jamestorrissonwong/NML-CAD/Fridge Lock and Mount/fridge render.png

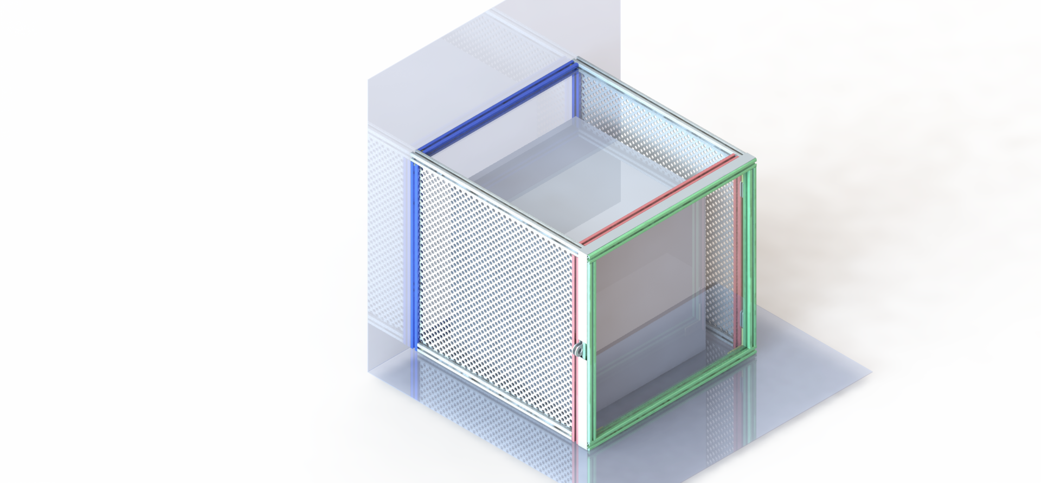
Fridge Lock and Mount/fridge render.png
