jamestorrissonwong/NML-CAD/EMGcuff.pptx

## EMG cuff Project

5/15/2021

Notes: wired connection between Myoware and arduino.
Include IMU

## Goal

- Design, build, and test a wearable sensor for measuring muscle activity in the forearm.

## Components

- Garment: Lightweight and comfortable cuff made of stretchable material that conforms to the forearm
- EMG Sensors: x4 Myoware (https://www.sparkfun.com/products/13723) (https://www.sparkfun.com/products/13723)sensors for measuring EMG; attached to lining of garment
- Microcontroller: Arduino or Raspberry Pi (Zero W), for collecting EMG signals from the EMG sensors
  - Controller Software
- Host: laptop or tablet
  - User Interface Software

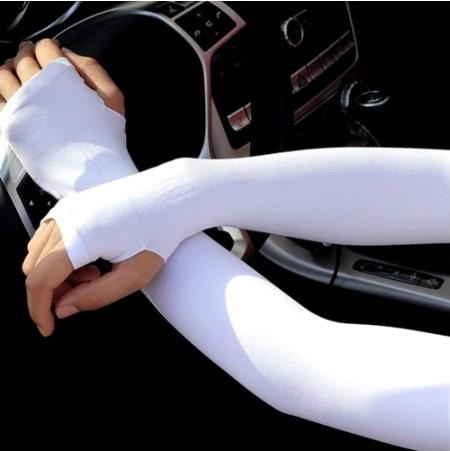
[picture p6: figure]
UV Protection Clothing Sun Sleeves
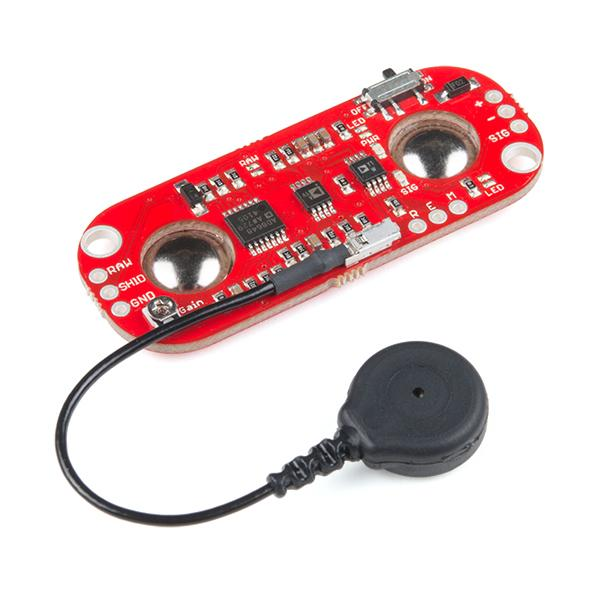
[picture p7: figure]
MyoWare Muscle Sensor
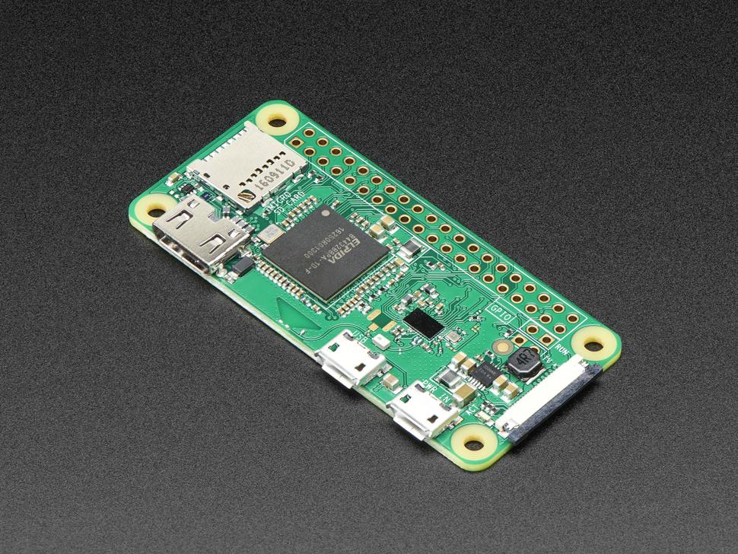
[picture p8: figure]
Angled shot of Raspberry Pi Zero W computer.
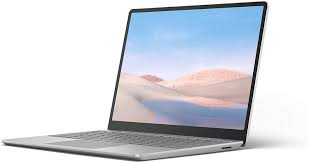
[picture p9: figure]
Amazon.com: Microsoft Surface Laptop Go - 12.4" Touchscreen - Intel Core i5 - 8GB Memory - 128GB SSD - Platinum: Computers & Accessories

## Recommended Software

- Autodesk tools
  - Electrical Design: TinkerCAD
  - Mechanical Design: Fusion360 OR Autodesk Inventor
- https://www.autodesk.com/education/edu-software/overview?sorting=featured&page=1

## Mechanical Goals

- Choose sleeve
- Determine how to attach electronics
- Can you ensure good contact between sensor & arm?
- Consider using CAD software to visual positioning of sensors, microcontroller, and wiring

## Electrical Goals

- Wiring between sensors and microcontroller
- Going from wired to wireless operations between microcontroller and host computer

## Programming Goals

- Collection of data from the EMG
- Classification of EMG data to different poses
