jamestorrissonwong/NML-CAD/Monkey Cage Training/ICTS Design.pdf

## Monkey ICTS

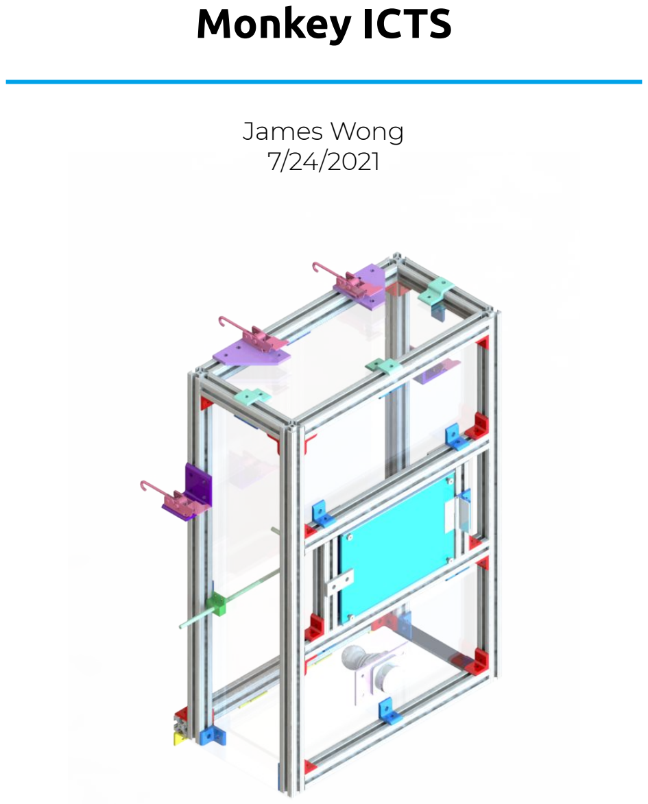
[picture p11: page 1]

James Wong
7/24/2021

### Overview

- Materials
- Attachment Method
- Reward System
- Screen Operation
- Optional Joystick

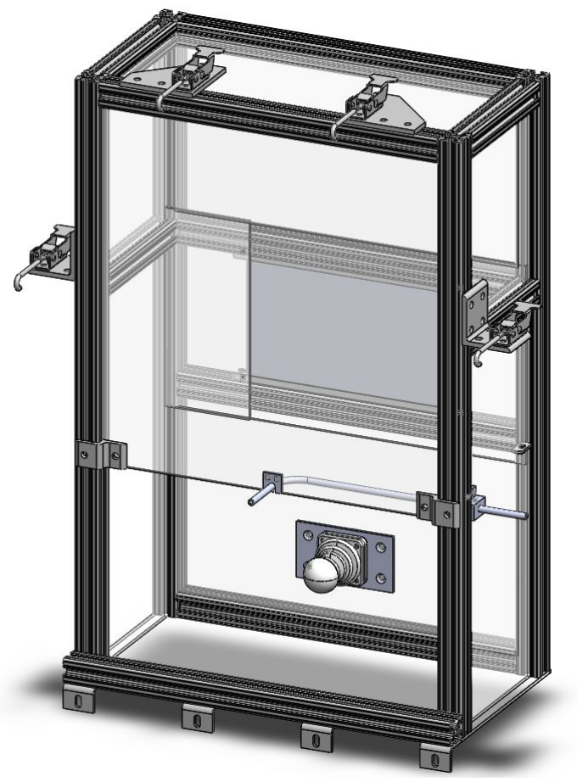
[picture p12: figure]

### Materials

- Framing made of 8020
- Enclosed on all sides by ⅛” polycarbonate (or acrylic)
- Some custom machined parts for reward system, tablet holder

BOM outlined below

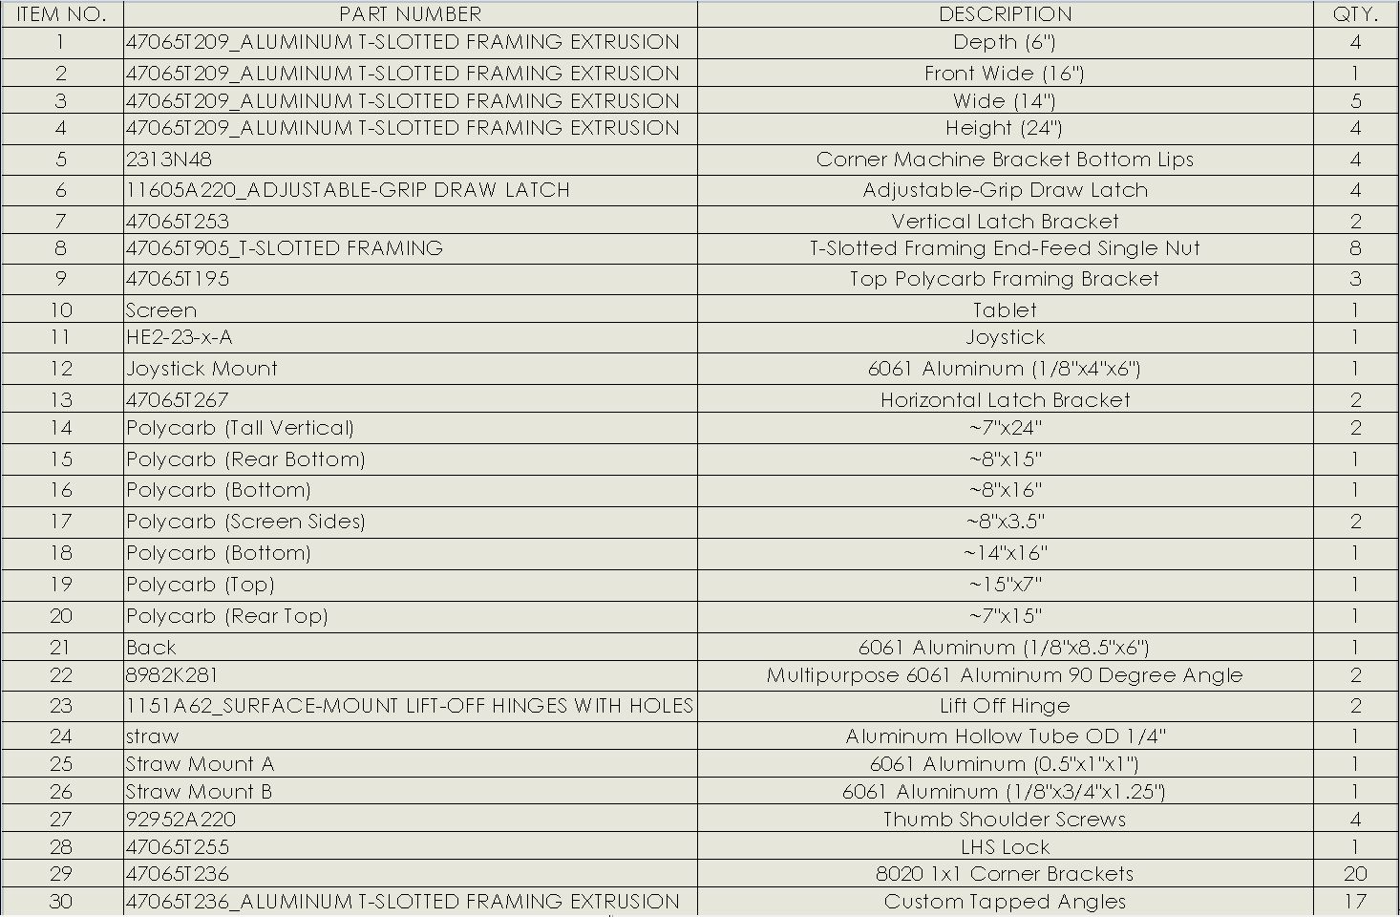
[picture p13: figure]

### Attachment Method

- Weight is carried primarily along bottom brackets (yellow)
- Latches (pink) provide additional support and contacts to the cage
- Adjustment to latches is available in vertical (dark purple) and horizontal (light purple) to accommodate different cage sizes

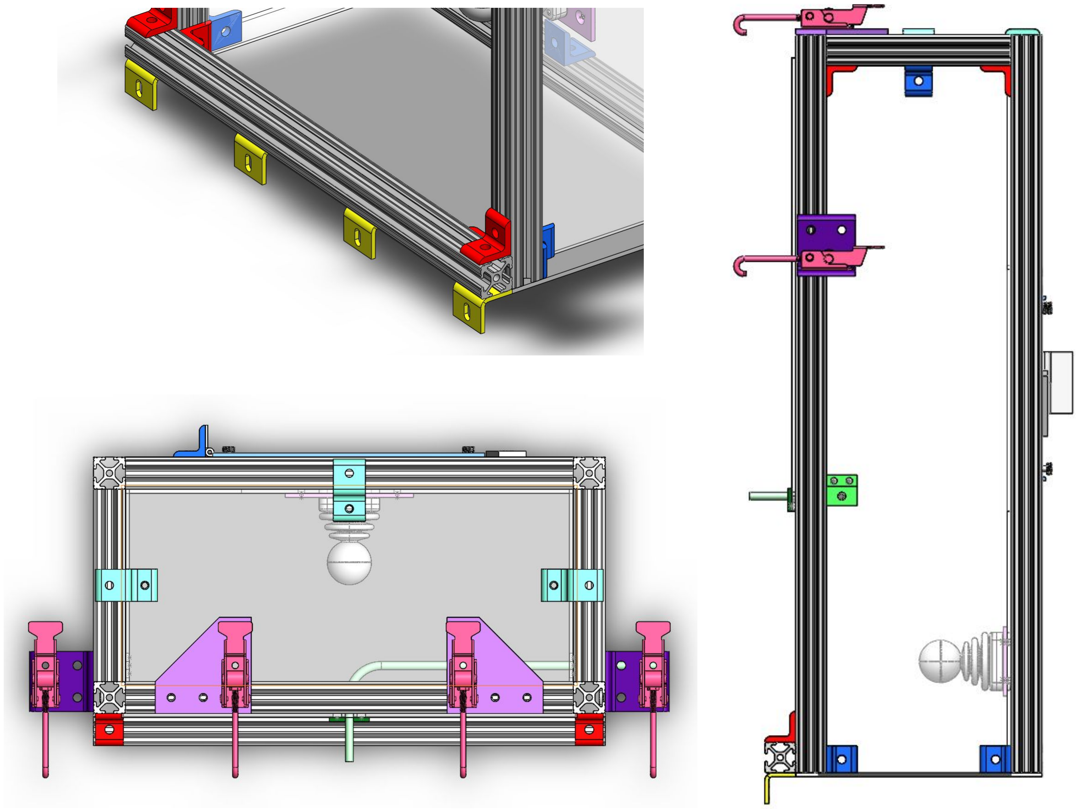
[picture p14: figure]
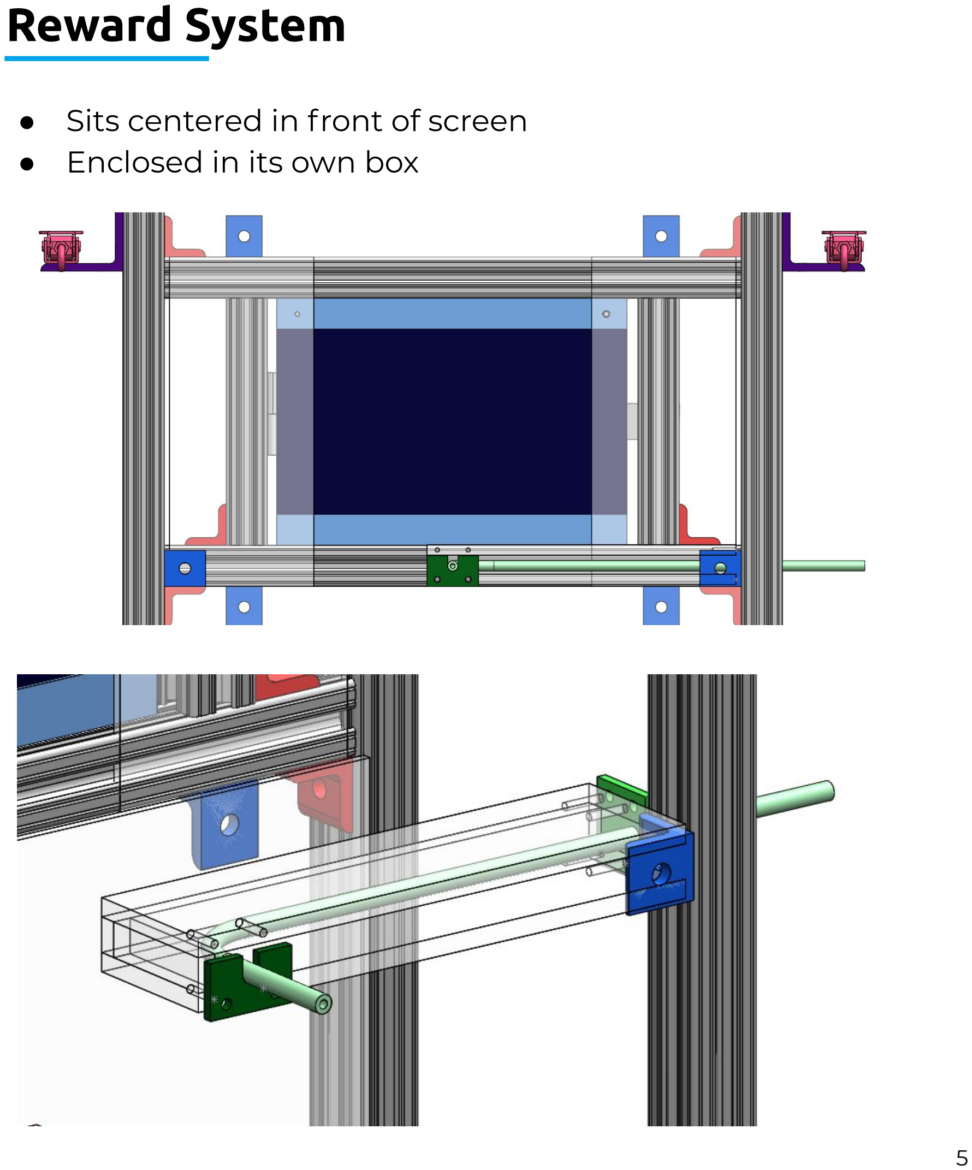
[picture p15: page 5]

### Reward System

- Sits centered in front of screen
- Enclosed in its own box

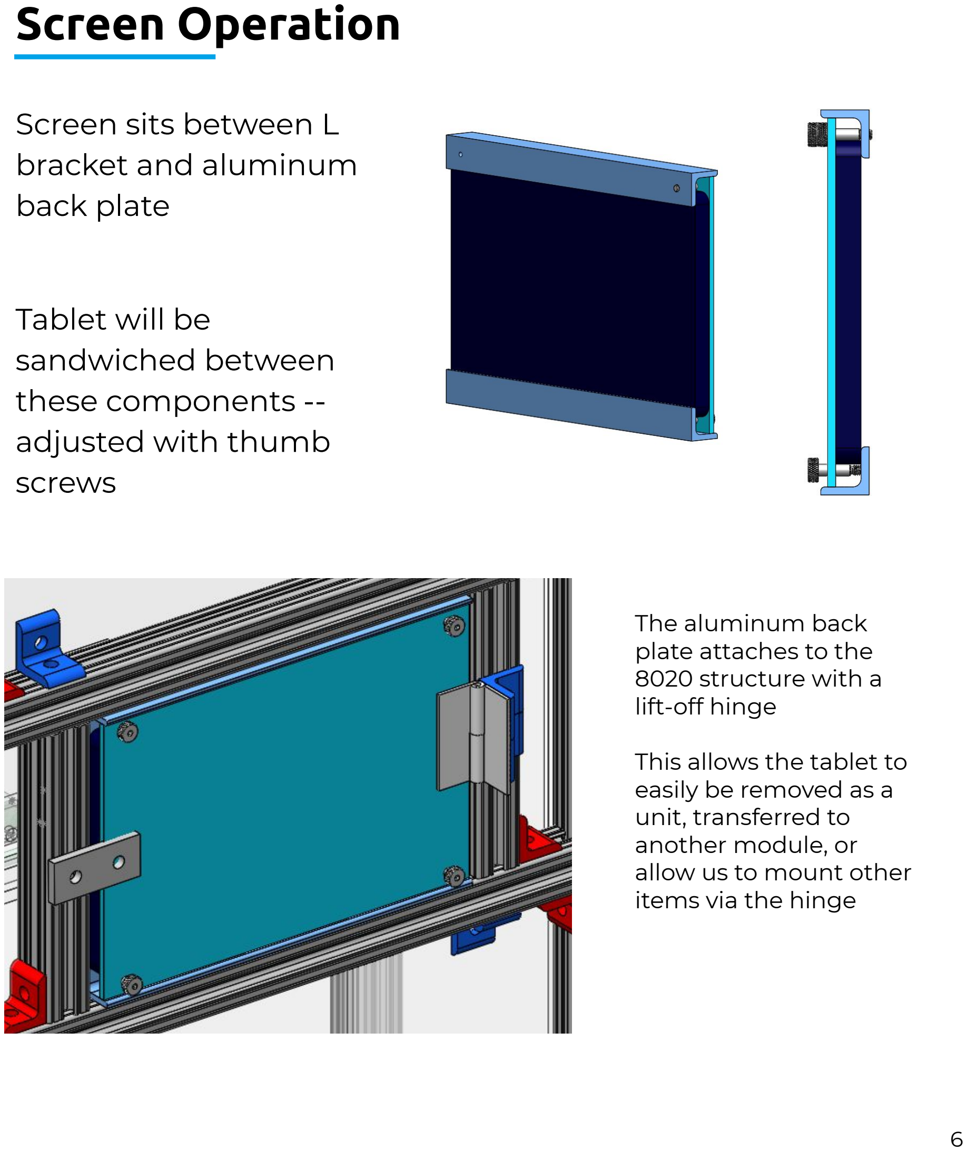
[picture p16: page 6]

### Screen Operation

Screen sits between L
bracket and aluminum
back plate

Tablet will be
sandwiched between
these components --
adjusted with thumb
screws

The aluminum back
plate attaches to the
8020 structure with a
lift-off hinge

This allows the tablet to
easily be removed as a
unit, transferred to
another module, or
allow us to mount other
items via the hinge

### Screen Operation

Click for animation

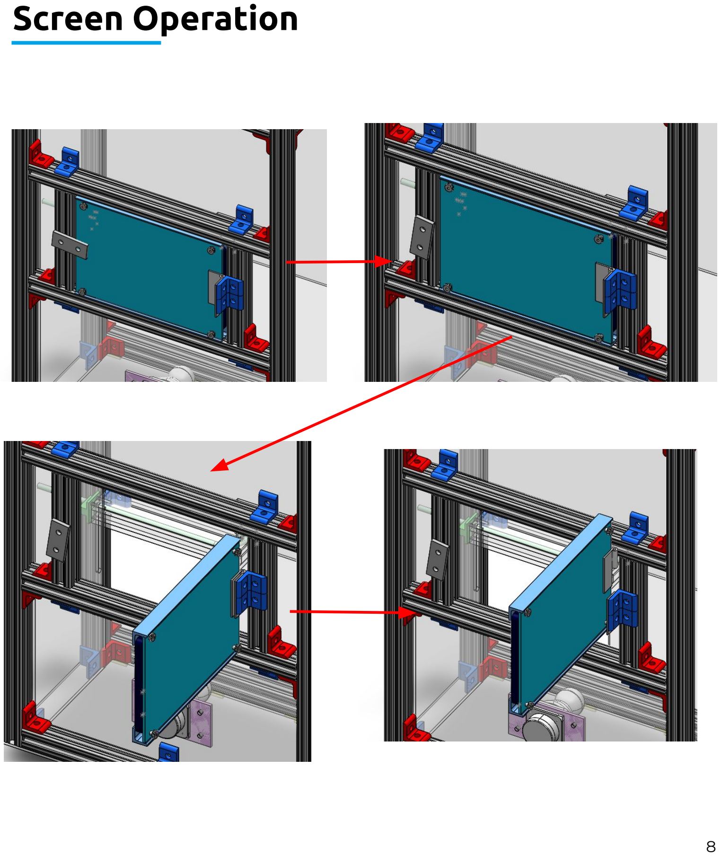
[picture p17: page 8]

### Screen Operation

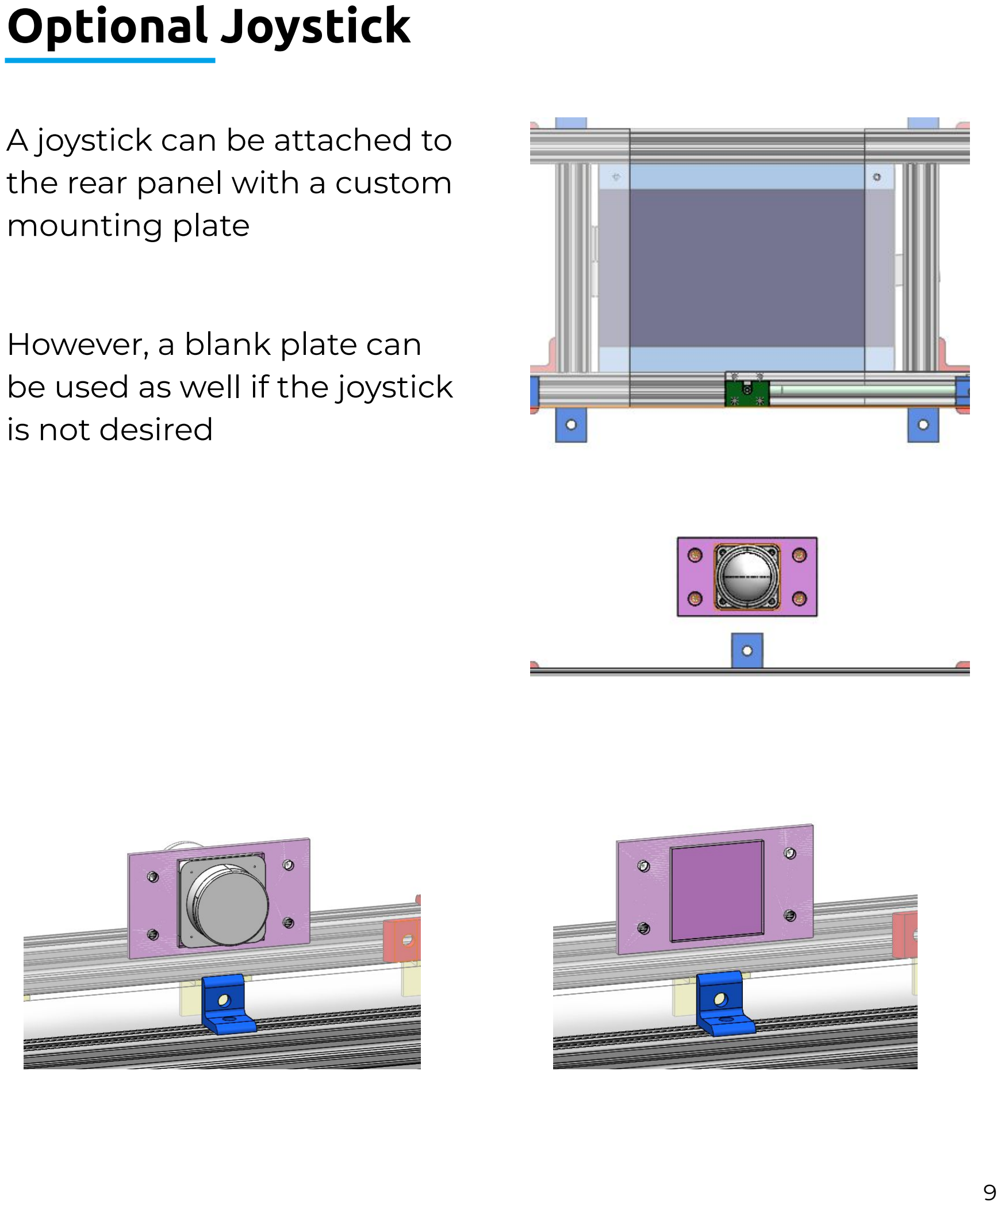
[picture p18: page 9]

### Optional Joystick

A joystick can be attached to the rear panel with a custom mounting plate

However, a blank plate can be used as well if the joystick is not desired
