jamestorrissonwong/NML-CAD/Monkey Cage Training/Cage opening dimensions.pdf

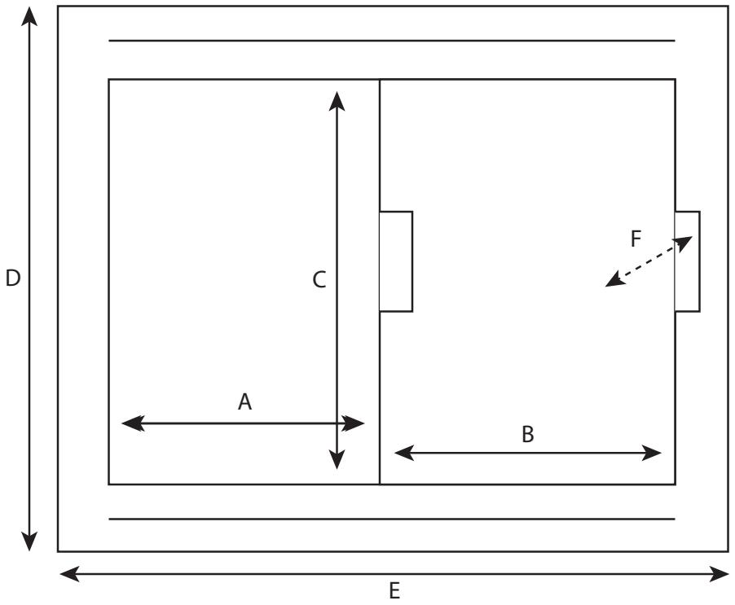
[picture p24: figure]

There are three dierent cage types in the vivarium. Thus, each letter has three dimensions. If we use springs with hooks to attach the device to the cage we should be able to accommodate the dierences for dimensions D & E. Below I am providing the smallest and largest dimension.

A = 10” - 12”
B = 10 4/16 - 14”
C = 17 14/16 - 18 12/16”
D = 20 2/16” - 20 8/16”
E = 22” - 22 4/16”
F = 3”
