jamestorrissonwong/NML-CAD/Proforma  Invoice - 20210621212100.pdf

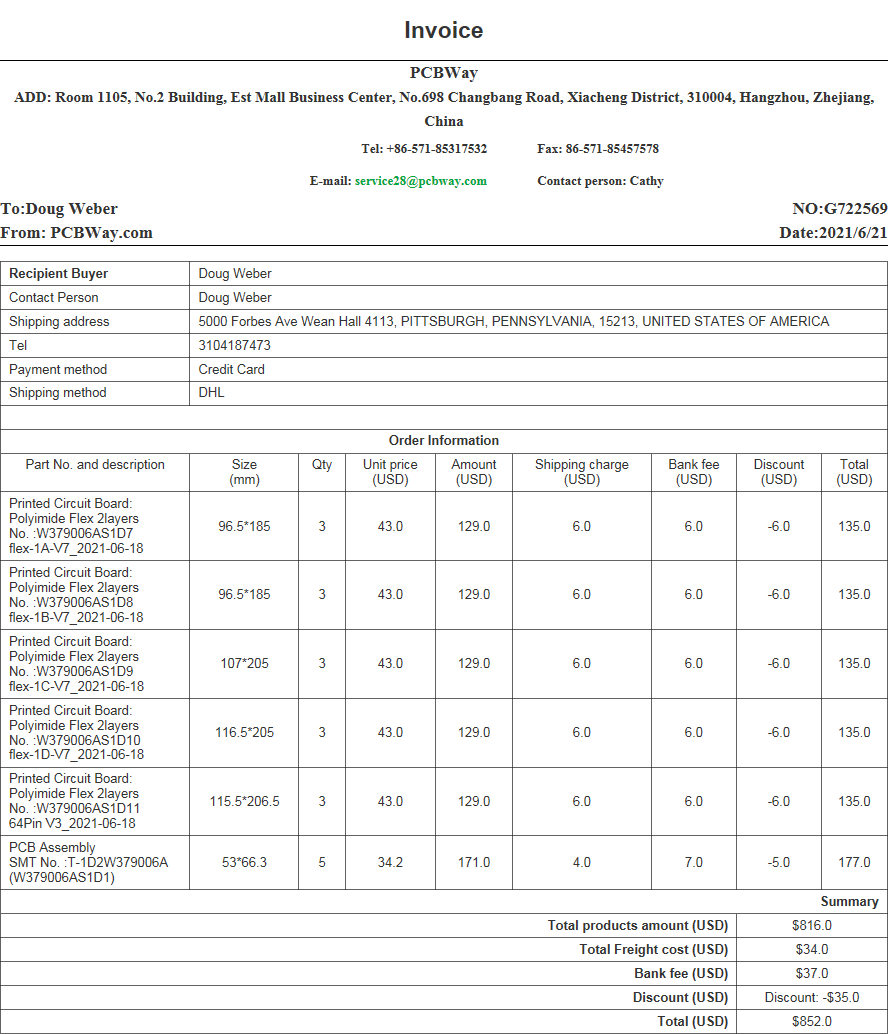
[picture p25: page 1]
