jamestorrissonwong/NML-CAD/Monkey Cage Training/ICTS dimensions.pdf

# InCage Training System

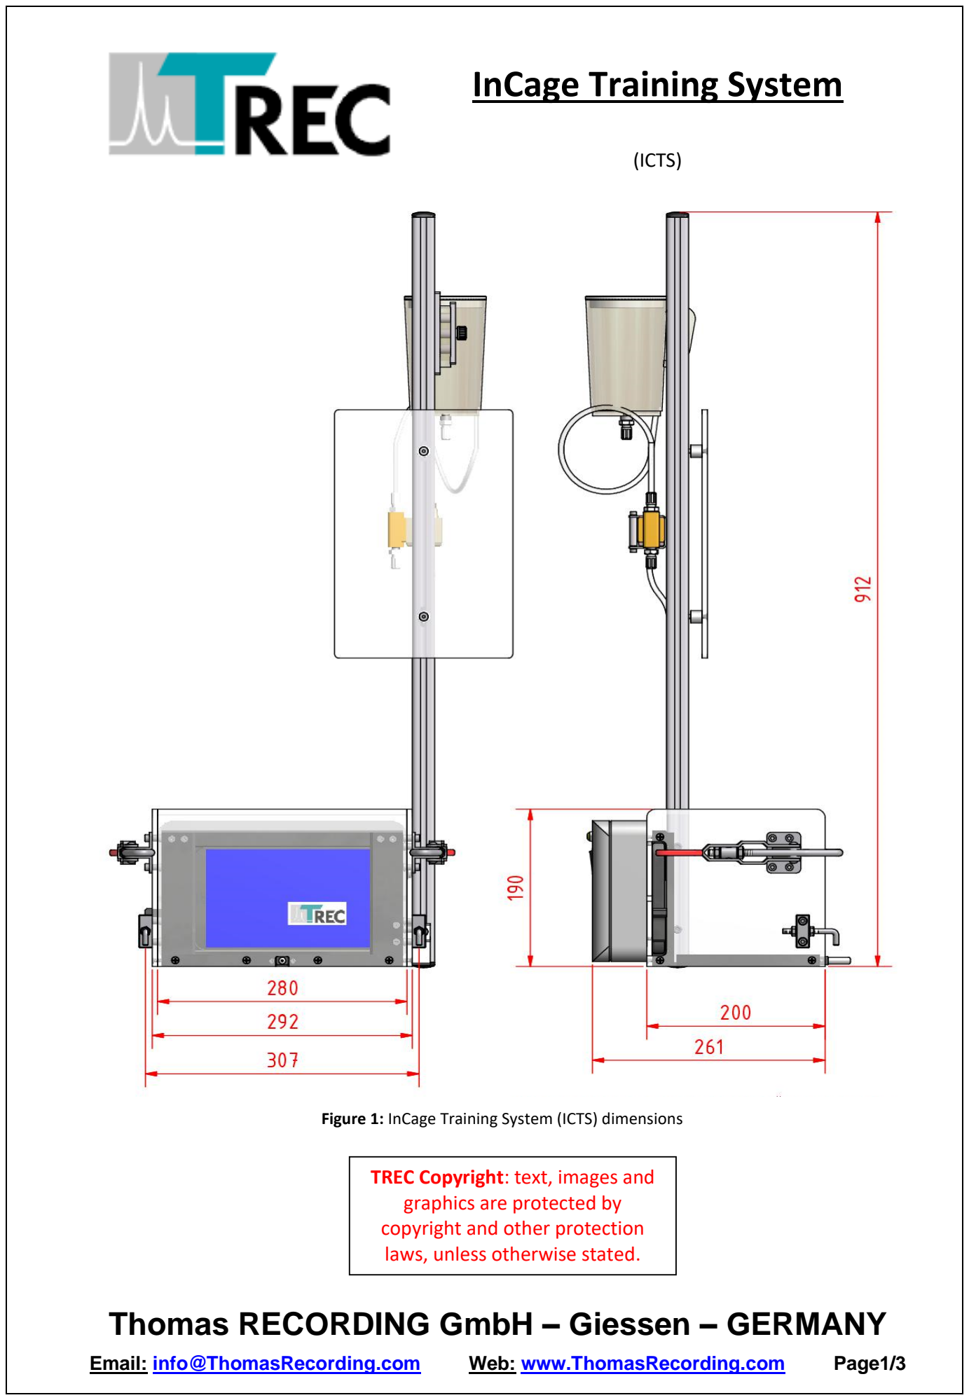
[picture p26: page 1]

## Thomas RECORDING GmbH – Giessen – GERMANY

Email: info@ThomasRecording.com | Web: www.ThomasRecording.com | Page1/3

(ICTS)

Figure 1: InCage Training System (ICTS) dimensions

TREC Copyright: text, images and graphics are protected by
copyright and other protection laws, unless otherwise stated.

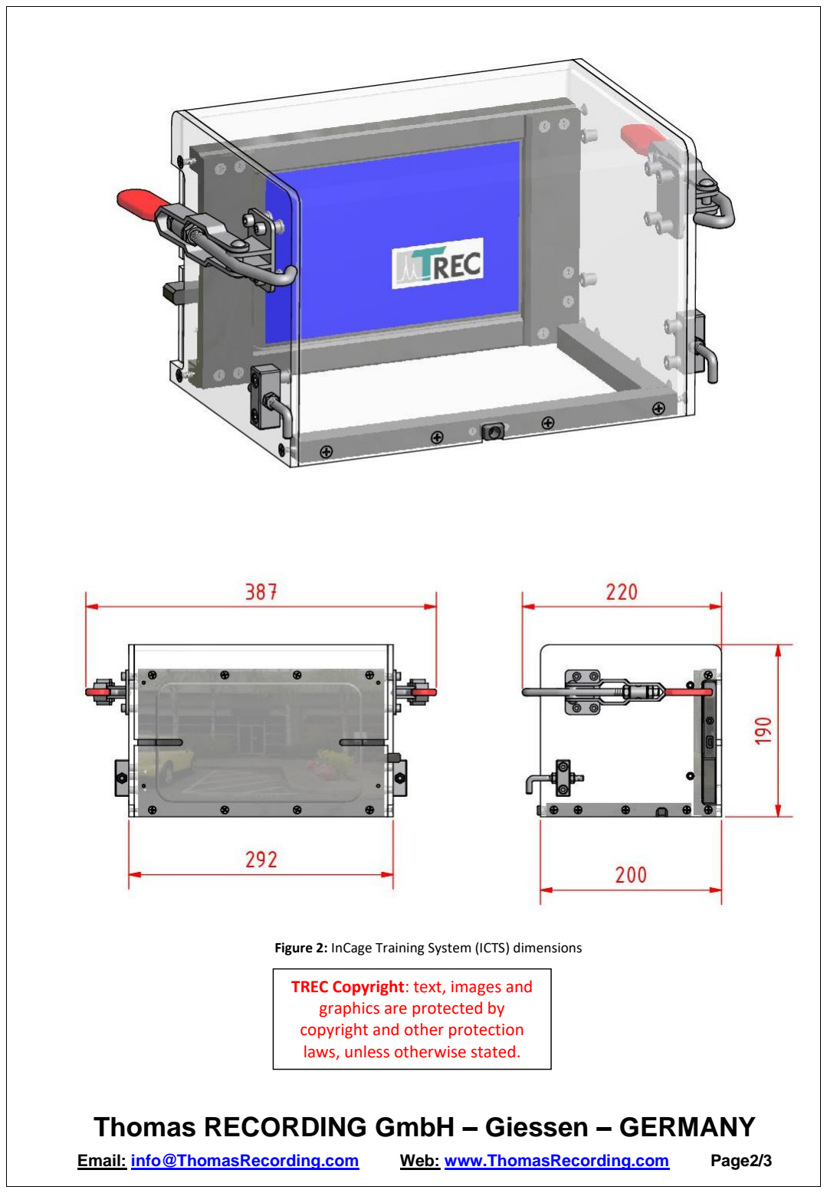
[picture p27: page 2]

Email: info@ThomasRecording.com | Web: www.ThomasRecording.com | Page2/3

Figure 2: InCage Training System (ICTS) dimensions

TREC Copyright: text, images and graphics are protected by
copyright and other protection
laws, unless otherwise stated.

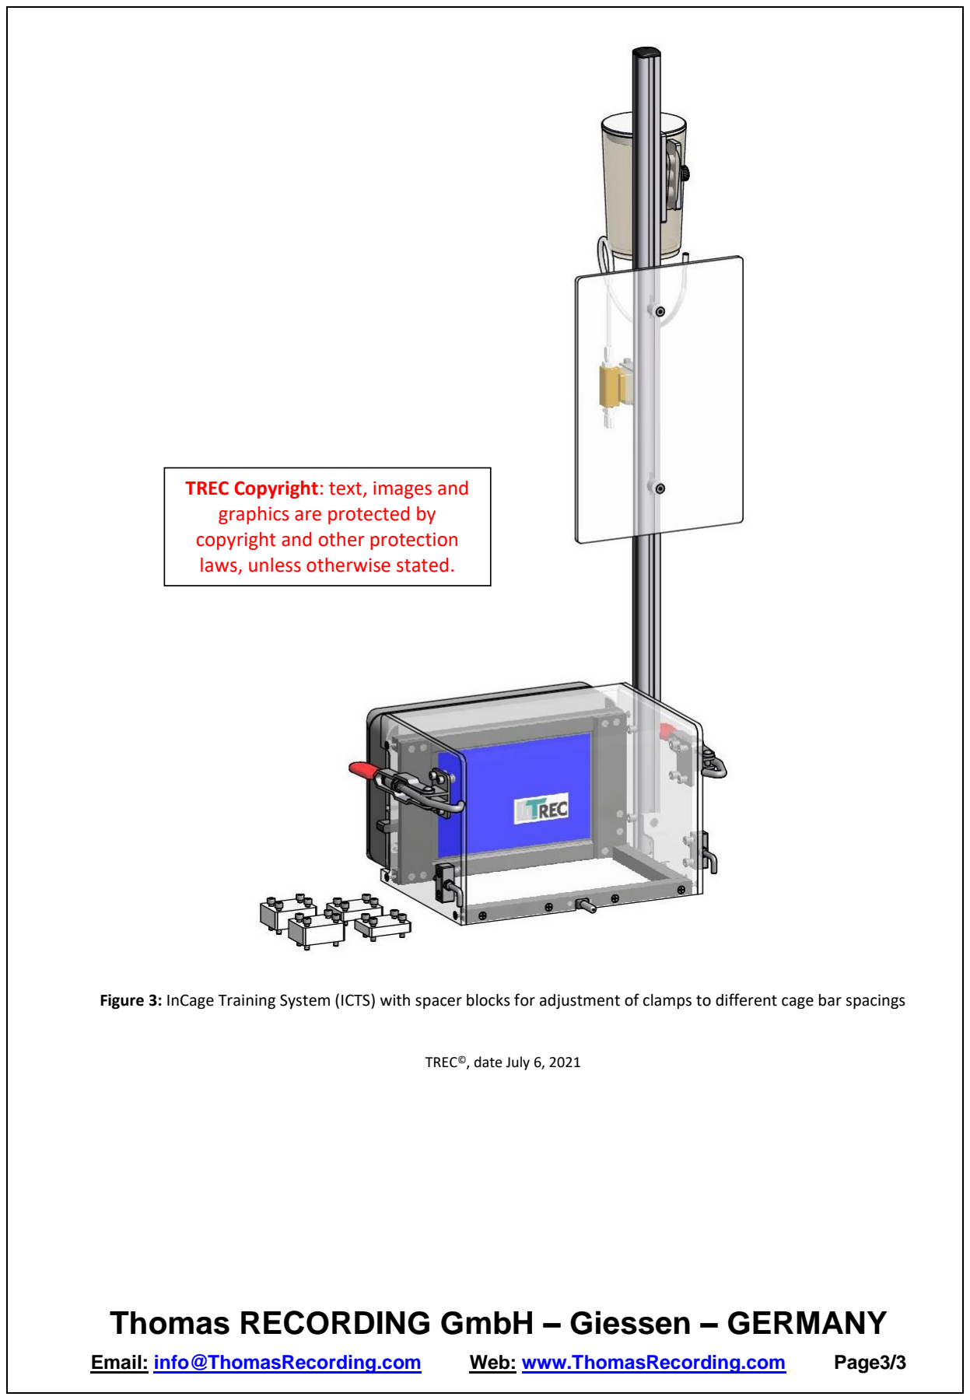
[picture p28: page 3]

Email: info@ThomasRecording.com | Web: www.ThomasRecording.com | Page3/3

Figure 3: InCage Training System (ICTS) with spacer blocks for adjustment of clamps to different cage bar spacings

TREC©, date July 6, 2021

TREC Copyright: text, images and graphics are protected by
copyright and other protection laws, unless otherwise stated.
