jamestorrissonwong/NML-CAD/Manips/Human Manip/Manip Render.png

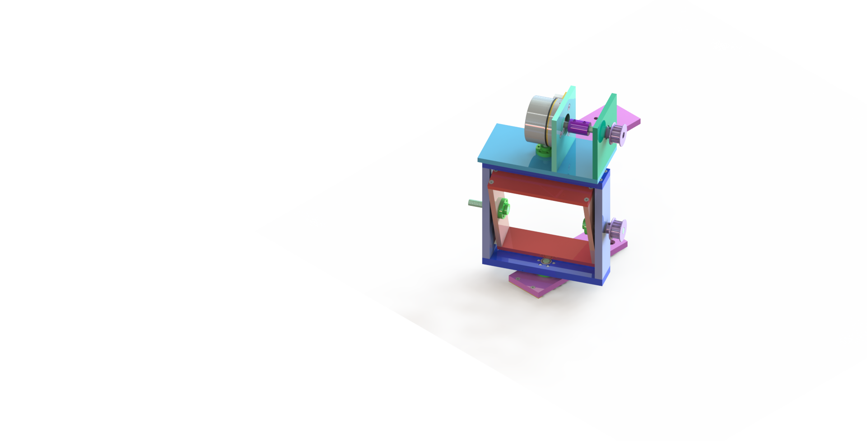
Manips/Human Manip/Manip Render.png
