jamestorrissonwong/NML-CAD/Monkey Cage Training/Monkey Cage Extension/ICTS Render.JPG

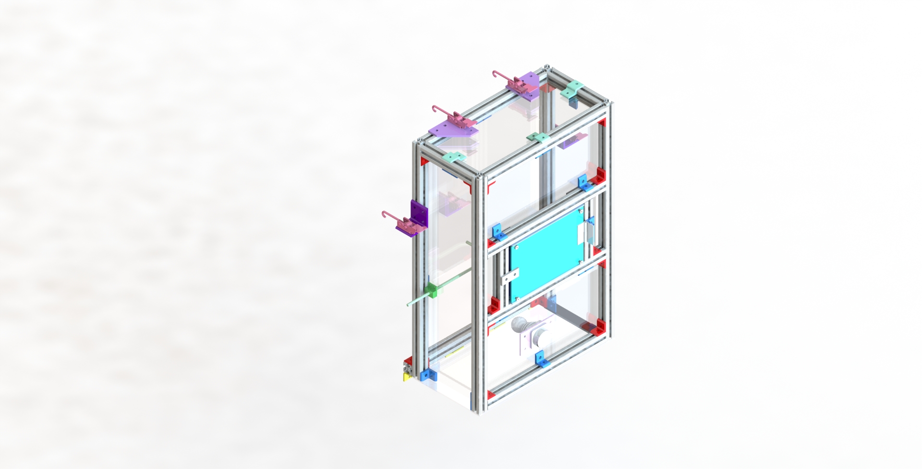
Monkey Cage Training/Monkey Cage Extension/ICTS Render.JPG
