jamestorrissonwong/NML-CAD/Monkey Cage Training/Monkey Cage Extension/ICTS Render.png

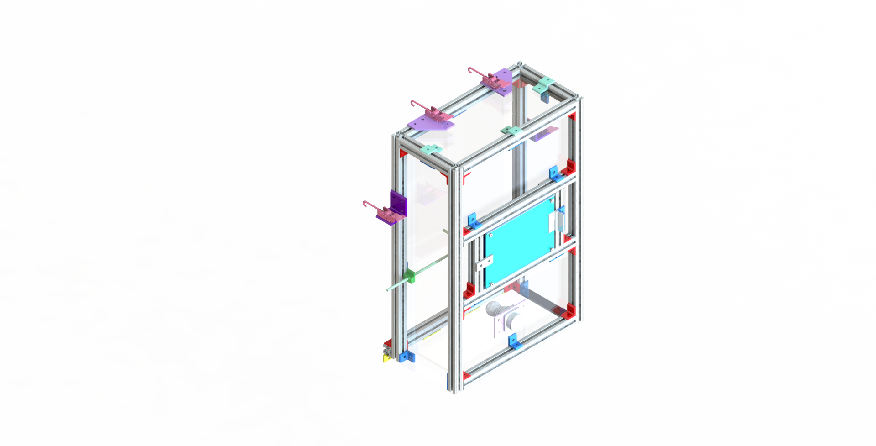
Monkey Cage Training/Monkey Cage Extension/ICTS Render.png
