jamestorrissonwong/NML-CAD/Purchase_RequestFORM -Fall 2021 Final.pdf

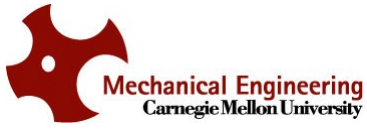
[picture p32: figure]

Requestor:
Date:
Email:
Phone Number:
Vendor:
Contact Name:
Email:
Address:
City, State, Zip:
Country:
Phone:
Website:

Sub-total:
Shipping:
Grand Total:

## Course Purchasing Request Form

5000 Forbes Avenue, Wean Hall Pittsburgh, PA 15213

Phone: 412-268-2500
Fax: 412-268-3348
www.cmu.edu/me
Professor:
Account:
Ship To:
Needed by:
Professor Approved?
Hazardous Material?
Purchase > $2500?
| | [ ] Yes | [ ] No
| | [ ] Yes | [ ] No
| | [ ] Yes | [ ] No
Quote Attached? | [ ] Yes | [ ] No
Part# | Description | Quantity Unit Price | Total

Justification for Purchase:

Notes: | SUBMIT ALL REQUESTS TO: MechE Purchasing me-purchasing@andrew.cmu.edu

updated 8/23/2021

also include a DIRECT link to the item on webpage.
