jamestorrissonwong/NML-CAD/Purchasing Request Form 2020 Manip 1.pdf

## Purchasing Request

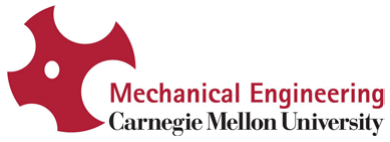
[picture p33: figure]
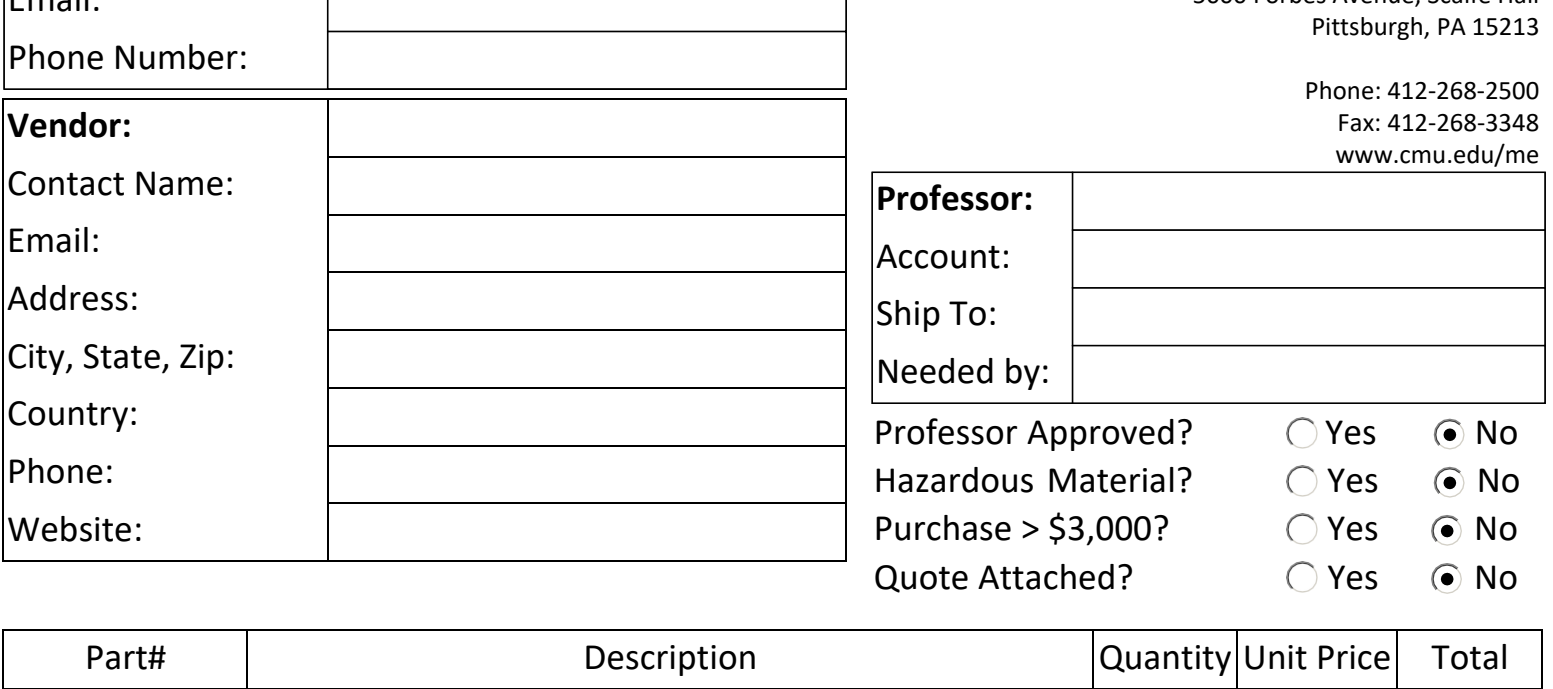
[picture p34: figure]
Pittsburgh, PA 15213; Phone: 412-268-2500 Fax: 412-268-3348 www.cmu.edu/me; Professor Approved? Hazardous Material? Purchase > $3,000?; Yes; Quote Attached?; Part#; Description; Quantity Unit Price; Total; Professor: Account: Ship To: Needed by:; Phone Number: Vendor: Contact Name: Email: Address: City, State, Zip: Country: Phone: Website:

5000 Forbes Avenue, Scaife Hall

Justification for Purchase:

Notes: Line Item 1 from: https://odriverobotics.com/shop/odrive-v36 Line Item 2 from: https://www.maxongroup.com/maxon/view/product/625854 Line Item 3 from: https://www.amazon.com/gp/product/B01IU8QBCO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 Line Item 4 from: https://www.pololu.com/product/2693 Remaining from McMaster

me-purchasing@andrew.cmu.edu

updated 08/01/2020

Requestor: James Wong
Date:
Email: 7/20/2021 JTW2@andrew.cmu.edu

Submit by Email

Sub-total:
Shipping:
Grand Total:
