jamestorrissonwong/NML-CAD/questions-T-1D2W379006A-W379006AS1D1-5sets-Intan Headstage BOM   2021-6-11.xlsx

 |  |  | COMPONENTS
5sets |  | Reply | Line | Name | Description | Designator | Quantity | Manufacturer | MPN | Type | Package/Footprint | Supplier | SPN
 | out of stock,is there any replacement? | We have some of these components, can do partial kitted assembly | 1 | Molex Slimstack | Male Connector | J1, J2 | 2 | Molex | 502430-6410 | SMD | SMD | Mouser | 538-50243-06412
$1.417 | 7-10work days |  | 2 | Molex ZIF Connector | 32 Pin ZIF Connector | P1, P2, P3, P4 | 4 | Molex | 505110-3291 | SMD | SMD | Mouser | 538-505110-3291
 | out of stock,is there any replacement? | We have some of these components, can do partial kitted assembly | 3 | Touchproof Connector | Grounding Connector | J3, J4 | 2 | P1 Tec | 36619 | PTH |  | P1 Tec | 36619
 |  |  | LAYER STACK
 |  |  |  | File Name | Description | Material | Thicnkess
 |  |  |  | silkscreen_top.gbr | Top Silkscreen
 |  |  |  | soldermask_top.gbr | Top Soldermask | Soldermask
 |  |  |  | copper_top.gbr | Top Copper, 1 | Copper | 1 oz
 |  |  |  |  | Core | Fr4 (TG130-140)
 |  |  |  | copper_bottom.gbr | Bottom Copper, 2 | Copper | 1 oz
 |  |  |  | soldermask_bottom.gbr | Bottom Soldermask | Soldermask
 |  |  |  | silkscreen_bottom.gbr | Bottom Silkscreen
 |  |  |  | drill_1_16.xln | Drills |  | Through
 |  |  |  | Additional Gerbers
 |  |  |  | profile.gbr | Board Outline
 |  |  |  | solderpaste_top.gbr | Top Paste
 |  |  |  | solderpaste_bottom.gbr | Bottom Paste
provide according to MPN
