jamestorrissonwong/NML-CAD/Fridge Lock and Mount/Fridge Cage.SLDASM

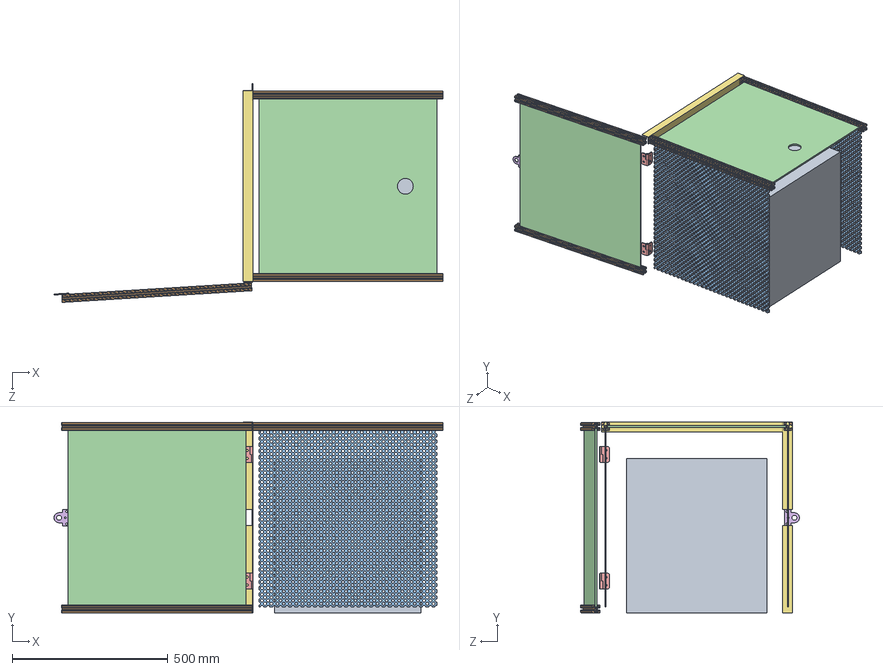
[picture p35: CAD file, 2021-12-15]
Fridge Lock and Mount/Fridge Cage.SLDASM
1247.3 x 611.2 x 701.9 mm
Fridge
47065T209_ALUMINUM T-SLOTTED FRAMING EXTRUSION x 4
47065T901_ALUMINUM T-SLOTTED FRAMING EXTRUSION x 2
47065T321_T-SLOTTED FRAMING x 2
47065T343_T-Slotted Framing x 4
1183A110_PADLOCKABLE EYE x 2
8982K602_Multipurpose 6061 Aluminum 90 Degree Angle
