jamestorrissonwong/NML-CAD/Manips/Monkey Manip/Angle A/45 Stop vA.SLDASM

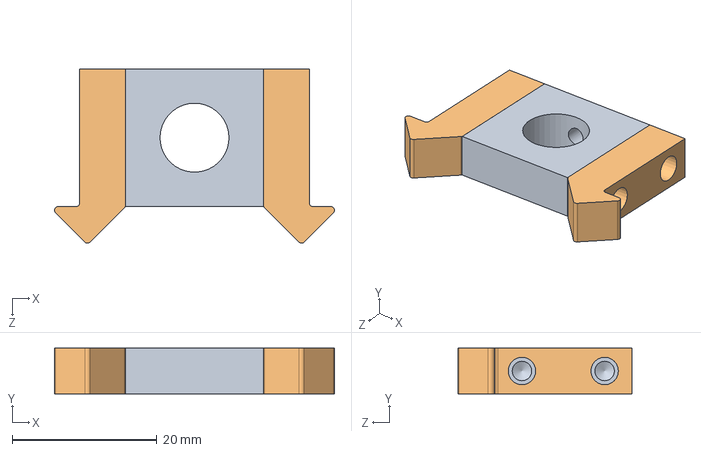
[picture p36: CAD file, 2021-07-24]
Manips/Monkey Manip/Angle A/45 Stop vA.SLDASM
38.7 x 6.35 x 24.1 mm
45 Stop Mid
45 Stop Arm x 2
