jamestorrissonwong/NML-CAD/Manips/Monkey Manip/Angle C/45 Stop vC.SLDASM

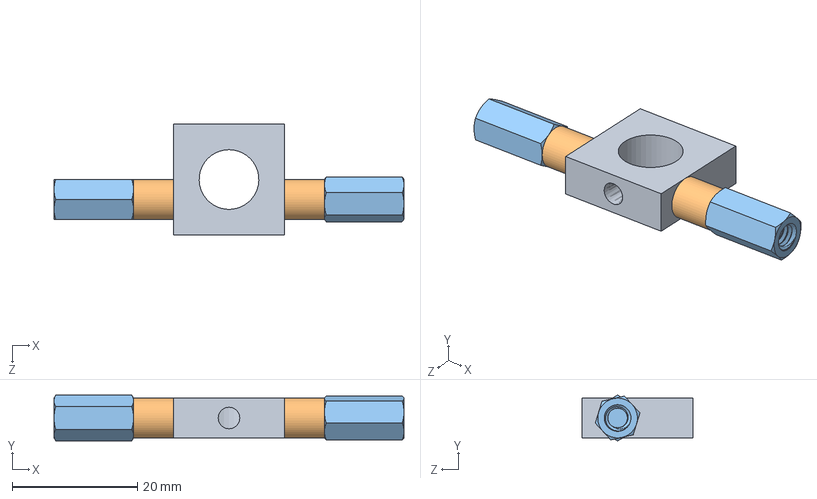
[picture p37: CAD file, 2021-07-24]
Manips/Monkey Manip/Angle C/45 Stop vC.SLDASM
55.9 x 7.33 x 17.8 mm
45 Stop Hub
92510A462_ALUM UNTHRD SPACER x 2
91075A452_18-8 SS MALE-FEM THRDED HEX STANDOFF x 2
