jamestorrissonwong/NML-CAD/Manips/Monkey Manip/Angle D/45 Stop vD.SLDASM

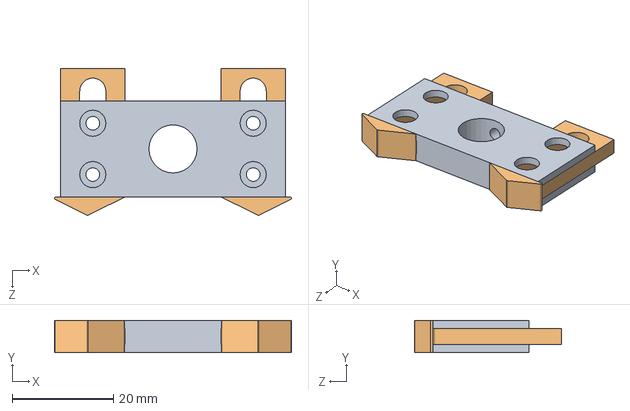
[picture p38: CAD file, 2021-07-24]
Manips/Monkey Manip/Angle D/45 Stop vD.SLDASM
46.9 x 6.35 x 29.0 mm
45 Stop Mid v2
45 Stop Arm v2 x 2
