jamestorrissonwong/NML-CAD/Manips/Monkey Manip/Angle E/45 Stop vE.SLDASM

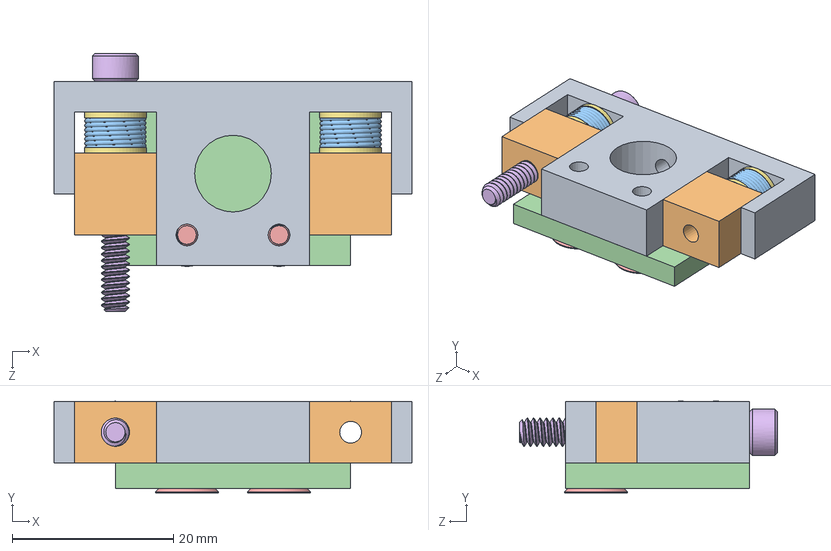
[picture p39: CAD file, 2021-07-27]
Manips/Monkey Manip/Angle E/45 Stop vE.SLDASM
44.5 x 11.4 x 32.1 mm
45 Stop Mid v3
45 Stop Arm v3 x 2
9657K329_COMPRESSION SPRING x 2
Guard Plate
91253A145_ALLOY STEEL FLAT-HEAD SOCKET CAP SCREW x 2
95630A241_PTFE FLAT WASHER x 4
