jamestorrissonwong/NML-CAD/Manips/Monkey Manip/Cover/Cover Assm vA.SLDASM

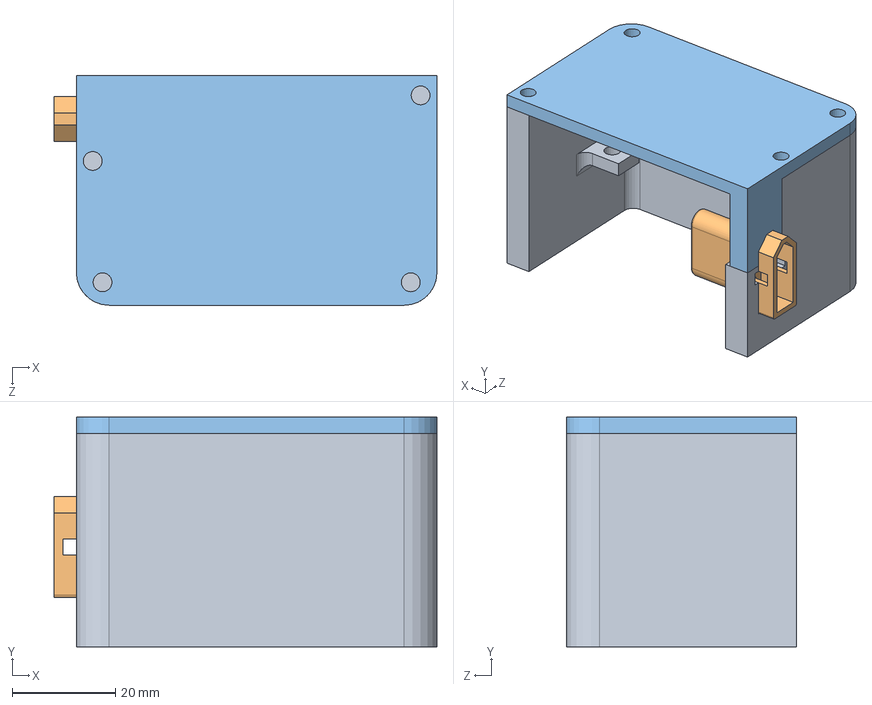
[picture p40: CAD file, 2022-06-04]
Manips/Monkey Manip/Cover/Cover Assm vA.SLDASM
74.2 x 44.5 x 44.5 mm
Cover vA
69295K830_COMPACT PUSH-IN CONNECTOR
Cover Top vA
