jamestorrissonwong/NML-CAD/Manips/Monkey Manip/Monkey Manip Assem.SLDASM

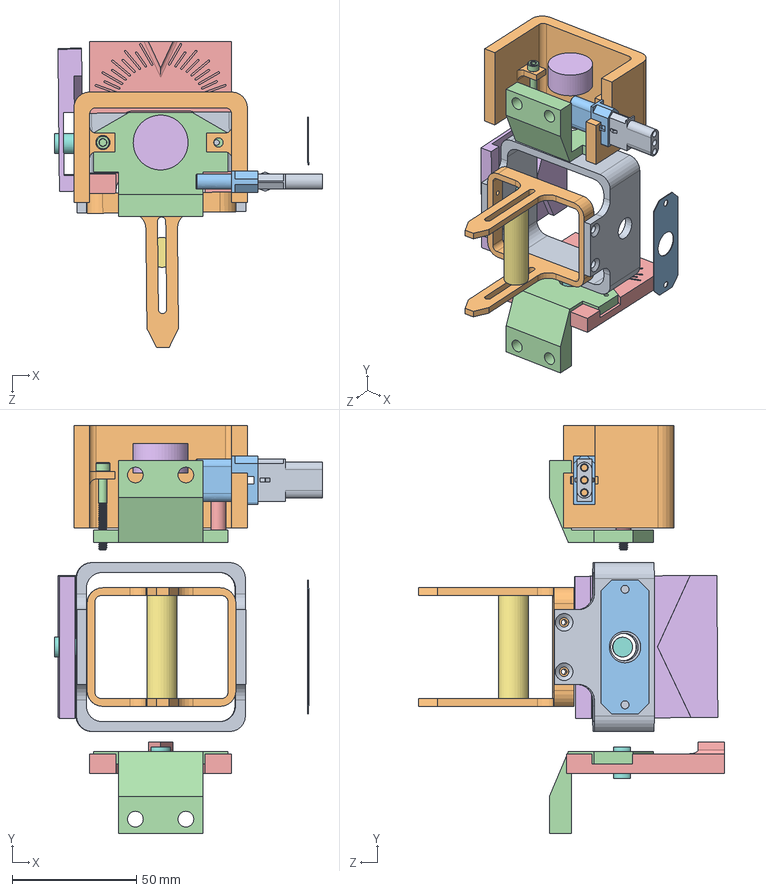
[picture p41: CAD file, 2022-08-11]
Manips/Monkey Manip/Monkey Manip Assem.SLDASM
107.9 x 164.1 x 123.1 mm
Mid Square
Small Square
Large Square Mount x 2
Shaft x 2
Limiter U22
