jamestorrissonwong/NML-CAD/Monkey Cage Training/Acrylic ICTS/DXFs for Cutting/Full Panel 2.DXF

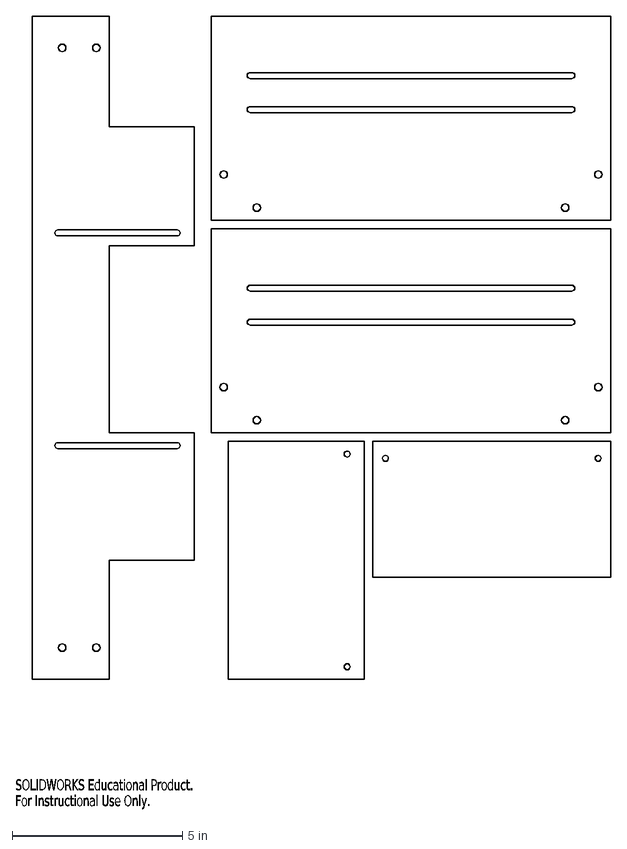
[picture p42: CAD file, 2022-02-23]
Monkey Cage Training/Acrylic ICTS/DXFs for Cutting/Full Panel 2.DXF
SOLIDWORKS Educational Product.
For Instructional Use Only.
