jamestorrissonwong/NML-CAD/Monkey Cage Training/Acrylic ICTS/TREC Mod/TREC Assem.SLDASM

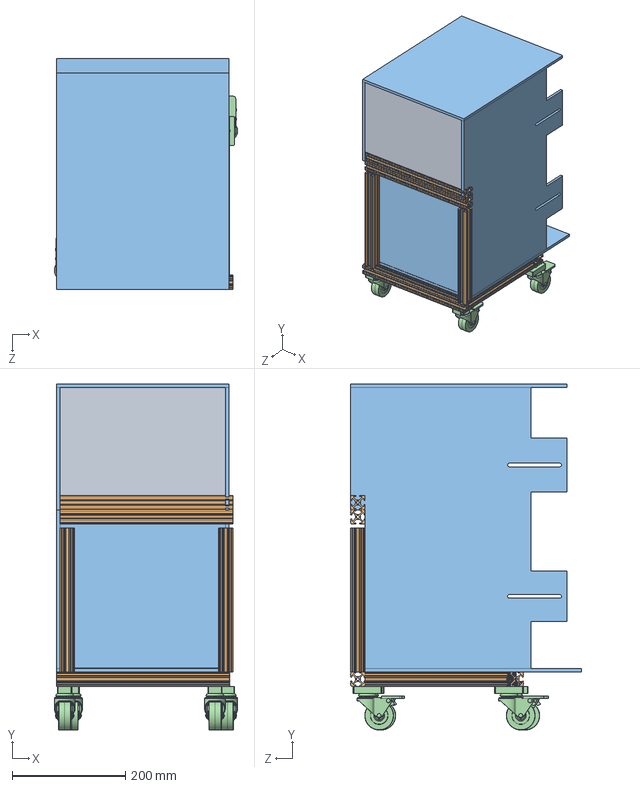
[picture p43: CAD file, 2021-12-15]
Monkey Cage Training/Acrylic ICTS/TREC Mod/TREC Assem.SLDASM
323.4 x 610.4 x 407.1 mm
TREC
47065T209_ALUMINUM T-SLOTTED FRAMING EXTRUSION x 8
TM-Acrylic x 5
47065T83_70 lb. Capacity Plate Mount Swivel Caster for T-Slotted Framing x 4
