jamestorrissonwong/NML-CAD/Monkey Cage Training/Monkey Cage Extension/bendy assem.SLDASM

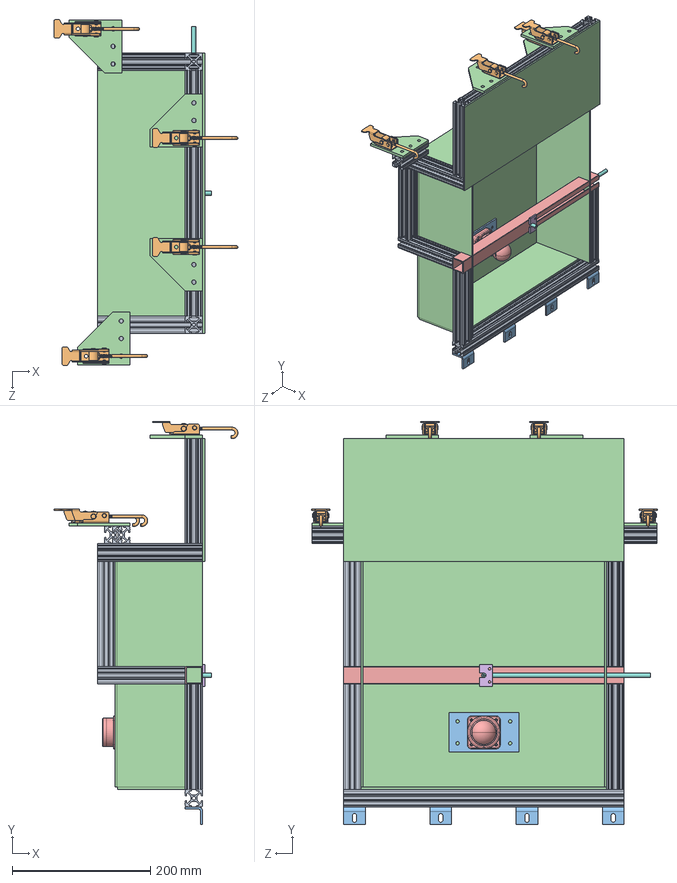
[picture p44: CAD file, 2021-08-06]
Monkey Cage Training/Monkey Cage Extension/bendy assem.SLDASM
266.2 x 583.4 x 500.6 mm
47065T209_ALUMINUM T-SLOTTED FRAMING EXTRUSION x 17
11605A220_ADJUSTABLE-GRIP DRAW LATCH x 4
2313N48_CORNER MACHINE BRACKET x 4
47065T267_ALUMINUM T-SLOTTED FRAMING EXTRUSION x 4
HE2-23-x-A
Back
Screen
straw
8982K281_Multipurpose 6061 Aluminum 90 Degree Angle x 2
92952A220_THUMB-GRIP 18-8 SS PRECISION SHOULDER SCREW
Joystick Mount
acrylic lightweight x 6
8516K37_CLEAR SCRATCH AND UV-RESISTANT ACRYLIC RECTANGULAR TUBE
Straw Mount B
