jamestorrissonwong/NML-CAD/Monkey Chair/Attachment/Kick Blocker Assembly.SLDASM

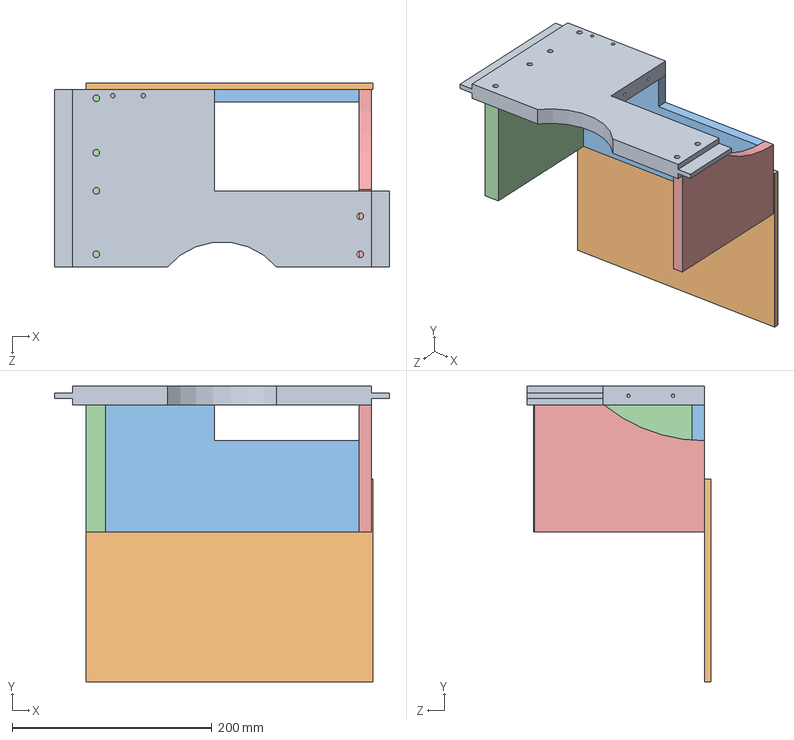
[picture p45: CAD file, 2022-06-11]
Monkey Chair/Attachment/Kick Blocker Assembly.SLDASM
335.3 x 295.9 x 184.1 mm
Top Plate
Front Panel
Front Reinforcement Panel
Side Panel B
Side Panel
