jamestorrissonwong/NML-CAD/Monkey Sippers/Monkey Sipper/COTS Carriage/COTS Assem.SLDASM

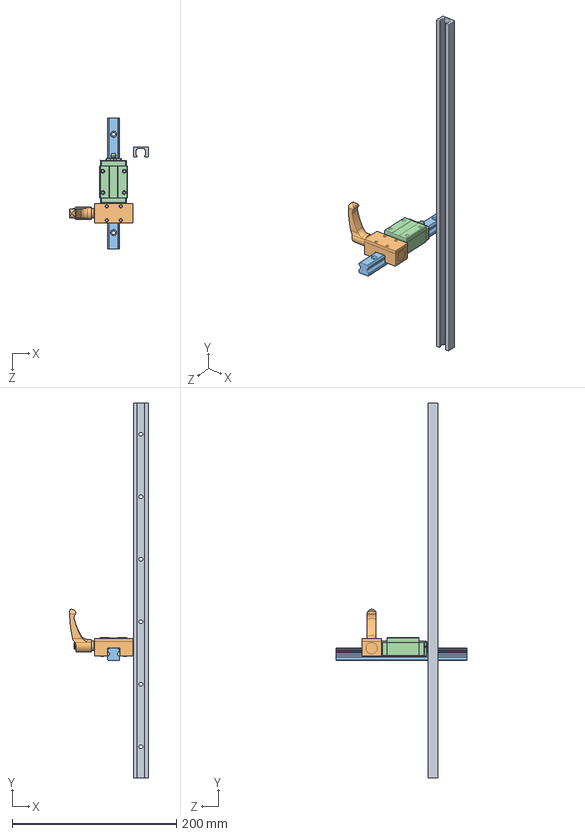
[picture p46: CAD file, 2021-07-24]
Monkey Sippers/Monkey Sipper/COTS Carriage/COTS Assem.SLDASM
95.9 x 457.2 x 160.0 mm
1850A110_T-SLOTTED TRACK
1685N600_HAND BRAKE FOR BALL BEARING CARRIAGE
6709K301_BALL BEARING CARRIAGE
6709K120_BALL BEARING CARRIAGE
