jamestorrissonwong/NML-CAD/Ernesto/Forearm Platform/8020 Assem.SLDASM

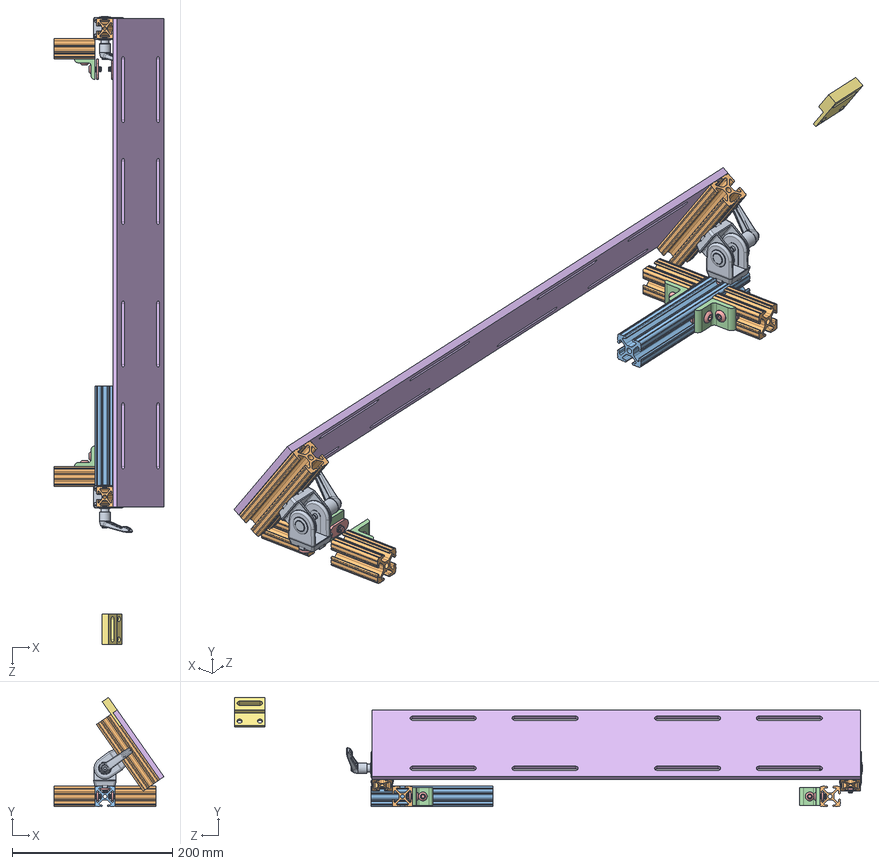
[picture p47: CAD file, 2021-08-02]
Ernesto/Forearm Platform/8020 Assem.SLDASM
137.1 x 136.2 x 783.3 mm
47065T221_ALUMINUM T-SLOTTED FRAMING EXTRUSION x 2
47065T411_ALUMINUM T-SLOTTED FRAMING EXTRUSION x 6
47065T209_ALUMINUM T-SLOTTED FRAMING EXTRUSION
47065T236_ALUMINUM T-SLOTTED FRAMING EXTRUSION x 4
47065T139_ALUMINUM T-SLOTTED FRAMING EXTRUSION x 10
Polycarb plate
