jamestorrissonwong/NML-CAD/Fridge Lock and Mount/Fridge Tie Down.SLDASM

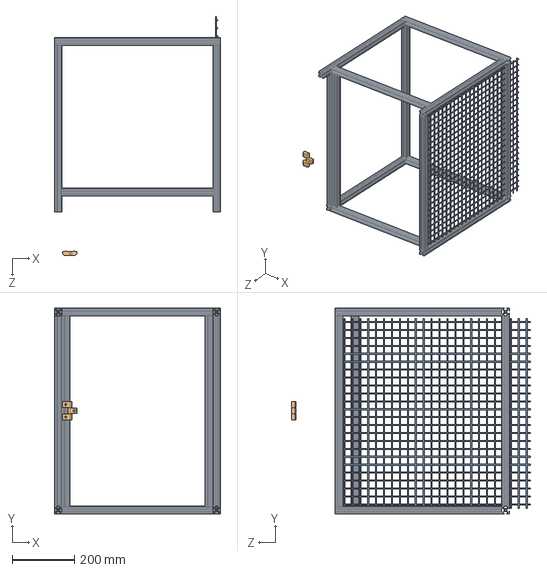
[picture p48: CAD file, 2021-08-06]
Fridge Lock and Mount/Fridge Tie Down.SLDASM
533.4 x 660.4 x 767.3 mm
47065T209_ALUMINUM T-SLOTTED FRAMING EXTRUSION x 14
