jamestorrissonwong/NML-CAD/Monkey Cage Training/Acrylic ICTS/AA3.SLDASM

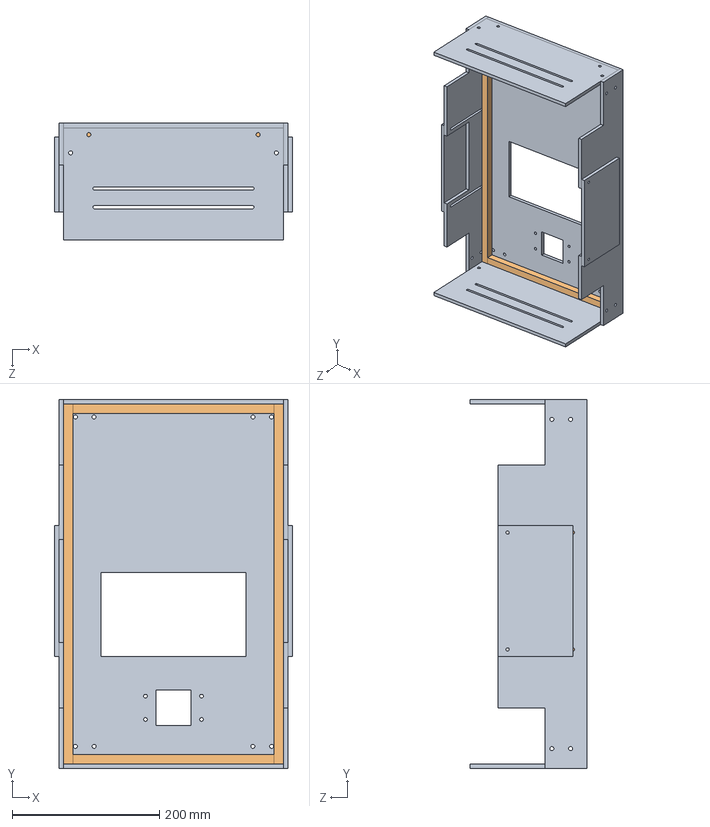
[picture p49: CAD file, 2021-12-19]
Monkey Cage Training/Acrylic ICTS/AA3.SLDASM
323.9 x 501.6 x 158.8 mm
Acrylic x 7
Delrin x 4
