jamestorrissonwong/NML-CAD/Monkey Cage Training/Acrylic ICTS/DXFs for Cutting/Full Panel 1.DXF

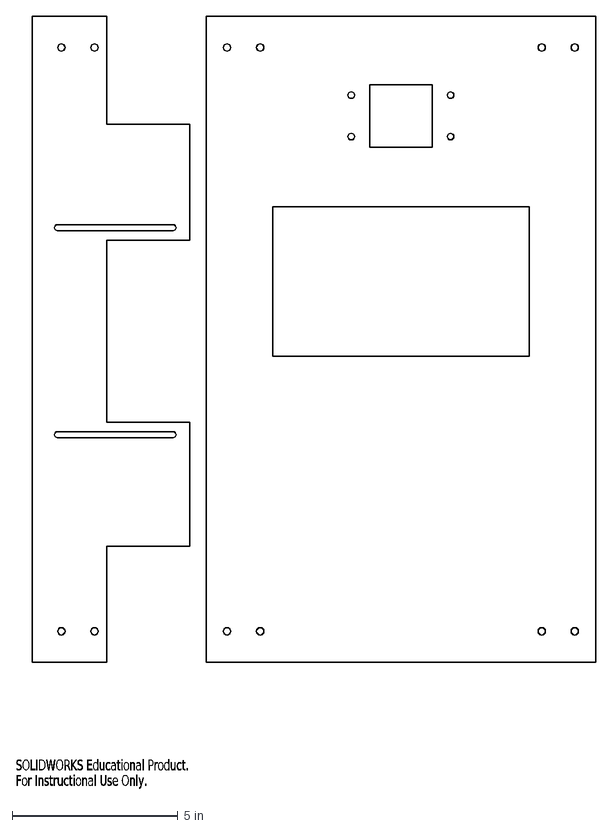
[picture p50: CAD file, 2022-02-23]
Monkey Cage Training/Acrylic ICTS/DXFs for Cutting/Full Panel 1.DXF
SOLIDWORKS Educational Product.
For Instructional Use Only.
