jamestorrissonwong/NML-CAD/Monkey Chair/Arm Restraints/Arm Pipe Caps Assm.SLDASM

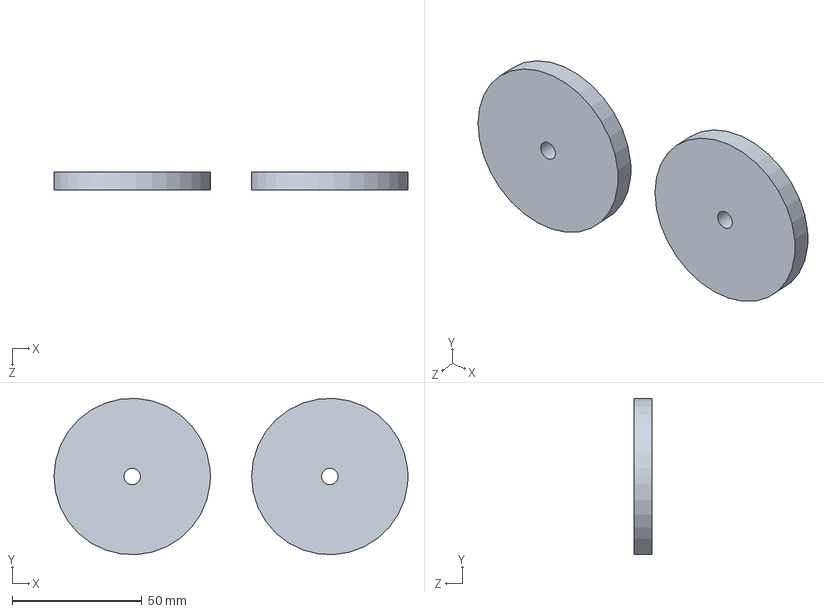
[picture p51: CAD file, 2022-08-11]
Monkey Chair/Arm Restraints/Arm Pipe Caps Assm.SLDASM
136.5 x 60.2 x 7.11 mm
Arm Pipe Cap x 2
