jamestorrissonwong/NML-CAD/Monkey Cage Training/Monkey Cage Extension/cage/Cage.SLDASM

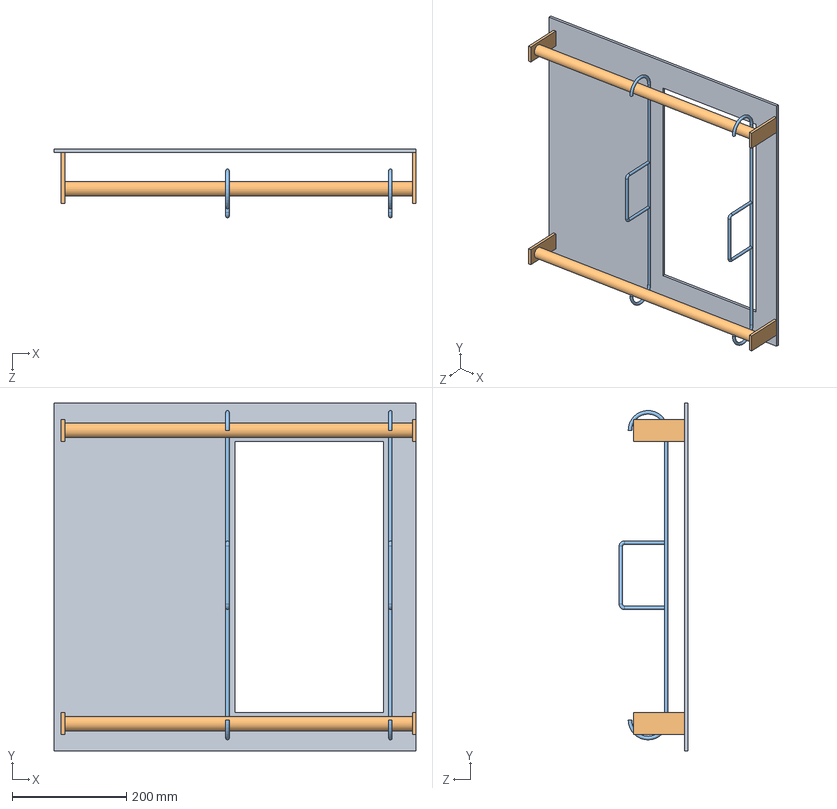
[picture p52: CAD file, 2021-08-06]
Monkey Cage Training/Monkey Cage Extension/cage/Cage.SLDASM
635.0 x 609.6 x 120.7 mm
front wall
rail x 2
Door End x 2
