jamestorrissonwong/NML-CAD/Manips/Torque Manip/Support Cube.SLDASM

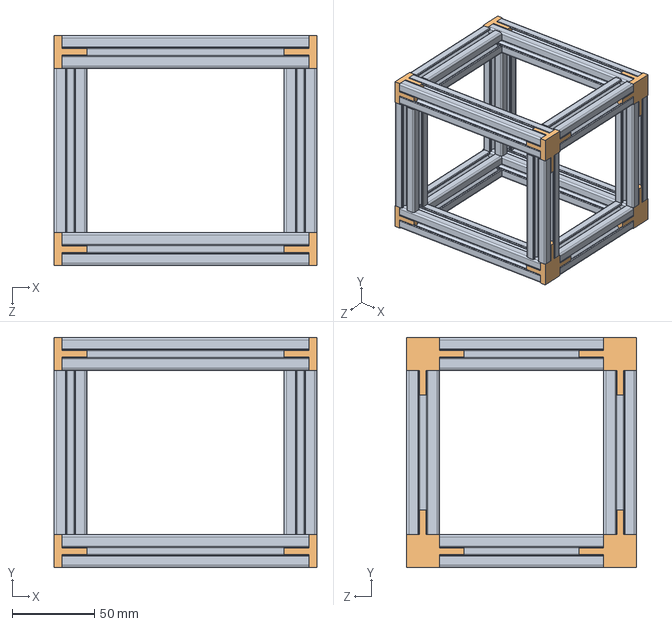
[picture p53: CAD file, 2022-08-11]
Manips/Torque Manip/Support Cube.SLDASM
160.0 x 140.0 x 140.0 mm
5537T501_T-Slotted Framing x 12
Tslot Corner x 8
