jamestorrissonwong/NML-CAD/Monkey Cage Blocker/to cut.SLDASM

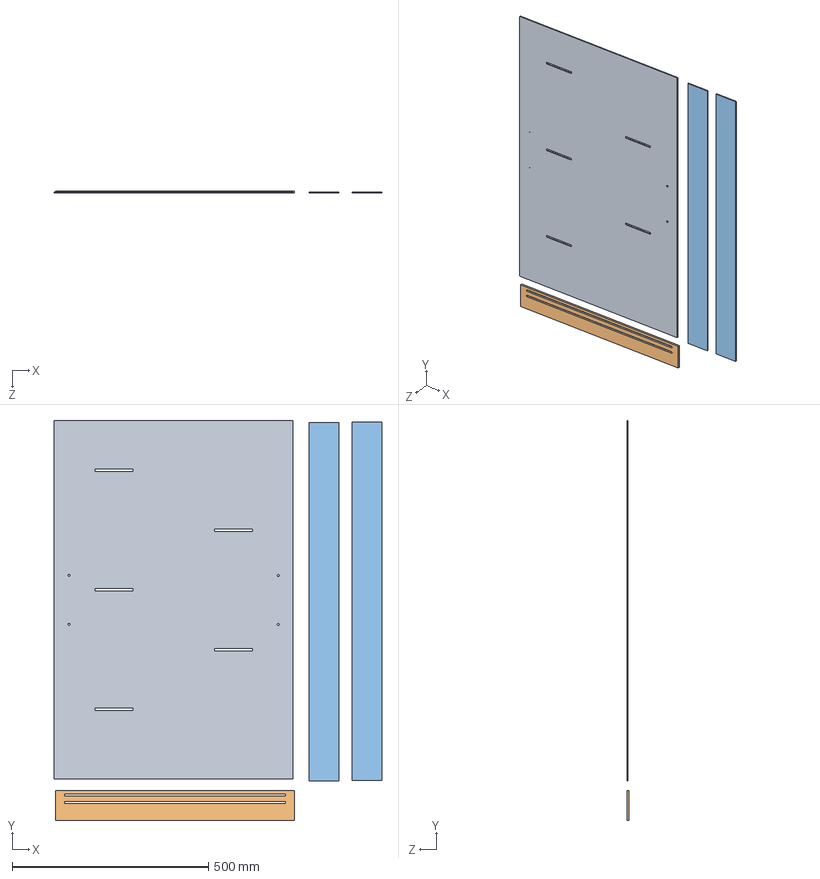
[picture p54: CAD file, 2021-12-15]
Monkey Cage Blocker/to cut.SLDASM
835.9 x 1019.7 x 6.35 mm
Rear Panel
Top Panel
Side Panel x 2
