jamestorrissonwong/NML-CAD/Monkey Chair/Arm Restraints/Triangle Multipart Assembly.SLDASM

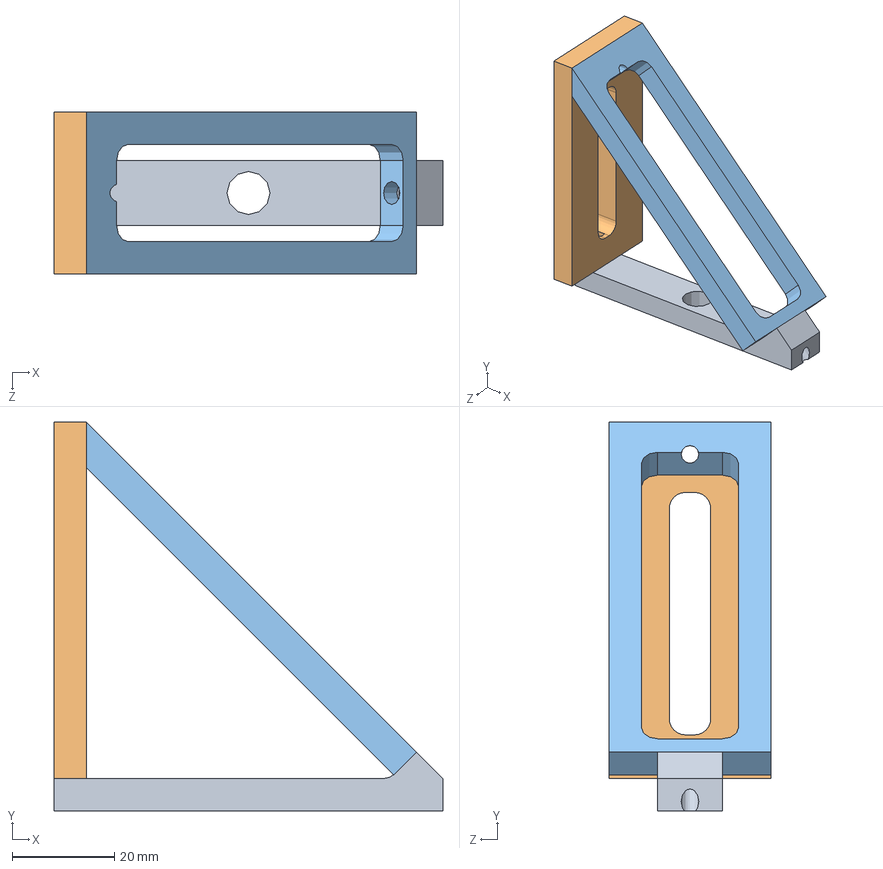
[picture p55: CAD file, 2022-08-11]
Monkey Chair/Arm Restraints/Triangle Multipart Assembly.SLDASM
76.2 x 76.2 x 31.8 mm
Triangle Horizontal
Triangle Vertical
Triangle Angled
