jamestorrissonwong/NML-CAD/Monkey Sippers/Monkey Sipper/Hex Rails/Hex Assem.SLDASM

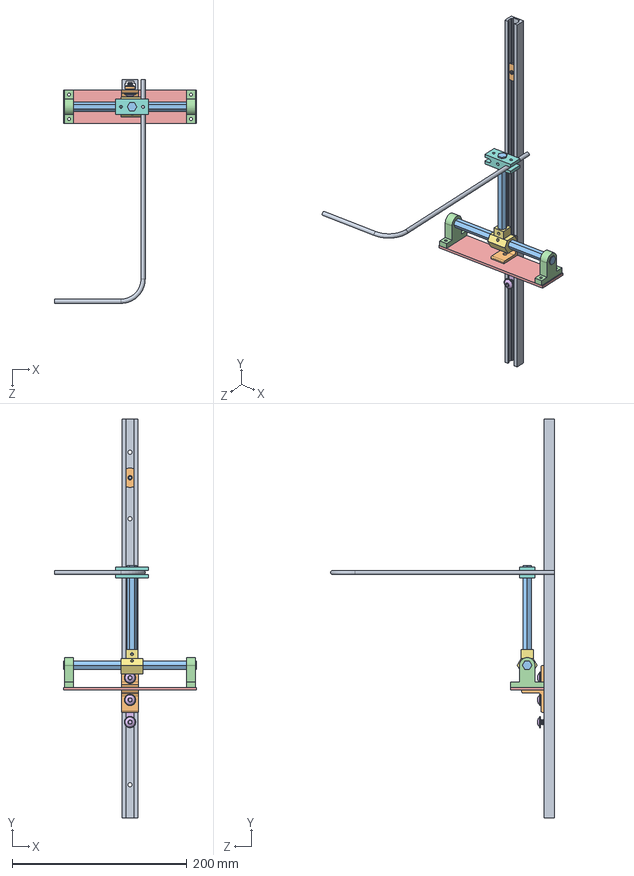
[picture p56: CAD file, 2021-07-24]
Monkey Sippers/Monkey Sipper/Hex Rails/Hex Assem.SLDASM
162.8 x 457.2 x 256.5 mm
1850A110_T-SLOTTED TRACK
1850A27_Fixturing Track
6512K162_LOW-CARBON STEEL HEX BAR x 2
Hex End x 2
85345K723_FLAME-RETARDANT GAROLITE G-10FR4 SHEET
47065T991_T-SLOTTED FRAMING
Hex Rail Adapter
Vertical Rail Adapter
straw
8982K401_MULTIPURPOSE 6061 ALUMINUM 90 DEGREE ANGLE x 2
