jamestorrissonwong/NML-CAD/Monkey Sippers/Sipper Fixturing Track/Sipper Assem.SLDASM

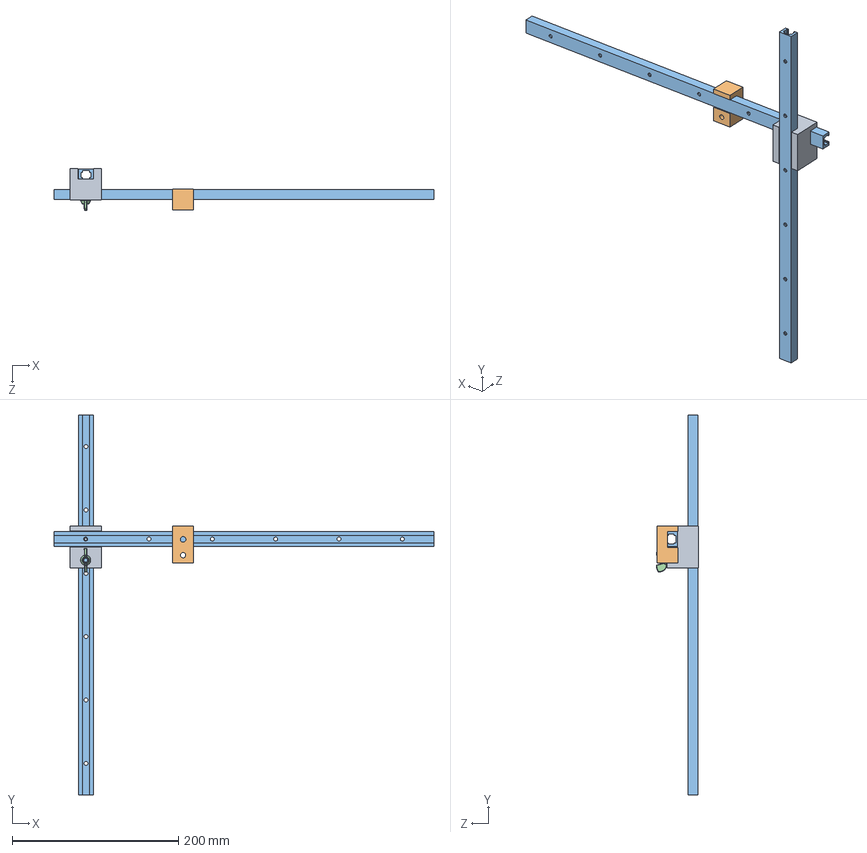
[picture p57: CAD file, 2021-12-15]
Monkey Sippers/Sipper Fixturing Track/Sipper Assem.SLDASM
457.2 x 457.2 x 50.8 mm
Block 1
Block 2
1850A11_18 Long T-Track Fixturing Track x 2
90866A029_ZINC-PLATED STEEL AND IRON WING NUTS
