jamestorrissonwong/NML-CAD/PCBs/Intan Headstage/RHD2000_128ch_headstage.SLDASM

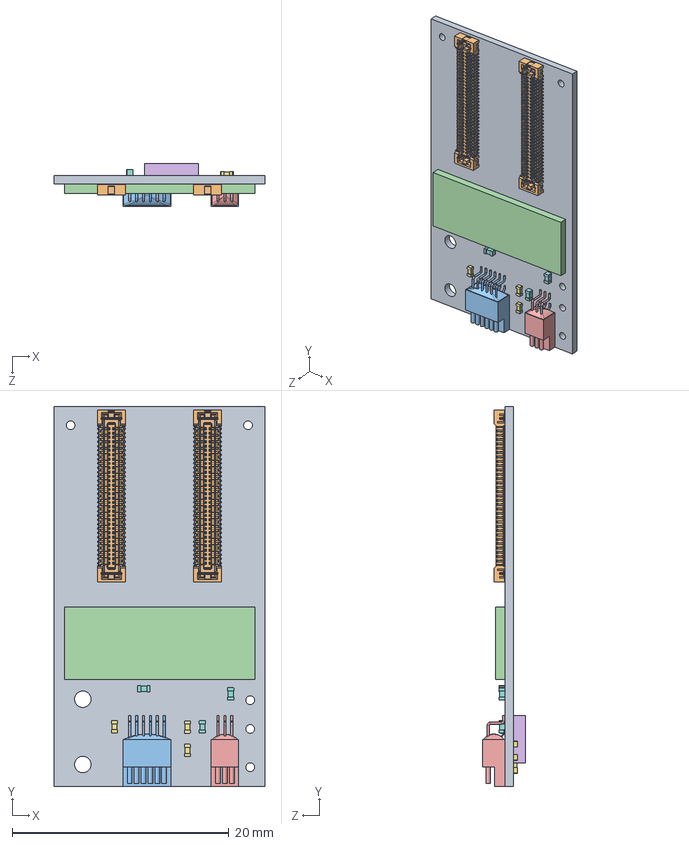
[picture p58: CAD file, 2021-07-24]
PCBs/Intan Headstage/RHD2000_128ch_headstage.SLDASM
19.4 x 35.0 x 3.92 mm
rhd2000_128_headstage
Molex-502426-6410 x 2
A79623-001
RHD2164_2x_epoxy_coated
A79608-001
TSSOP16
0402r_1430758 x 7
0402c_2320560 x 4
