jamestorrissonwong/NML-CAD/Ernesto/Wrist Force Transducer/WFT Assem.SLDASM

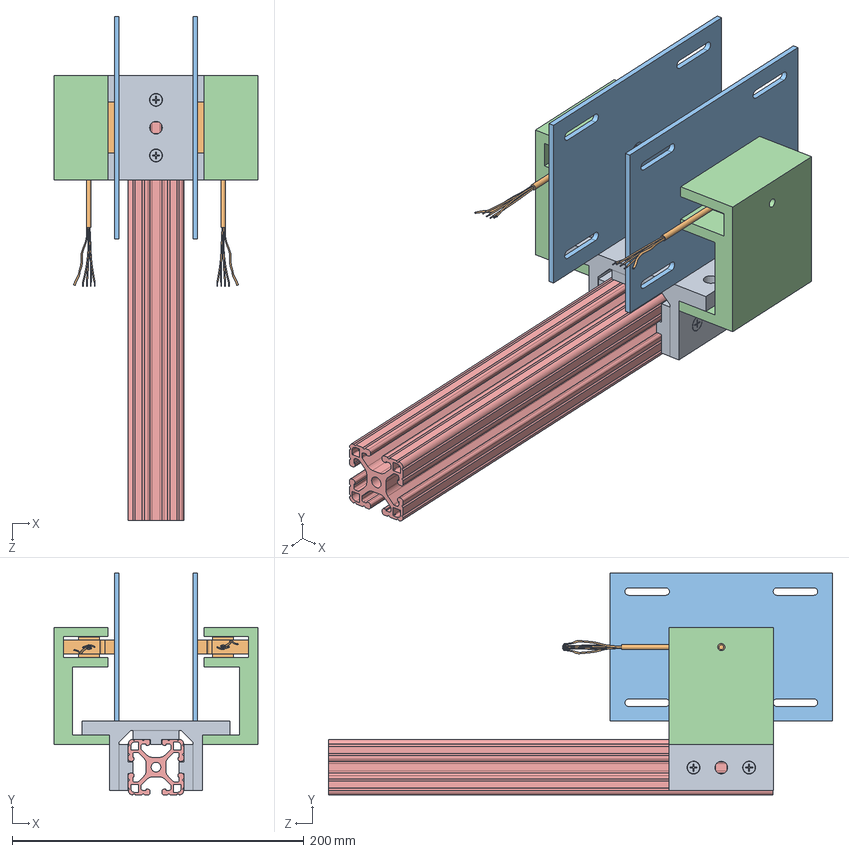
[picture p59: CAD file, 2021-07-24]
Ernesto/Wrist Force Transducer/WFT Assem.SLDASM
139.7 x 152.1 x 345.4 mm
47065T962_T-SLOTTED FRAMING
SMA-15-200lbf.step x 2
Plate x 2
FT Holder x 2
47065T601_T-SLOTTED FRAMING
