jamestorrissonwong/NML-CAD/Monkey Cage Training/Monkey Cage Extension/sigh.SLDASM

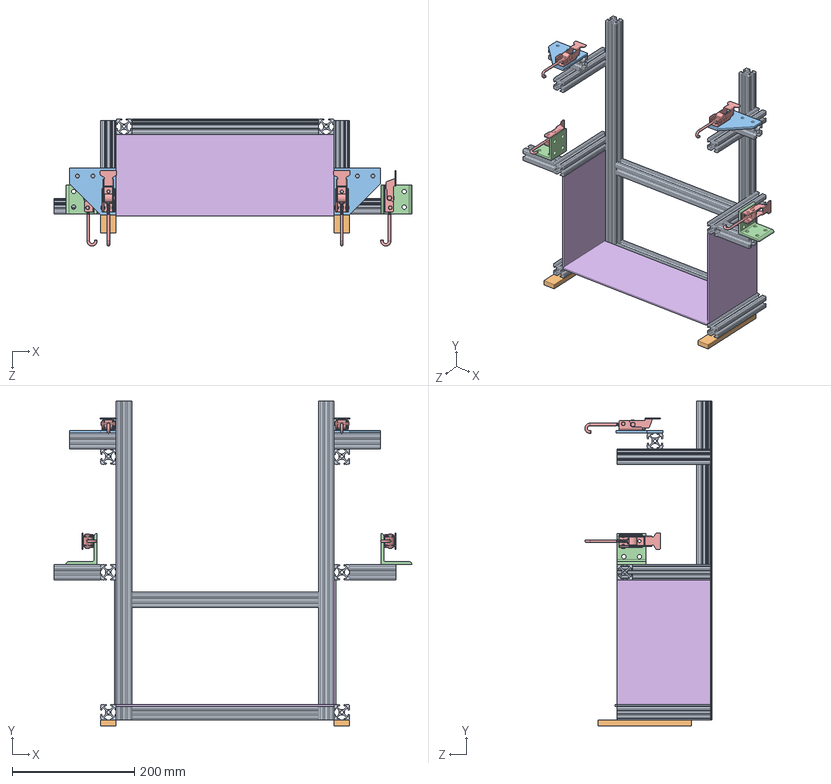
[picture p60: CAD file, 2021-08-06]
Monkey Cage Training/Monkey Cage Extension/sigh.SLDASM
584.5 x 530.2 x 207.9 mm
47065T209_ALUMINUM T-SLOTTED FRAMING EXTRUSION x 14
8975K878_MULTIPURPOSE 6061 ALUMINUM x 2
47065T267_ALUMINUM T-SLOTTED FRAMING EXTRUSION x 2
47065T253_ALUMINUM T-SLOTTED FRAMING EXTRUSION x 2
11605A220_ADJUSTABLE-GRIP DRAW LATCH x 4
acrylic round 2 x 3
