jamestorrissonwong/NML-CAD/Manips/Monkey Manip Stepper Mod/Manip Stepper Assem.SLDASM

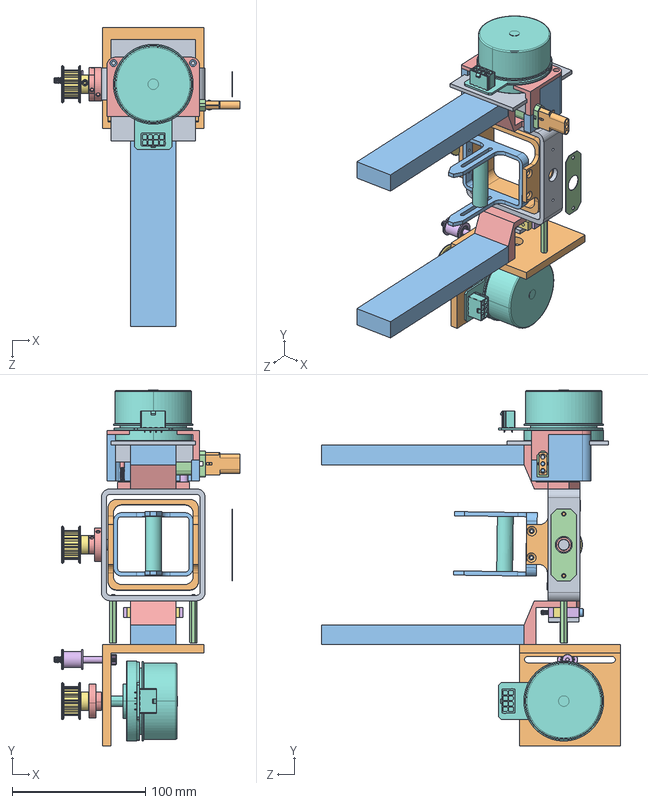
[picture p61: CAD file, 2021-07-24]
Manips/Monkey Manip Stepper Mod/Manip Stepper Assem.SLDASM
139.8 x 267.6 x 224.9 mm
Large Square
Mid Square
Small Square
Large Square Mount x 2
Handle
Shaft x 2
45 Stop Mid v3
45 Stop Arm v3 x 2
9657K329_COMPRESSION SPRING x 2
Guard Plate
91253A145_ALLOY STEEL FLAT-HEAD SOCKET CAP SCREW x 2
95630A241_PTFE FLAT WASHER x 4
3693N160_ HIGH-STRENGTH HTD TIMING BELT IDLER PULLEY
1277N714_CORROSION-RESISTANT TIMING BELT PULLEY x 2
EC60fl-100W-V1 x 2
X mount
Y mount
Outer Bar x 2
91075A237_Male-Female Threaded Hex Standoff x 2
pololu-universal-aluminum-mounting-hub-for-8mm-shaft-m3-holes x 2
91273A916_Same-Size Thread 18-8 Stainless Steel Shoulder Screw
