jamestorrissonwong/NML-CAD/Monkey Chair/Arm Restraints/Arm Restraint Assembly.SLDASM

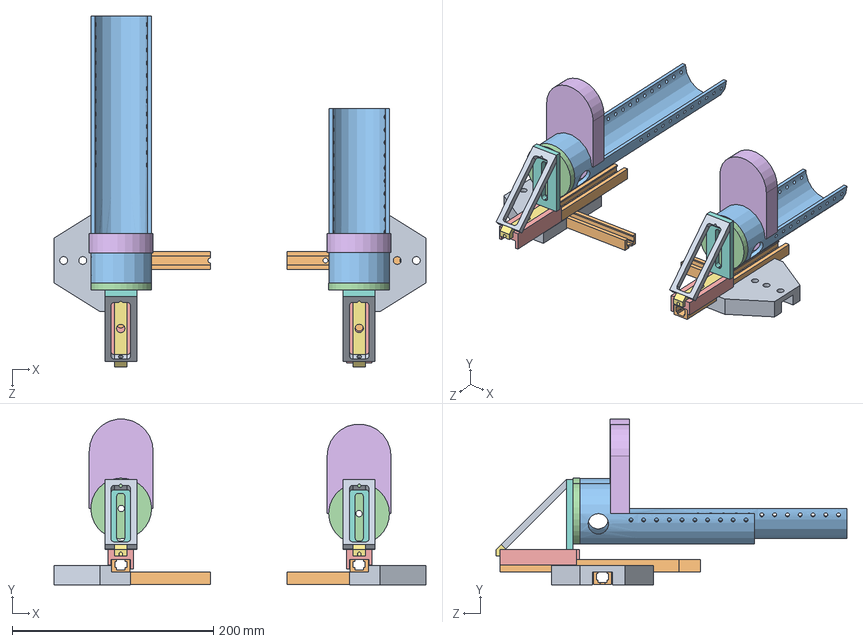
[picture p62: CAD file, 2022-08-11]
Monkey Chair/Arm Restraints/Arm Restraint Assembly.SLDASM
369.4 x 164.4 x 348.3 mm
T Slot Adapter x 2
1850A11_18 Long T-Track Fixturing Track x 4
Arm Pipe x 2
Arm Pipe Cap x 2
Extra Rail x 2
Rear Arm Restraint Plate x 2
Triangle Horizontal x 2
Triangle Vertical x 2
Triangle Angled x 2
