jamestorrissonwong/NML-CAD/Monkey Chair/Basic Chair.SLDASM

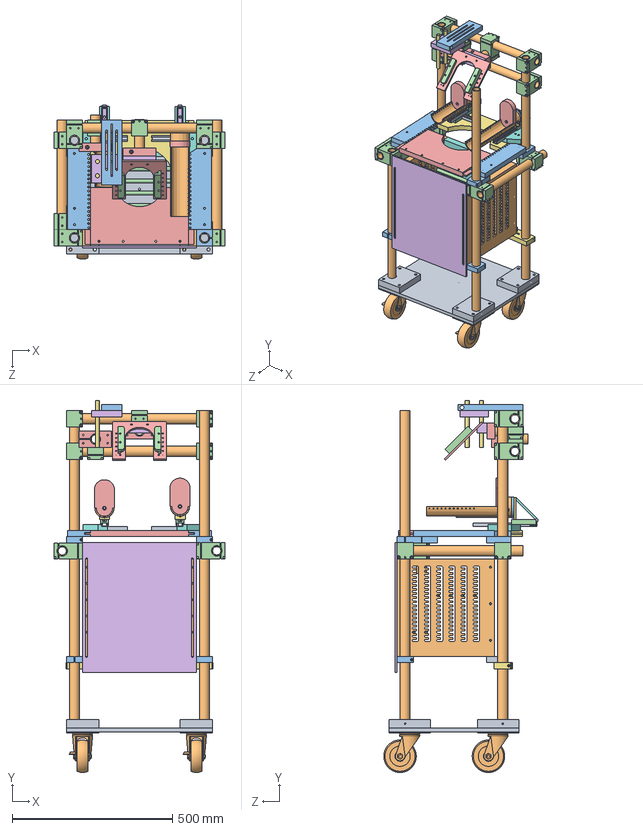
[picture p63: CAD file, 2022-08-11]
Monkey Chair/Basic Chair.SLDASM
533.4 x 1162.0 x 482.4 mm
Base Plate
Tube x 11
Hole Plate x 2
Neck Clamp x 2
Neck Plate
Neck Plate Adapter
Rod x 2
Seat Rear
Seat Rest
Seat Side x 2
Slot Plate
Tube Coupler A x 11
Tube Coupler B x 2
Slot Plate Adapter
Rear Plate
T Slot Adapter x 2
1850A11_18 Long T-Track Fixturing Track x 4
Arm Pipe x 2
Arm Pipe Cap x 2
Extra Rail x 2
Rear Arm Restraint Plate x 2
Triangle Horizontal x 2
Triangle Vertical x 2
Triangle Angled x 2
Base Coupler x 4
2407T42_Cart-Smart Caster x 4
Sliding Block x 6
8974K261_Multipurpose 6061 Aluminum x 6
Kick Blocker Top Plate
Slotted Kick Plate
Slotted Sliding Block x 2
