jamestorrissonwong/NML-CAD/Monkey Sippers/Monkey Sipper/Slots/Simplest Assem.SLDASM

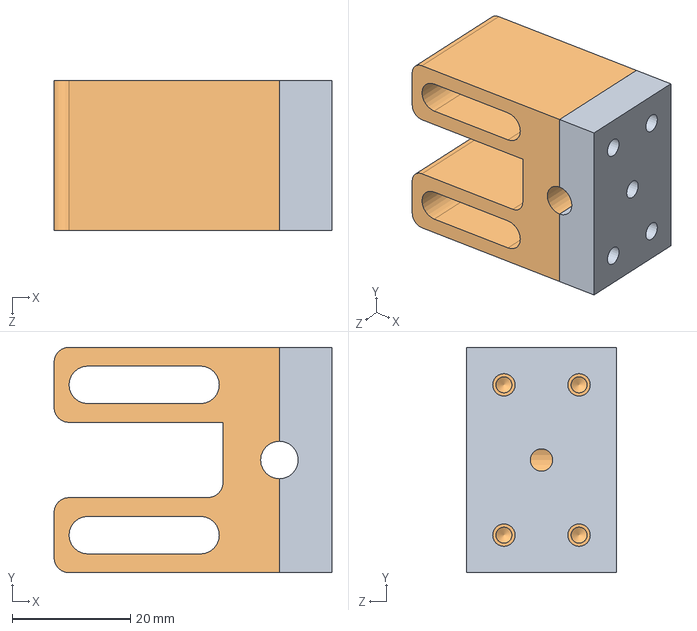
[picture p64: CAD file, 2021-07-24]
Monkey Sippers/Monkey Sipper/Slots/Simplest Assem.SLDASM
47.0 x 38.1 x 25.4 mm
Securing Plate
simplest
