jamestorrissonwong/NML-CAD/Monkey Cage Training/Acrylic ICTS/Thicker/3-8 version.SLDASM

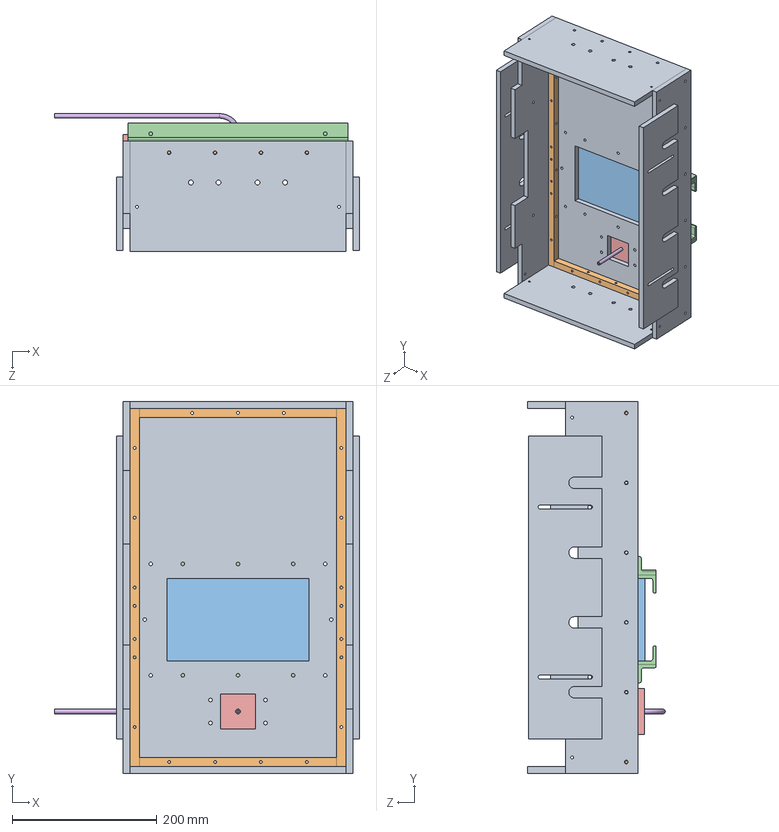
[picture p66: CAD file, 2022-06-04]
Monkey Cage Training/Acrylic ICTS/Thicker/3-8 version.SLDASM
422.3 x 514.3 x 190.5 mm
Acrylic x 7
Delrin x 4
Screen
8982K151_Multipurpose 6061 Aluminum 90 Degree Angle x 4
sipper cover
straw
