jamestorrissonwong/NML-CAD/Monkey Cage Training/Acrylic ICTS/DXFs for Cutting/Full Panel.SLDASM

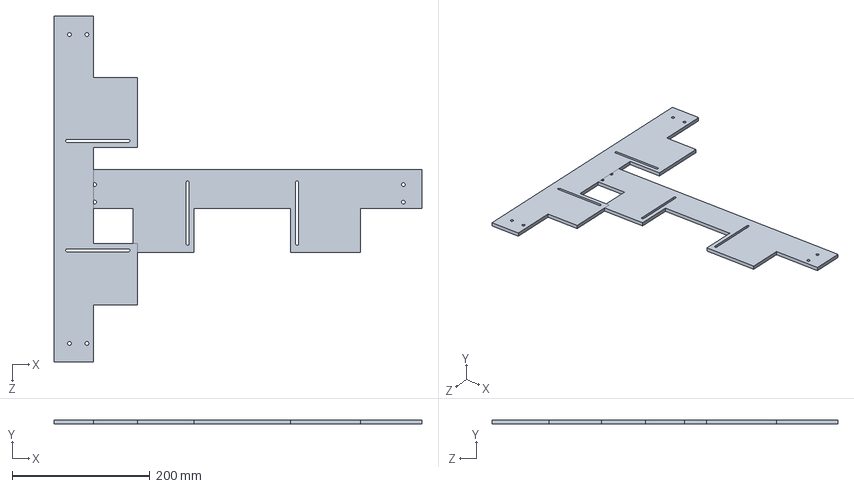
[picture p67: CAD file, 2021-12-15]
Monkey Cage Training/Acrylic ICTS/DXFs for Cutting/Full Panel.SLDASM
533.4 x 6.35 x 501.6 mm
Acrylic x 2
