jamestorrissonwong/NML-CAD/Monkey Cage Training/Monkey Cage Extension/keep tyring buddy.SLDASM

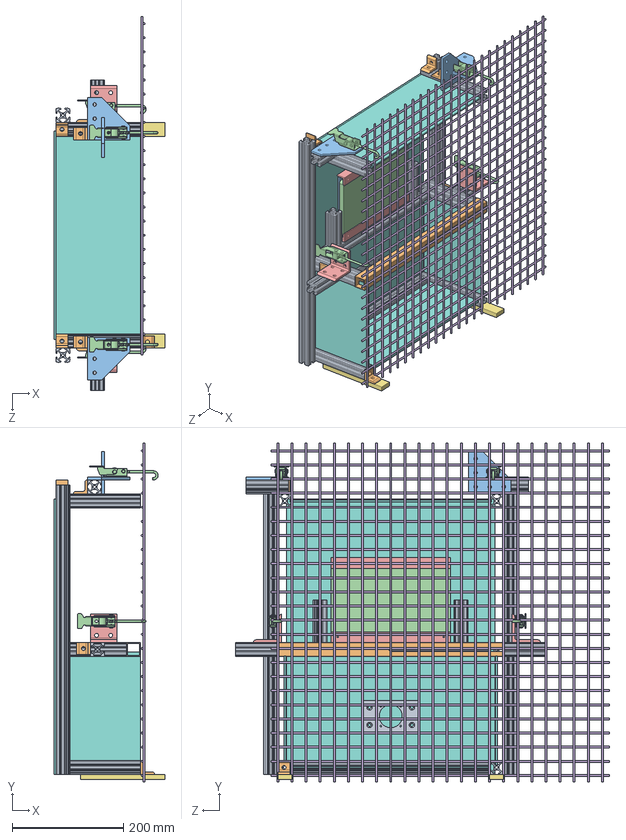
[picture p68: CAD file, 2021-08-06]
Monkey Cage Training/Monkey Cage Extension/keep tyring buddy.SLDASM
199.5 x 609.6 x 673.1 mm
47065T209_ALUMINUM T-SLOTTED FRAMING EXTRUSION x 16
11605A220_ADJUSTABLE-GRIP DRAW LATCH x 4
47065T253_ALUMINUM T-SLOTTED FRAMING EXTRUSION x 2
47065T267_ALUMINUM T-SLOTTED FRAMING EXTRUSION x 2
8975K878_MULTIPURPOSE 6061 ALUMINUM x 2
acrylic round 2 x 5
Joystick Mount
47065T236_ALUMINUM T-SLOTTED FRAMING EXTRUSION x 6
Back
Screen
8982K281_Multipurpose 6061 Aluminum 90 Degree Angle x 2
