jamestorrissonwong/NML-CAD/Monkey Collars/Fixture Setup.SLDASM

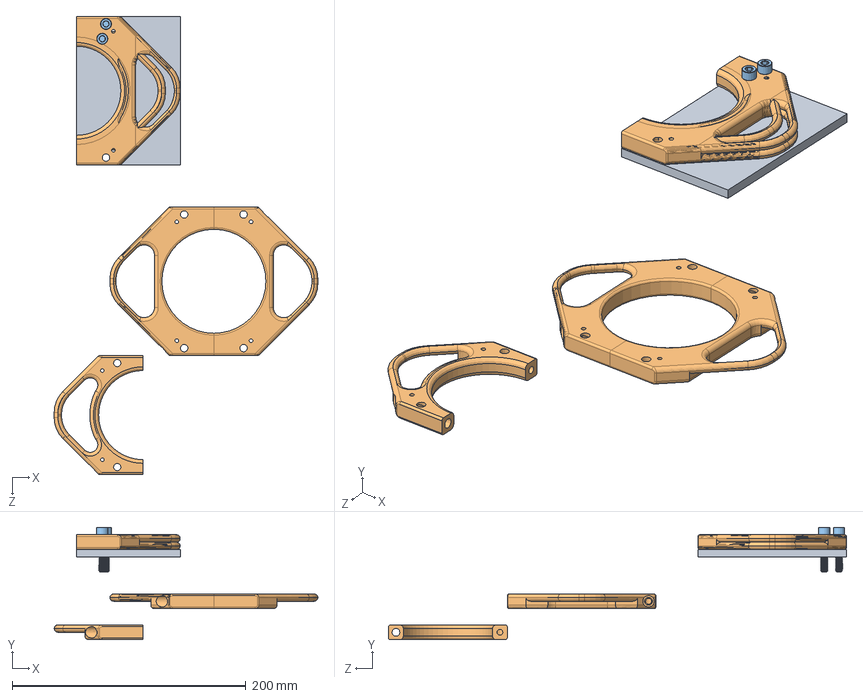
[picture p69: CAD file, 2022-08-11]
Monkey Collars/Fixture Setup.SLDASM
225.5 x 96.2 x 391.6 mm
Fixture Plate
Collar x 8
91274A176_Zinc-Aluminum-Coated Alloy Steel Socket Head Screw x 2
