jamestorrissonwong/NML-CAD/Ernesto/Wrist Suspension/WSA v3.SLDASM

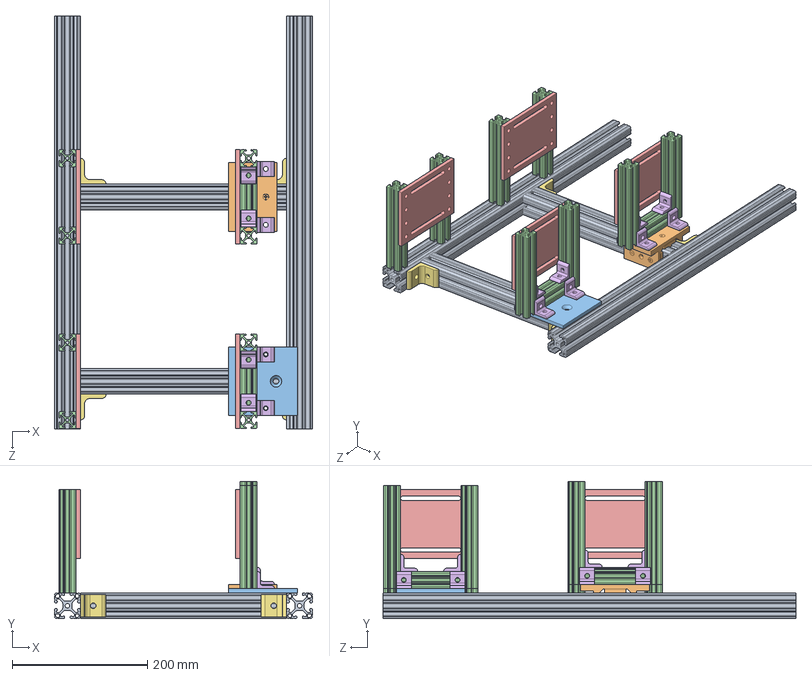
[picture p70: CAD file, 2021-07-24]
Ernesto/Wrist Suspension/WSA v3.SLDASM
381.0 x 202.9 x 609.6 mm
47065T144_T-Slotted Framing x 4
47065T962_T-Slotted Framing
47065T652_T-SLOTTED FRAMING
47065T209_ALUMINUM T-SLOTTED FRAMING EXTRUSION x 10
Polycarb x 4
47065T236_ALUMINUM T-SLOTTED FRAMING EXTRUSION x 8
47065T845_ALUMINUM T-SLOTTED FRAMING EXTRUSION x 4
