jamestorrissonwong/NML-CAD/Monkey Cage Training/Monkey Cage Extension/Reduced Weight.SLDASM

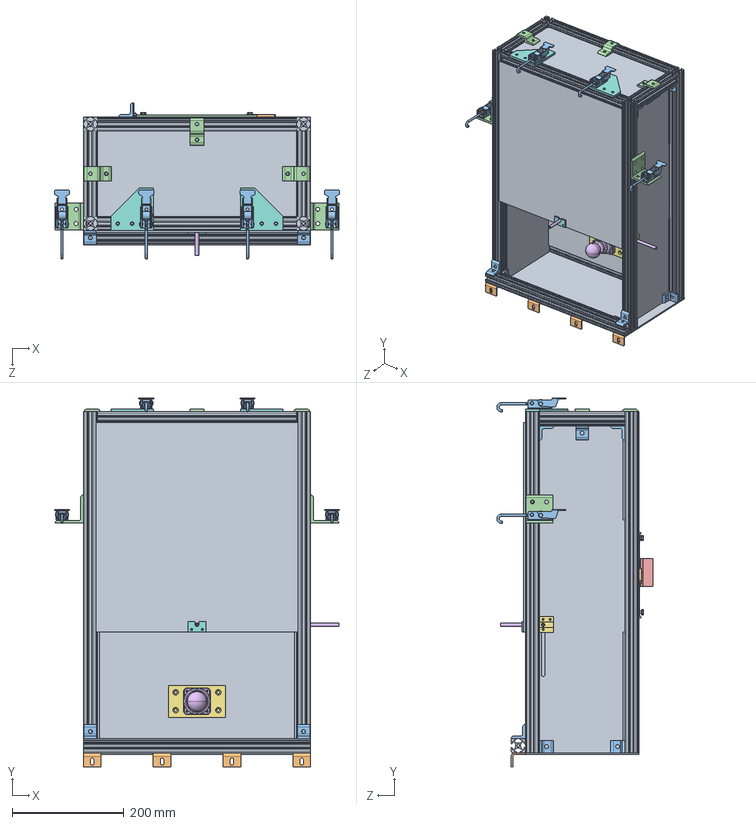
[picture p71: CAD file, 2021-07-27]
Monkey Cage Training/Monkey Cage Extension/Reduced Weight.SLDASM
509.6 x 659.6 x 279.6 mm
47065T209_ALUMINUM T-SLOTTED FRAMING EXTRUSION x 14
2313N48_CORNER MACHINE BRACKET x 4
11605A220_ADJUSTABLE-GRIP DRAW LATCH x 4
47065T253_ALUMINUM T-SLOTTED FRAMING EXTRUSION x 2
47065T905_T-SLOTTED FRAMING x 8
HE2-23-x-A
Joystick Mount
47065T267_ALUMINUM T-SLOTTED FRAMING EXTRUSION x 2
Polycarb x 9
Screen
Back
8982K281_Multipurpose 6061 Aluminum 90 Degree Angle x 2
1151A62_SURFACE-MOUNT LIFT-OFF HINGES WITH HOLES x 2
straw
Straw Mount A
Straw Mount B
92952A220_THUMB-GRIP 18-8 SS PRECISION SHOULDER SCREW x 4
47065T255_ALUMINUM T-SLOTTED FRAMING EXTRUSION
47065T236_ALUMINUM T-SLOTTED FRAMING EXTRUSION x 37
47065T195_ALUMINUM T-SLOTTED FRAMING EXTRUSION x 3
Straw Box x 4
