jamestorrissonwong/NML-CAD/Monkey Cage Blocker/Blocker Ladder.SLDASM

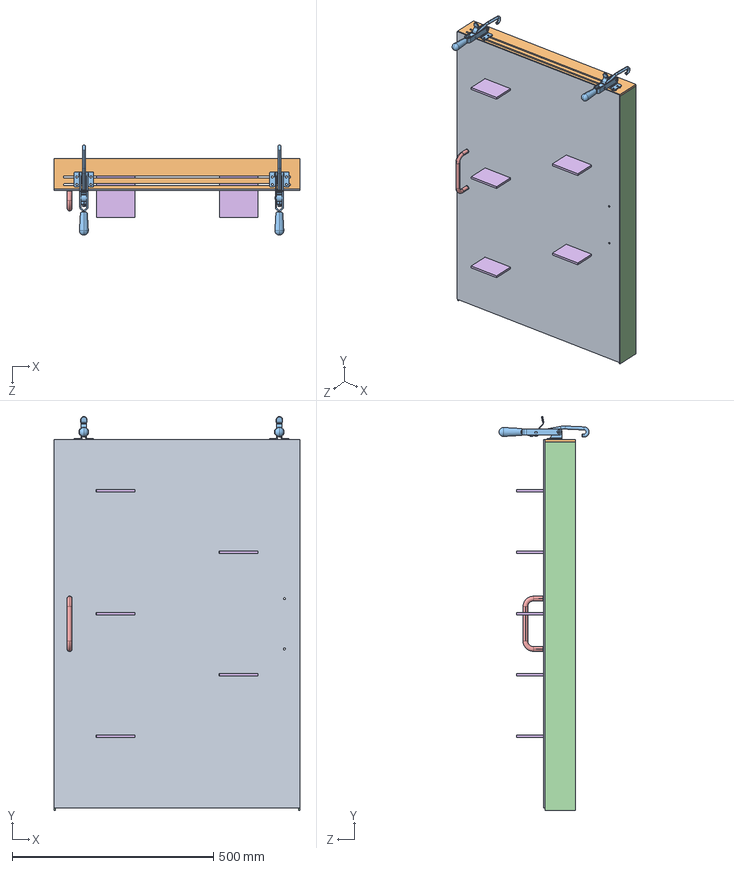
[picture p72: CAD file, 2021-12-15]
Monkey Cage Blocker/Blocker Ladder.SLDASM
609.6 x 978.2 x 223.9 mm
Rear Panel
Top Panel
5136A13_Latch-Style Toggle Clamp x 2
Side Panel x 2
Step x 5
15275A51_Corner Bracket x 5
