jamestorrissonwong/NML-CAD/Monkey Cage Training/Acrylic ICTS/ICTSv2.SLDASM

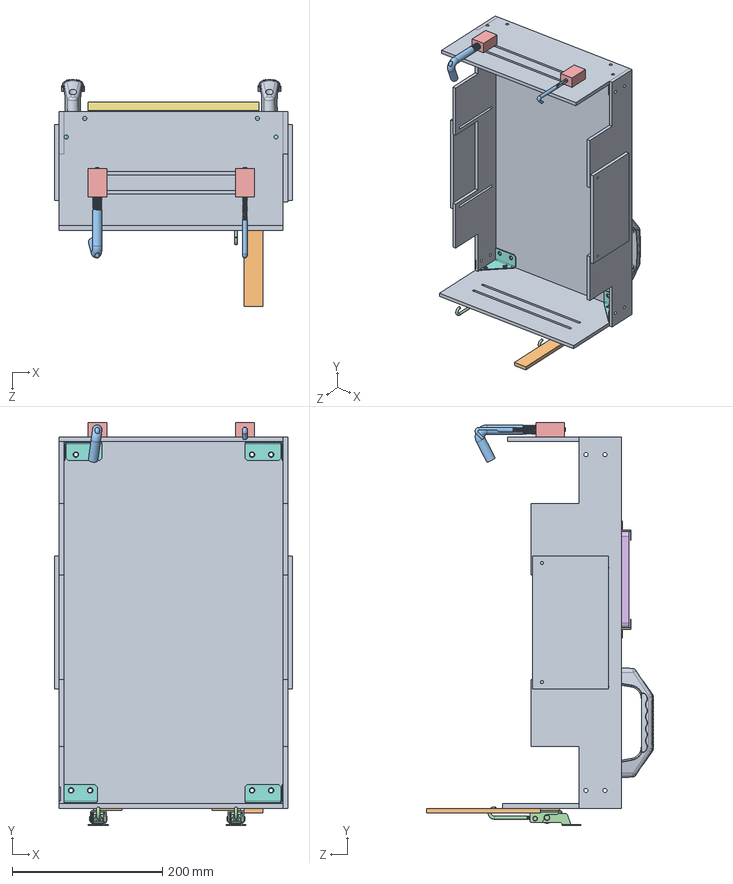
[picture p73: CAD file, 2021-12-15]
Monkey Cage Training/Acrylic ICTS/ICTSv2.SLDASM
317.5 x 537.3 x 303.0 mm
Acrylic x 7
11605A220_ADJUSTABLE-GRIP DRAW LATCH x 2
anchor block x 2
Screen
4630T178_Anodized Architectural 6063 Aluminum 90 Degree Angle x 4
1088A41_INSIDE-CORNER REINFORCING BRACKET x 4
1950A65_Unthreaded-Hole Pull Handle x 2
Bottom Slider Plate x 2
98760A120_Low-Strength Zinc-Plated Steel Hold-Down Bolt x 2
