jamestorrissonwong/NML-CAD/Jordyn/prototype_assem.SLDASM

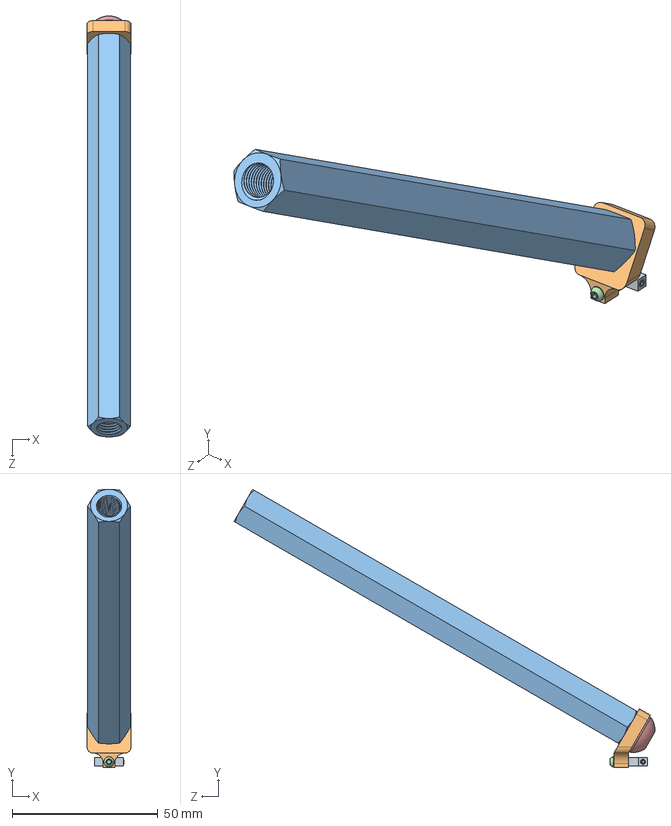
[picture p74: CAD file, 2021-07-24]
Jordyn/prototype_assem.SLDASM
15.0 x 95.4 x 144.2 mm
prototype
3dprint
8419K62_TURNBUCKLE-STYLE CONNECTING ROD
92095A452_Button Head Hex Drive Screw
92949A599_18-8 SS BUTTON HEAD HEX DRIVE SCREW
93285A009_CONFORMABLE SOFT NYLON-TIP SET SCREW x 2
