jamestorrissonwong/NML-CAD/Ernesto/Forearm Platform/Custom Assem.SLDASM

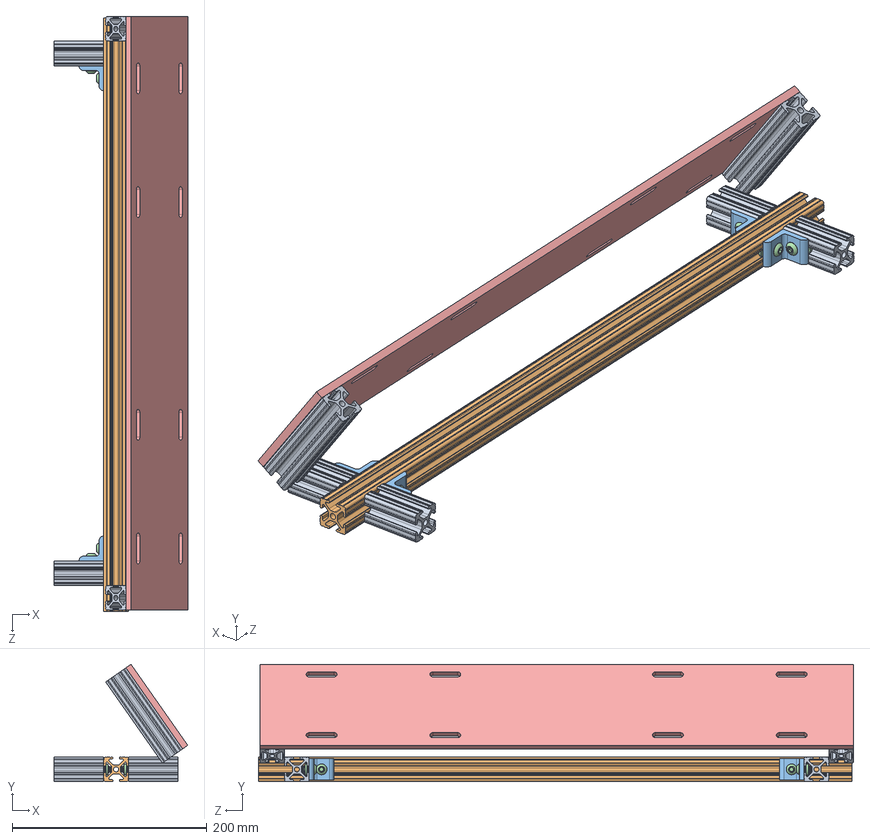
[picture p76: CAD file, 2021-07-24]
Ernesto/Forearm Platform/Custom Assem.SLDASM
137.1 x 120.6 x 610.9 mm
47065T411_ALUMINUM T-SLOTTED FRAMING EXTRUSION x 6
47065T209_ALUMINUM T-SLOTTED FRAMING EXTRUSION
47065T236_ALUMINUM T-SLOTTED FRAMING EXTRUSION x 4
47065T139_ALUMINUM T-SLOTTED FRAMING EXTRUSION x 8
Polycarb plate
