jamestorrissonwong/NML-CAD/Ernesto/Wrist Suspension/Wrist Suspension Assm.SLDASM

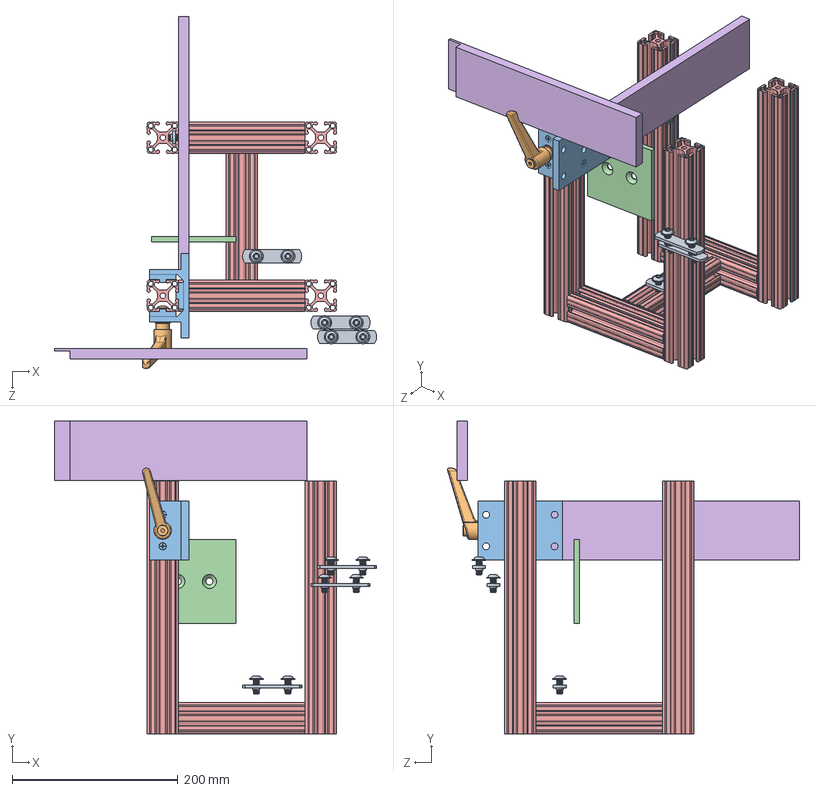
[picture p77: CAD file, 2021-07-24]
Ernesto/Wrist Suspension/Wrist Suspension Assm.SLDASM
388.7 x 377.3 x 424.3 mm
60585K320_LINEAR BEARING FOR T-SLOTTED FRAMING
47065T962_T-Slotted Framing
47065T144_T-Slotted Framing x 7
Strap Plate x 2
47065T149_T-Slotted Framing x 3
