jamestorrissonwong/NML-CAD/Monkey Sippers/Monkey Sipper/Slots/Slot Assem.SLDASM

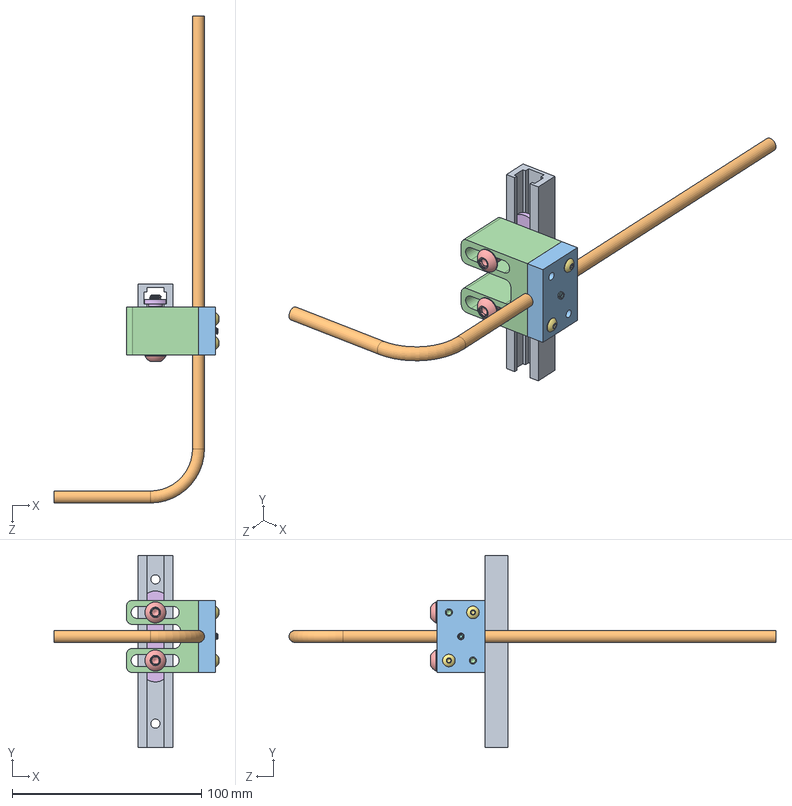
[picture p78: CAD file, 2021-07-24]
Monkey Sippers/Monkey Sipper/Slots/Slot Assem.SLDASM
86.9 x 101.6 x 257.2 mm
1850A110_T-SLOTTED TRACK
straw
Securing Plate
simplest
92949A544_18-8 SS BUTTON HEAD HEX DRIVE SCREW x 2
3136N274_T-SLOTTED FRAMING
92949A150_18-8 Stainless Steel Button Head Hex Drive Screw x 2
91375A752_ALLOY STEEL CUP-POINT SET SCREW
