jamestorrissonwong/NML-CAD/Monkey Chair/Arm Restraints/Arm Fixture Assm.SLDASM

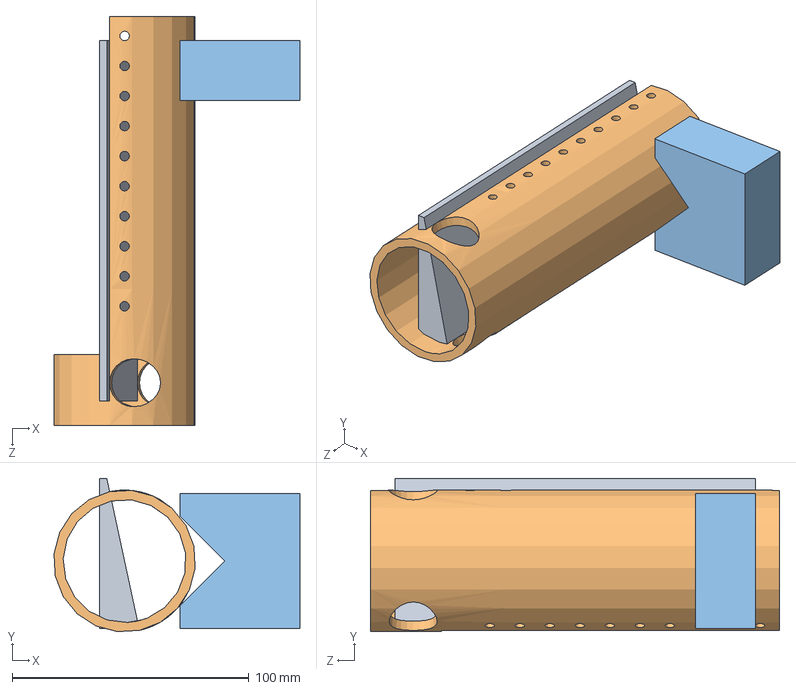
[picture p79: CAD file, 2022-08-11]
Monkey Chair/Arm Restraints/Arm Fixture Assm.SLDASM
104.0 x 64.8 x 173.0 mm
Arm Fixture
Arm Pipe
V Block
