jamestorrissonwong/NML-CAD/Jordyn/prototype assem v3.SLDASM

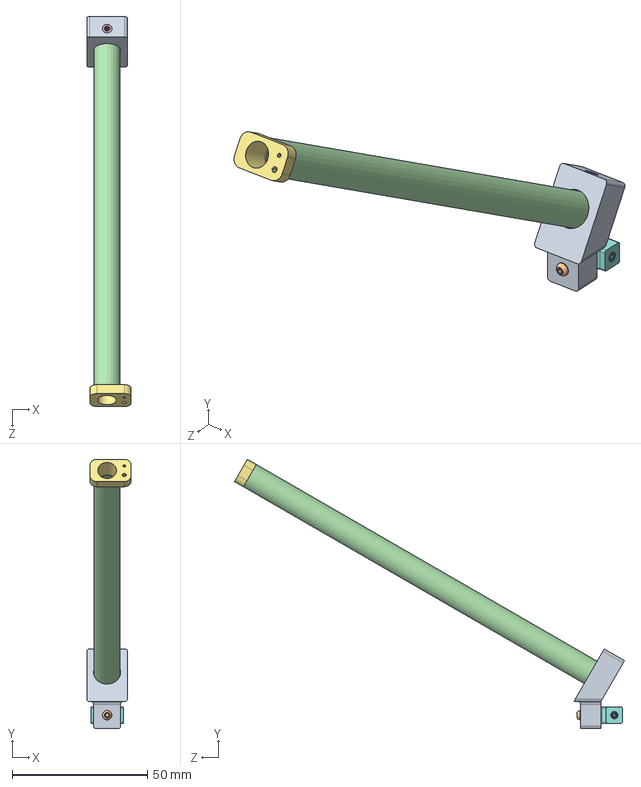
[picture p81: CAD file, 2021-07-24]
Jordyn/prototype assem v3.SLDASM
16.4 x 99.6 x 144.1 mm
3dprint-v3
92095A452_Button Head Hex Drive Screw
93285A009_CONFORMABLE SOFT NYLON-TIP SET SCREW x 2
9056K635_MULTIPURPOSE 6061 ALUMINUM ROUND TUBE
94180A307_HEAT-SET INSERTS FOR PLASTICS x 4
92015A091_18-8 STAINLESS STEEL CUP-POINT SET SCREW
prototype top
prototype v4
