jamestorrissonwong/NML-CAD/Balanced Lines/IC_Analog Devices_AD8132ARZ/09bcc2b0ff091a85040480bc1b93cba23f409732.step

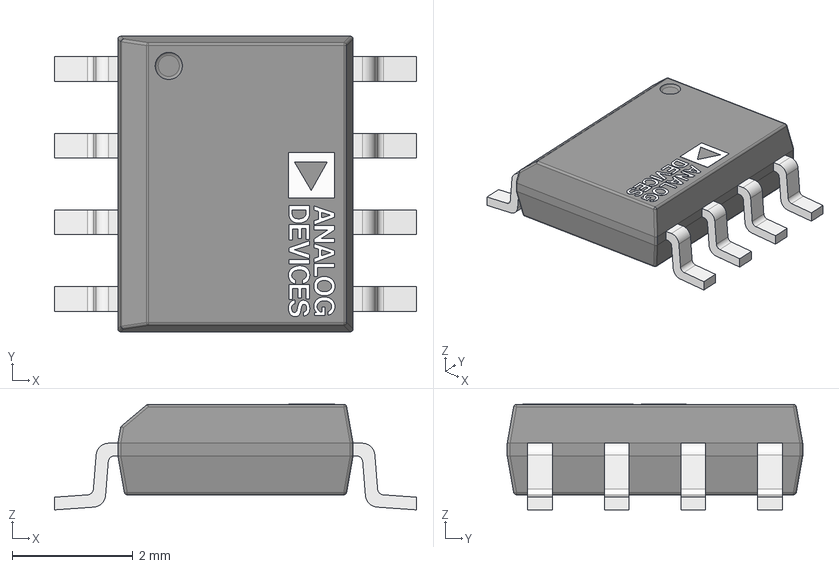
[picture p82: CAD file, 2022-08-11]
Balanced Lines/IC_Analog Devices_AD8132ARZ/09bcc2b0ff091a85040480bc1b93cba23f409732.step
6.00 x 4.90 x 1.75 mm
pins
part number
