jamestorrissonwong/NML-CAD/Bite Guard-1-1.SLDPRT

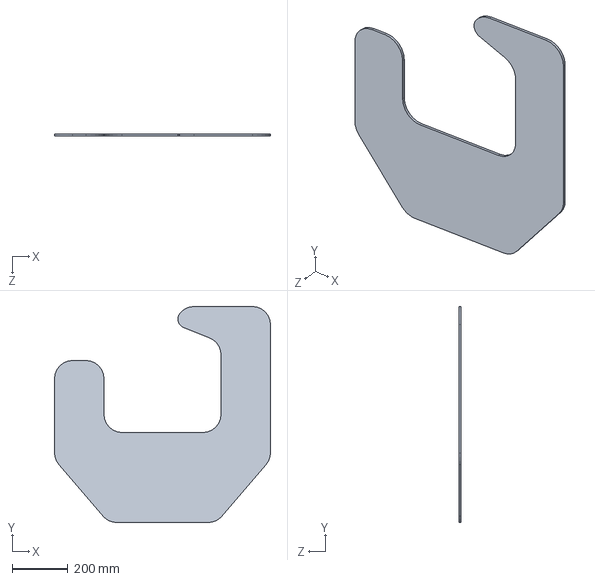
[picture p83: CAD file, 2022-02-23]
Bite Guard-1-1.SLDPRT
774.2 x 774.2 x 8.06 mm
