jamestorrissonwong/NML-CAD/Ernesto/Forearm Platform/Polycarb plate.SLDPRT

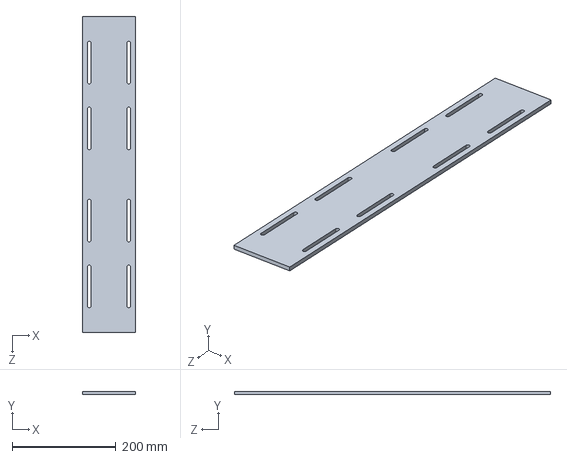
[picture p84: CAD file, 2021-08-02]
Ernesto/Forearm Platform/Polycarb plate.SLDPRT
101.6 x 6.35 x 609.6 mm
