jamestorrissonwong/NML-CAD/Ernesto/Wrist Force Transducer/SMA-15-200lbf/SMA-15-200lbf.step

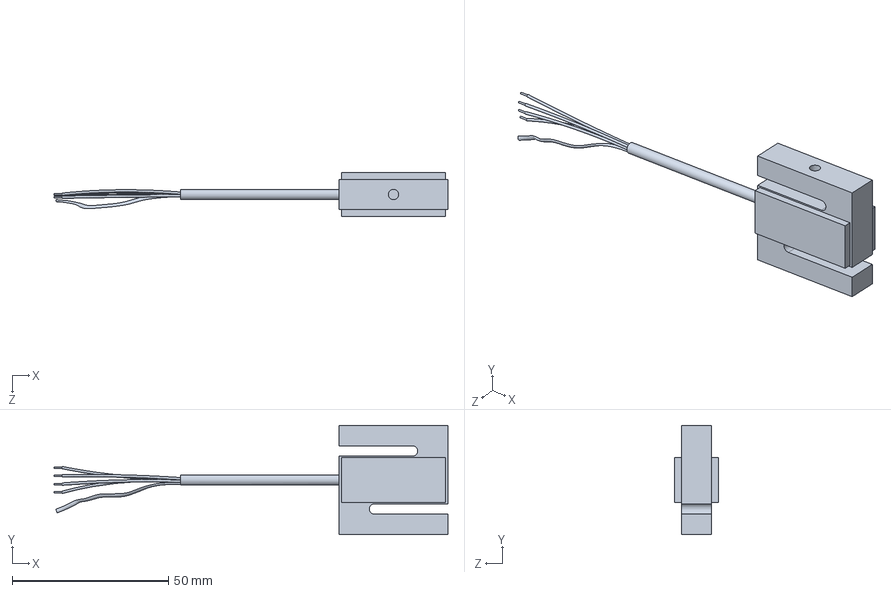
[picture p85: CAD file, 2021-07-24]
Ernesto/Wrist Force Transducer/SMA-15-200lbf/SMA-15-200lbf.step
126.2 x 34.9 x 14.1 mm
