jamestorrissonwong/NML-CAD/Jordyn/T piece wider holes.STL

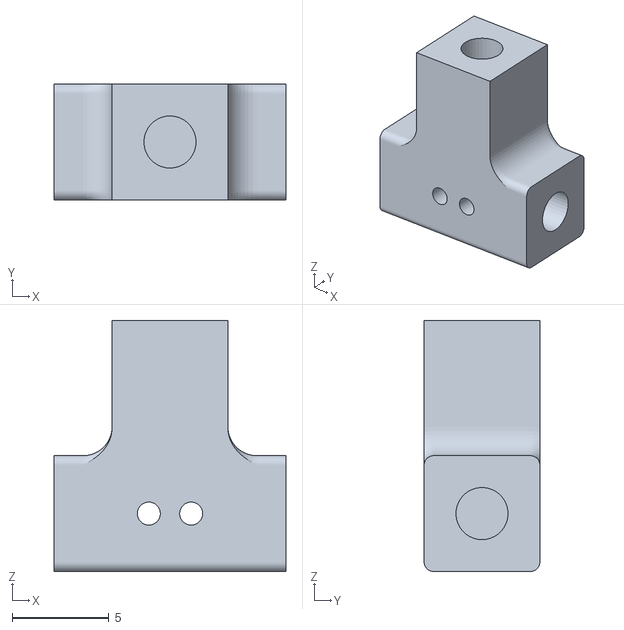
[picture p86: CAD file, 2021-12-15]
Jordyn/T piece wider holes.STL
12.0 x 6.00 x 13.0
