jamestorrissonwong/NML-CAD/Manips/Human Manip/Bar Stock/mm motor mount.SLDPRT

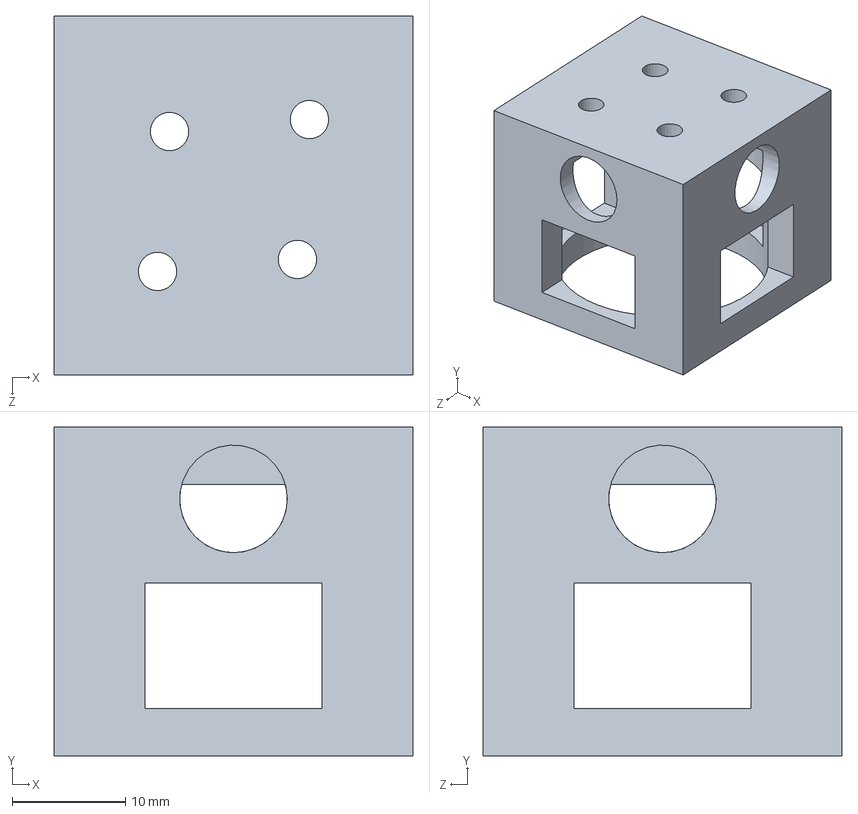
[picture p87: CAD file, 2022-02-23]
Manips/Human Manip/Bar Stock/mm motor mount.SLDPRT
31.8 x 29.1 x 31.8 mm
