jamestorrissonwong/NML-CAD/Manips/Human Manip/STLS/encoder adapter.STL

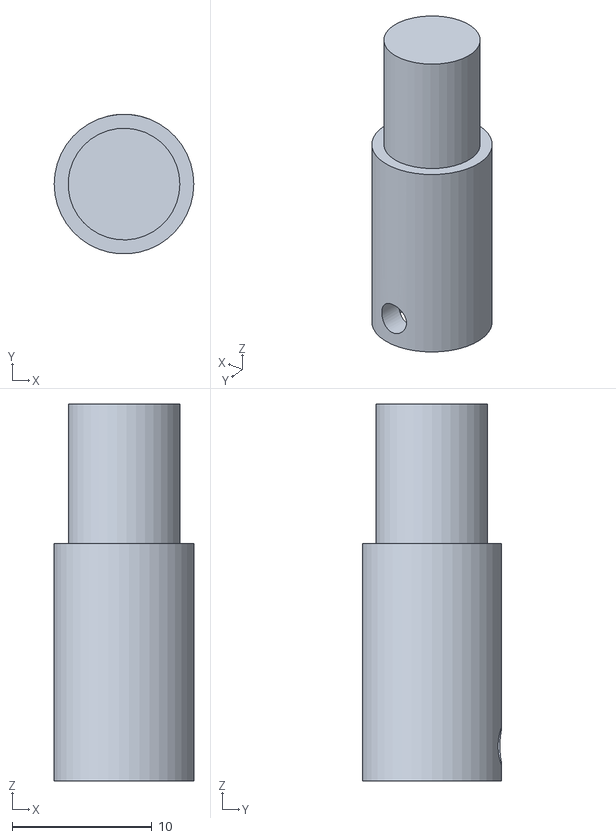
[picture p88: CAD file, 2022-02-23]
Manips/Human Manip/STLS/encoder adapter.STL
10.0 x 9.99 x 27.0
