jamestorrissonwong/NML-CAD/Manips/Human Manip/STLS/Prev STLs/Outer Vertical.STL

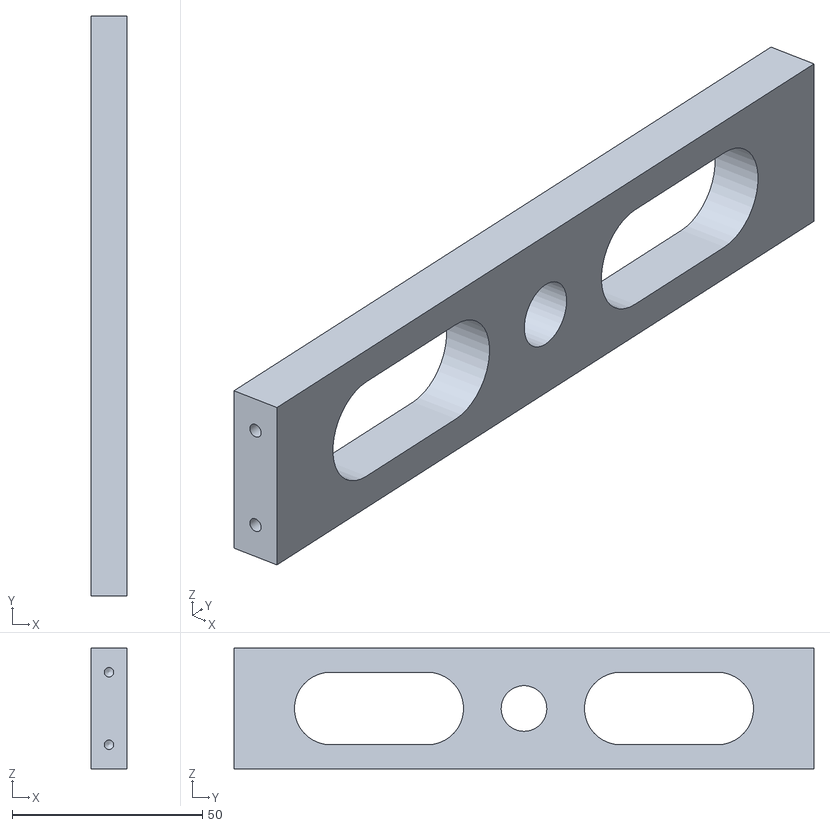
[picture p89: CAD file, 2021-12-19]
Manips/Human Manip/STLS/Prev STLs/Outer Vertical.STL
9.53 x 152.4 x 31.8
