jamestorrissonwong/NML-CAD/Manips/Monkey Manip Stepper Mod/37d-gearmotor-3d-models/pololu-2266-model.step.SLDPRT

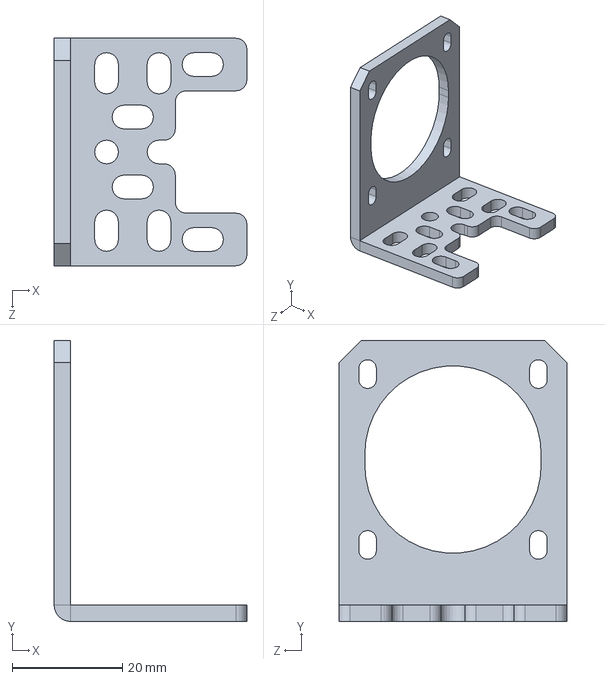
[picture p91: CAD file, 2021-07-24]
Manips/Monkey Manip Stepper Mod/37d-gearmotor-3d-models/pololu-2266-model.step.SLDPRT
35.0 x 51.0 x 41.3 mm
