jamestorrissonwong/NML-CAD/Manips/Monkey Manip/Angle B/45 Stop vB.SLDPRT

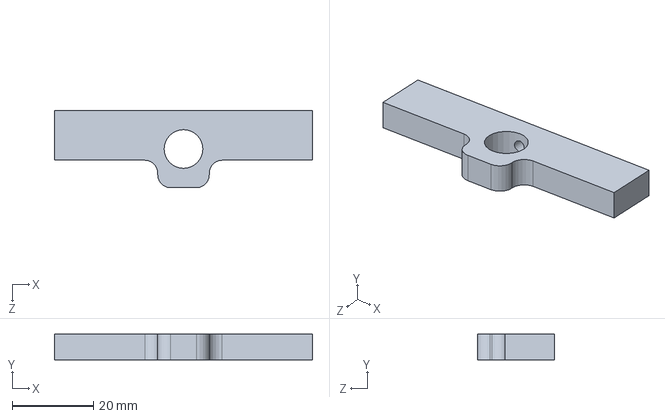
[picture p93: CAD file, 2021-07-24]
Manips/Monkey Manip/Angle B/45 Stop vB.SLDPRT
63.5 x 6.35 x 19.1 mm
