jamestorrissonwong/NML-CAD/Manips/Torque Manip/Adapter Plate v2.STL

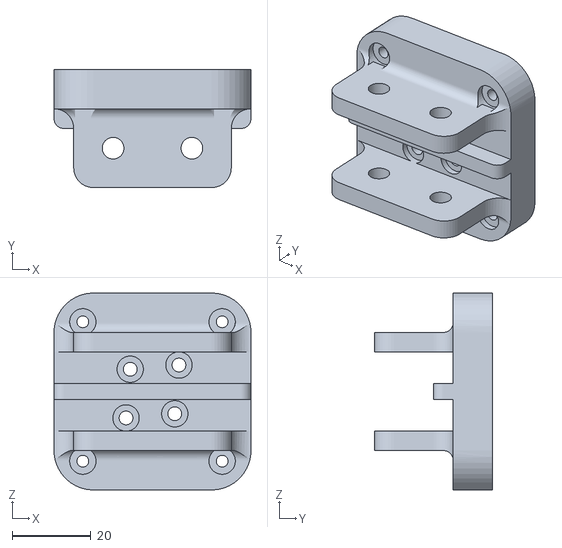
[picture p94: CAD file, 2022-08-11]
Manips/Torque Manip/Adapter Plate v2.STL
50.0 x 30.0 x 50.0
