jamestorrissonwong/NML-CAD/Monkey Cage Training/Acrylic ICTS/Acrylic.SLDPRT

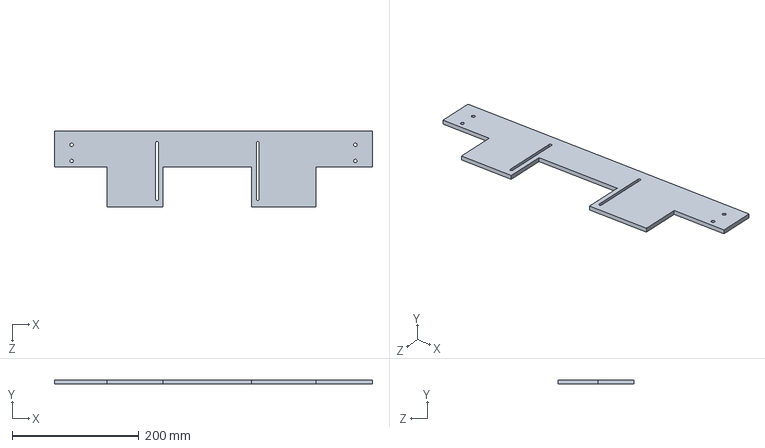
[picture p95: CAD file, 2021-12-19]
Monkey Cage Training/Acrylic ICTS/Acrylic.SLDPRT
501.6 x 6.35 x 120.6 mm
