jamestorrissonwong/NML-CAD/Monkey Cage Training/Acrylic ICTS/Thicker/Acrylic-back-v3.SLDPRT

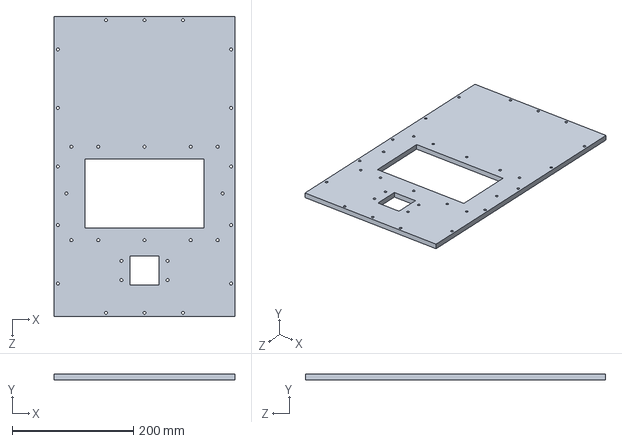
[picture p96: CAD file, 2022-06-04]
Monkey Cage Training/Acrylic ICTS/Thicker/Acrylic-back-v3.SLDPRT
298.4 x 9.53 x 495.3 mm
