jamestorrissonwong/NML-CAD/Monkey Cage Training/Monkey Cage Extension/cage/Door End.SLDPRT

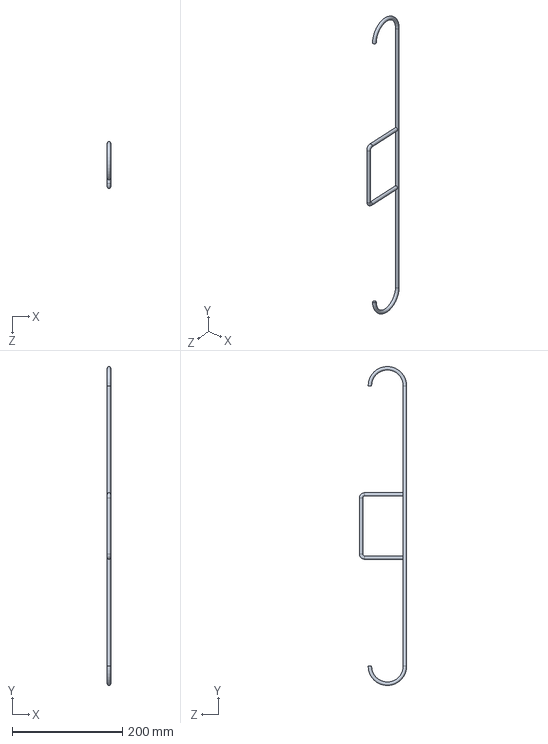
[picture p97: CAD file, 2021-08-06]
Monkey Cage Training/Monkey Cage Extension/cage/Door End.SLDPRT
6.35 x 577.8 x 85.7 mm
