jamestorrissonwong/NML-CAD/Monkey Cage Training/Monkey Cage Extension/raspberry-pi-4-model-b-1.snapshot.3/Female USB Type C Connector, RPi4ModelB.SLDPRT

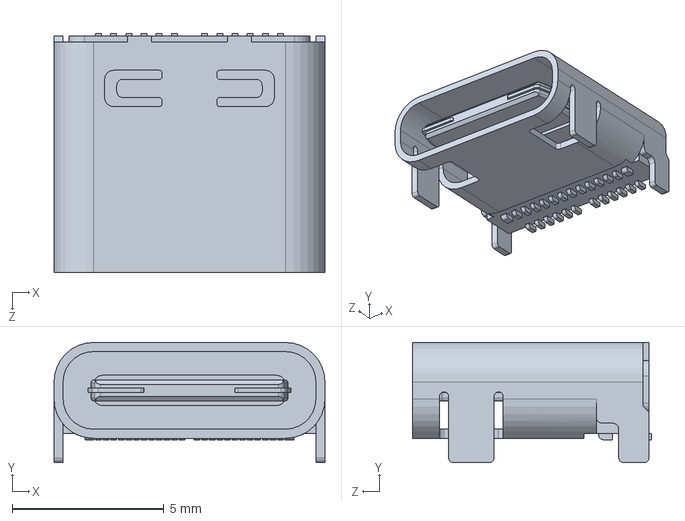
[picture p98: CAD file, 2021-07-24]
Monkey Cage Training/Monkey Cage Extension/raspberry-pi-4-model-b-1.snapshot.3/Female USB Type C Connector, RPi4ModelB.SLDPRT
8.94 x 3.96 x 7.90 mm
