jamestorrissonwong/NML-CAD/Monkey Cage Training/Monkey Cage Extension/Springs/Top Plate.SLDPRT

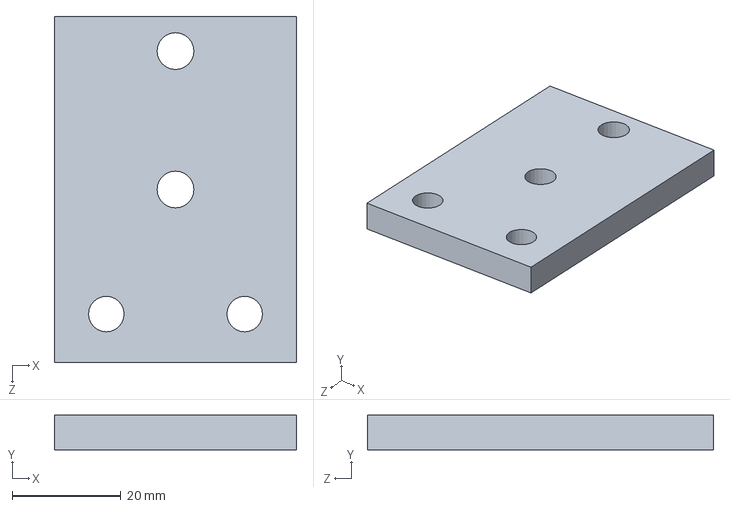
[picture p99: CAD file, 2021-07-24]
Monkey Cage Training/Monkey Cage Extension/Springs/Top Plate.SLDPRT
44.5 x 6.35 x 63.5 mm
