jamestorrissonwong/NML-CAD/Monkey Chair/Arm Restraints/Arm Fixture.SLDPRT

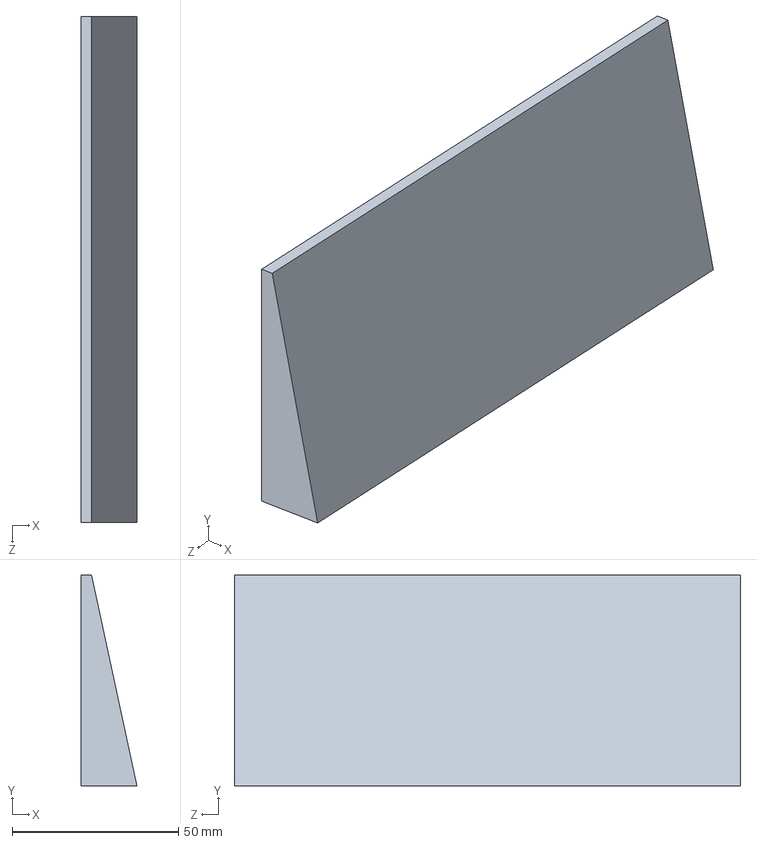
[picture p100: CAD file, 2022-08-11]
Monkey Chair/Arm Restraints/Arm Fixture.SLDPRT
16.8 x 63.5 x 152.4 mm
