jamestorrissonwong/NML-CAD/Monkey Chair/Drawings and CAM/Complete/Neck Plate.DXF

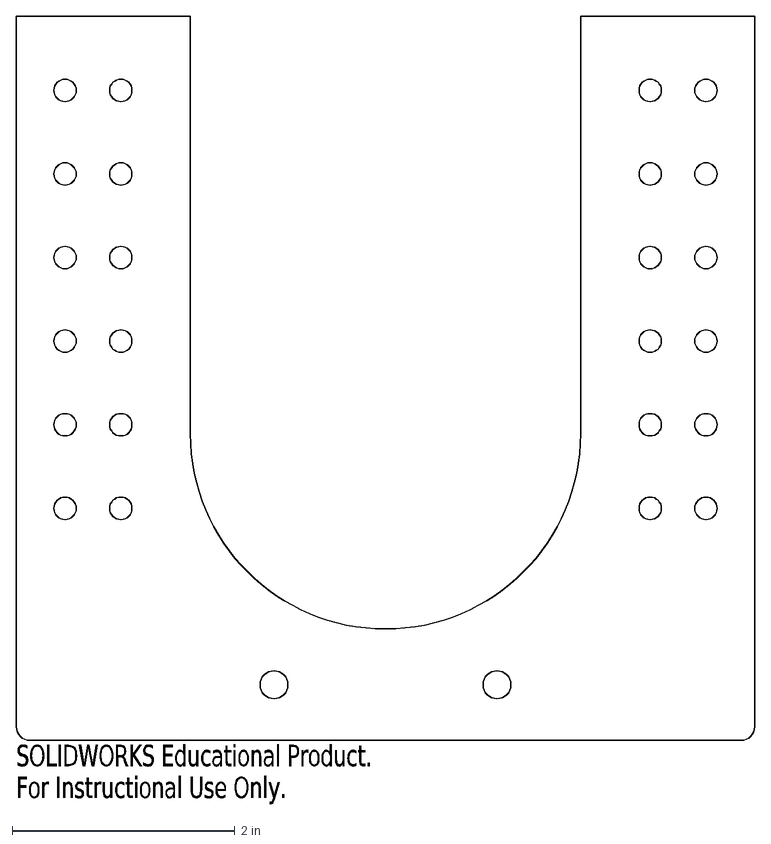
[picture p101: CAD file, 2022-08-11]
Monkey Chair/Drawings and CAM/Complete/Neck Plate.DXF
SOLIDWORKS Educational Product.
For Instructional Use Only.
