jamestorrissonwong/NML-CAD/Monkey Chair/Drawings and CAM/Seat Side.DXF

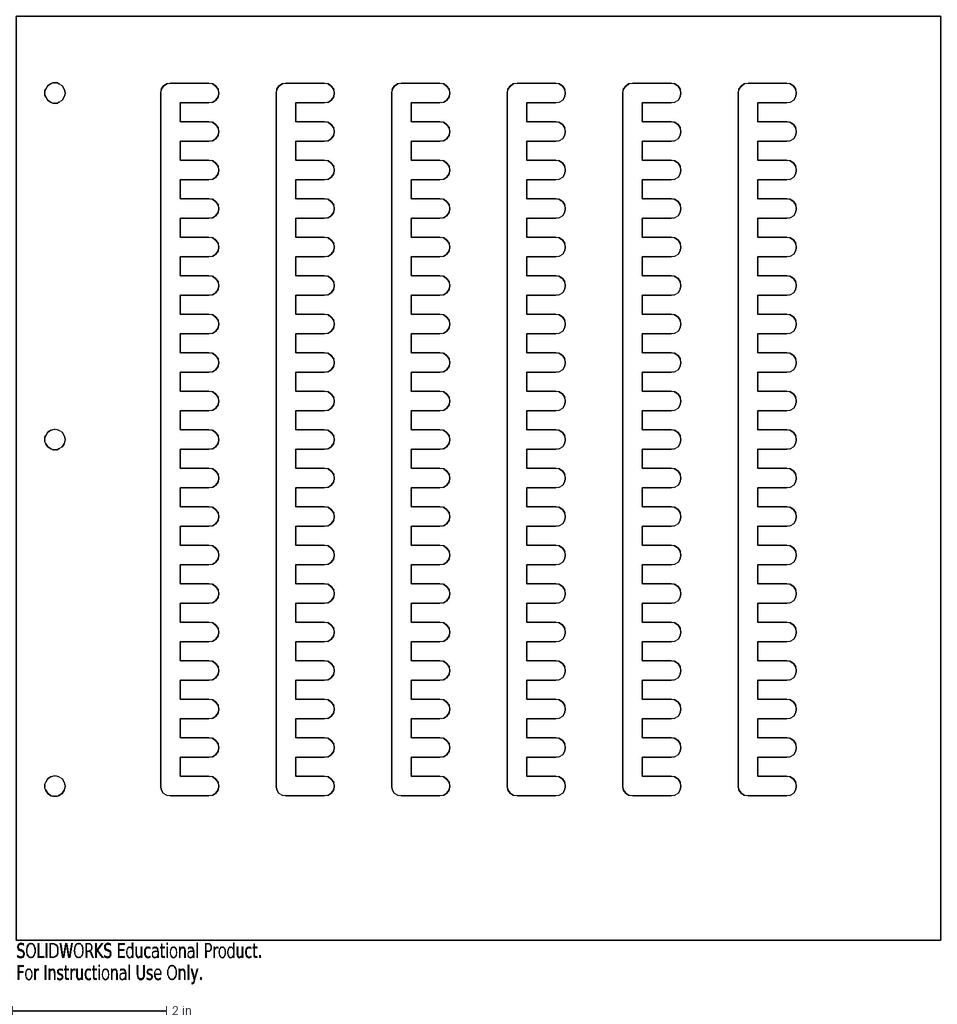
[picture p102: CAD file, 2022-08-11]
Monkey Chair/Drawings and CAM/Seat Side.DXF
SOLIDWORKS Educational Product.
For Instructional Use Only.
