jamestorrissonwong/NML-CAD/Monkey Chair/Tube Coupler A.SLDPRT

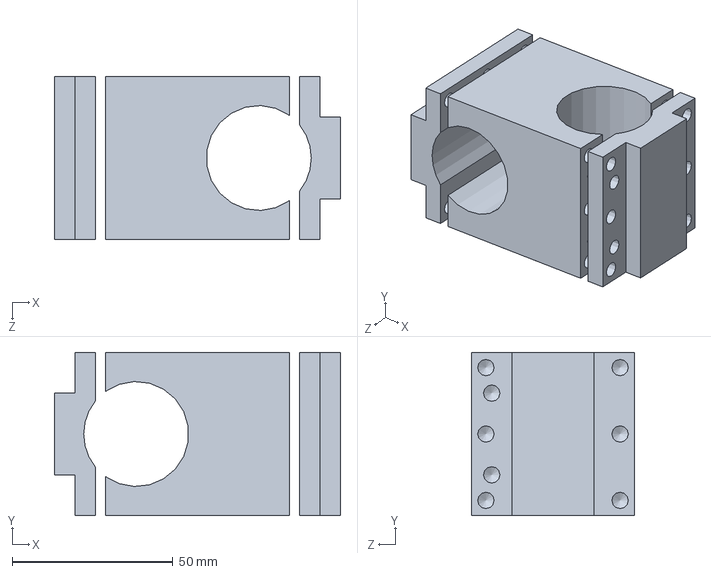
[picture p103: CAD file, 2022-08-11]
Monkey Chair/Tube Coupler A.SLDPRT
88.9 x 50.8 x 50.8 mm
