jamestorrissonwong/NML-CAD/Monkey Collars/Collar Small Right.STL

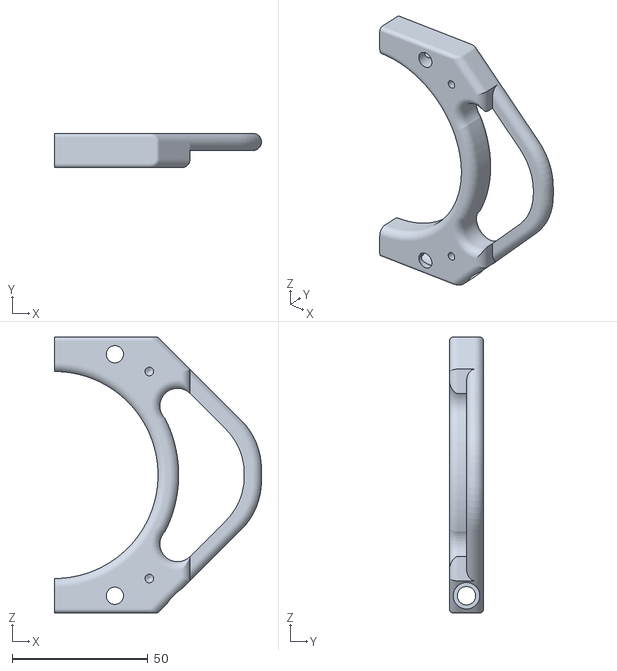
[picture p104: CAD file, 2022-08-11]
Monkey Collars/Collar Small Right.STL
76.2 x 12.7 x 101.6
