jamestorrissonwong/NML-CAD/Monkey Sippers/Monkey Sipper/Slots/straw.SLDPRT

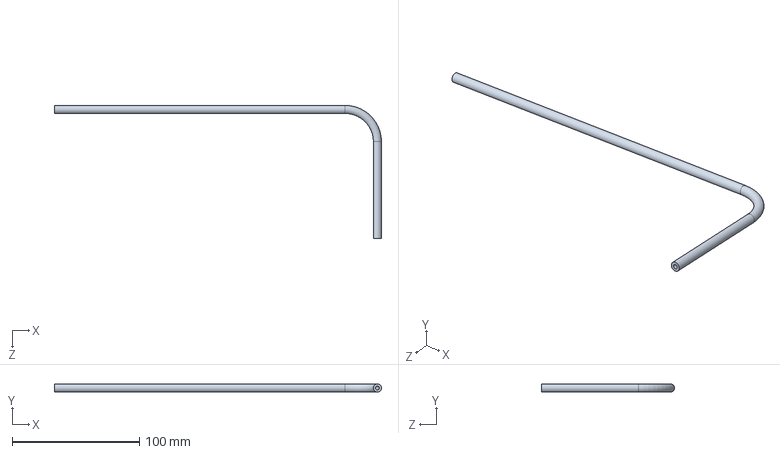
[picture p105: CAD file, 2022-06-04]
Monkey Sippers/Monkey Sipper/Slots/straw.SLDPRT
257.2 x 6.35 x 104.8 mm
