jamestorrissonwong/NML-CAD/Monkey Sippers/New Sipper (Jonathan)/NHP-Chair_t-track-linear-positioner.SLDPRT

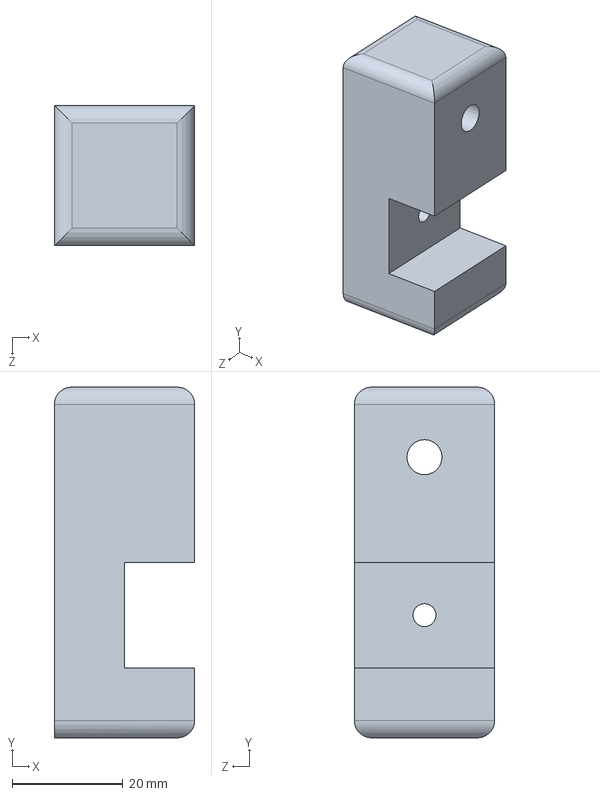
[picture p106: CAD file, 2021-08-28]
Monkey Sippers/New Sipper (Jonathan)/NHP-Chair_t-track-linear-positioner.SLDPRT
25.4 x 63.5 x 25.4 mm
