jamestorrissonwong/NML-CAD/PCBs/flex-1A-V7.step

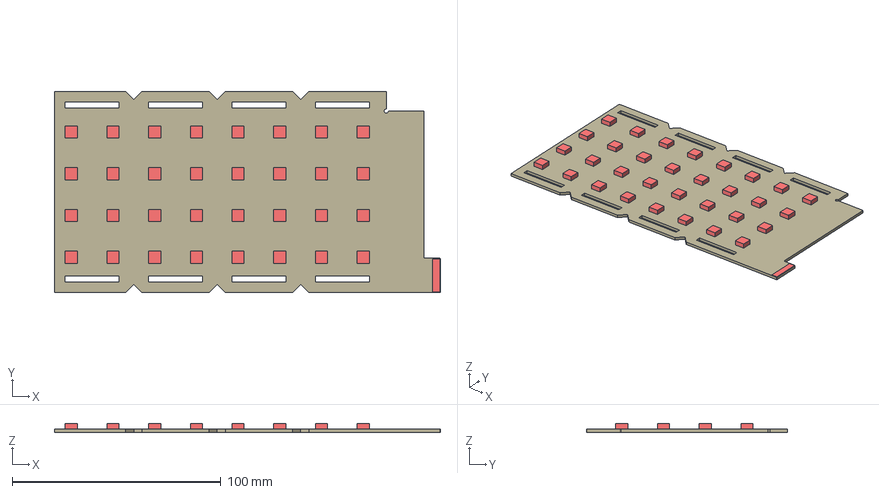
[picture p107: CAD file, 2022-02-23]
PCBs/flex-1A-V7.step
185.0 x 96.5 x 4.16 mm
Board
FLEX32PIN
MOUNT-PAD-ROUND3.2 x 32
