jamestorrissonwong/NML-CAD/Ernesto/Wrist Force Transducer/FT Holder.SLDPRT

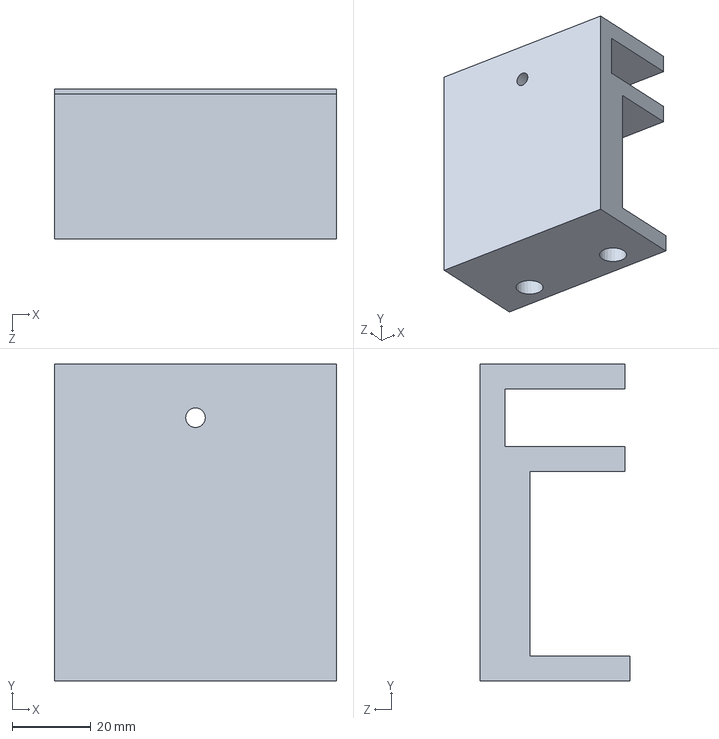
[picture p108: CAD file, 2021-07-24]
Ernesto/Wrist Force Transducer/FT Holder.SLDPRT
71.4 x 80.3 x 38.1 mm
