jamestorrissonwong/NML-CAD/Manips/Human Manip/Bar Stock/mm encoder mount.SLDPRT

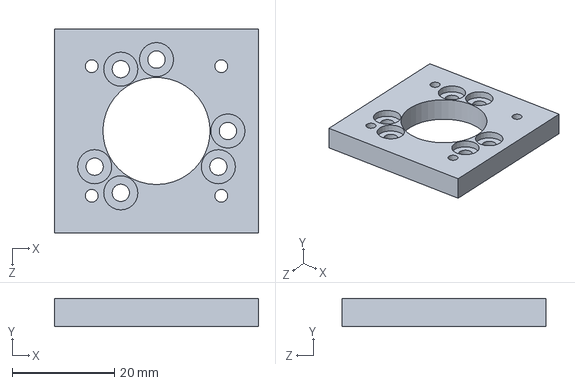
[picture p109: CAD file, 2022-02-23]
Manips/Human Manip/Bar Stock/mm encoder mount.SLDPRT
40.0 x 5.50 x 40.0 mm
