jamestorrissonwong/NML-CAD/Manips/Human Manip/Rotary Encoder.SLDPRT

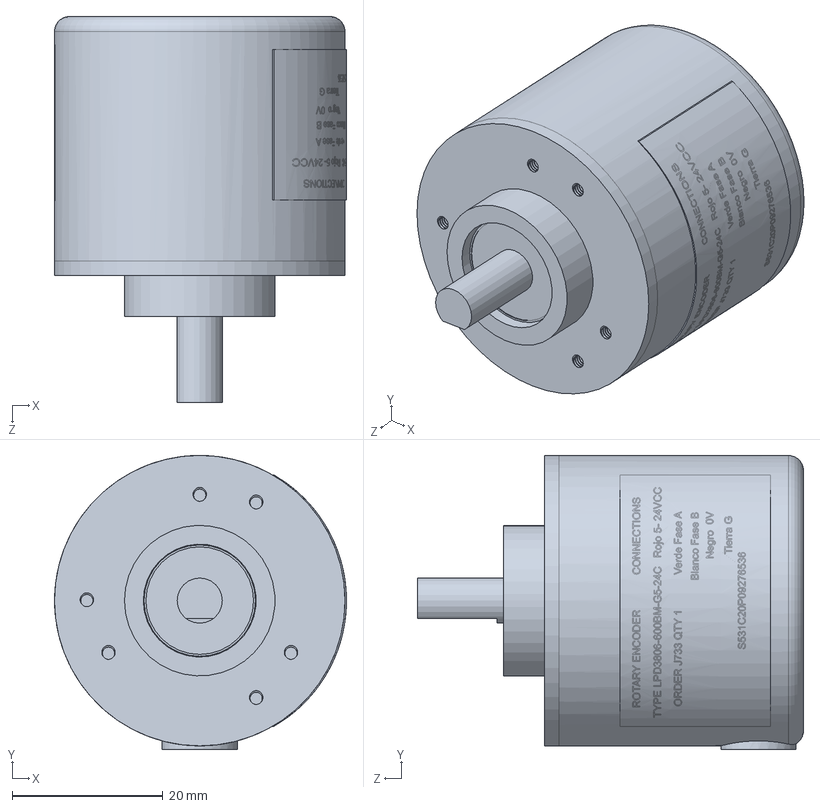
[picture p110: CAD file, 2022-02-23]
Manips/Human Manip/Rotary Encoder.SLDPRT
38.8 x 39.1 x 51.3 mm
