jamestorrissonwong/NML-CAD/Manips/Human Manip/STLS/Prev STLs/Inner Horizontal.STL

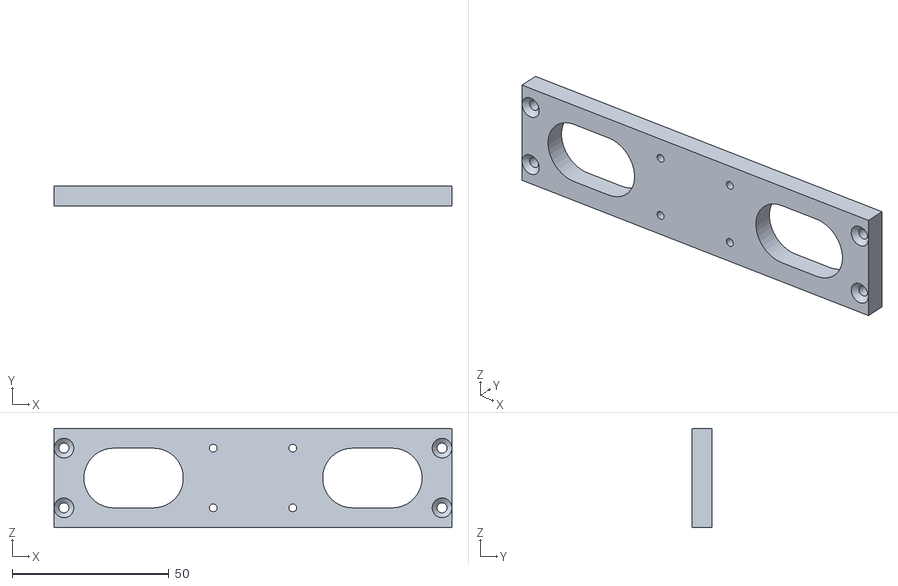
[picture p111: CAD file, 2021-12-19]
Manips/Human Manip/STLS/Prev STLs/Inner Horizontal.STL
127.0 x 6.35 x 31.8
