jamestorrissonwong/NML-CAD/Manips/Monkey Manip Stepper Mod/37d-gearmotor-3d-models/37d-gearmotor-19-30-encoder.step

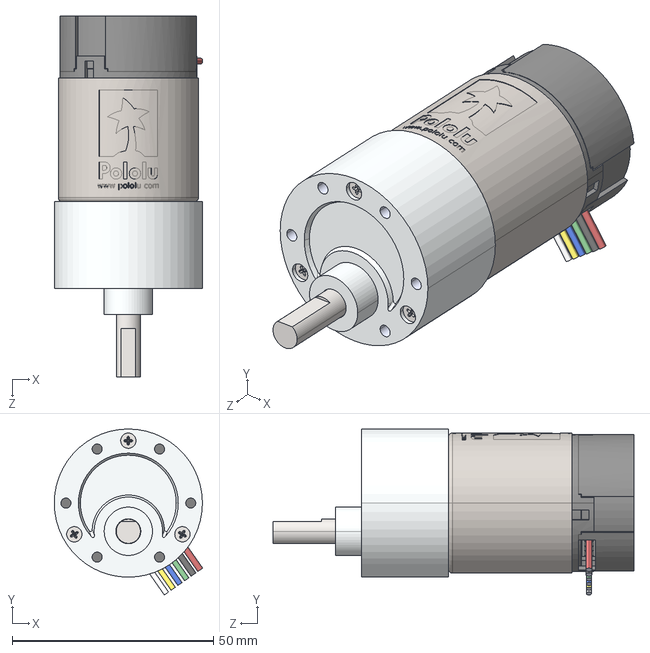
[picture p112: CAD file, 2021-07-24]
Manips/Monkey Manip Stepper Mod/37d-gearmotor-3d-models/37d-gearmotor-19-30-encoder.step
36.9 x 41.2 x 89.6 mm
