jamestorrissonwong/NML-CAD/Manips/Monkey Manip Stepper Mod/nema-17-stepper-motor-1.snapshot.2/NEMA 17 Stepper Motor Bottom.SLDPRT

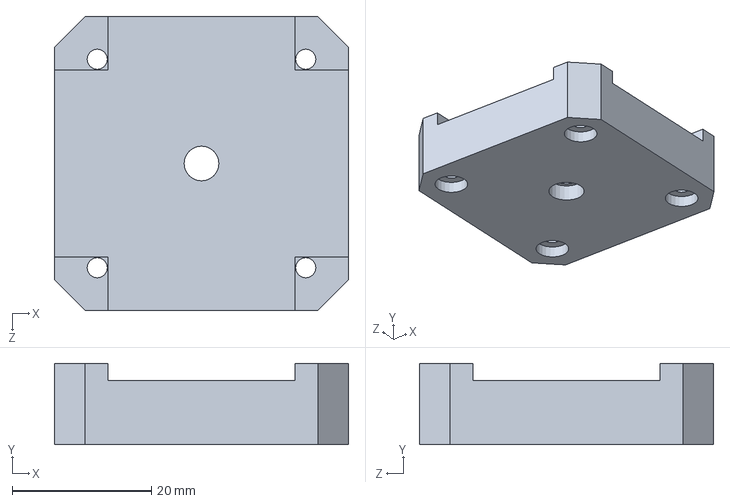
[picture p113: CAD file, 2021-07-24]
Manips/Monkey Manip Stepper Mod/nema-17-stepper-motor-1.snapshot.2/NEMA 17 Stepper Motor Bottom.SLDPRT
42.3 x 11.7 x 42.3 mm
