jamestorrissonwong/NML-CAD/Manips/Monkey Manip Stepper Mod/X mount.SLDPRT

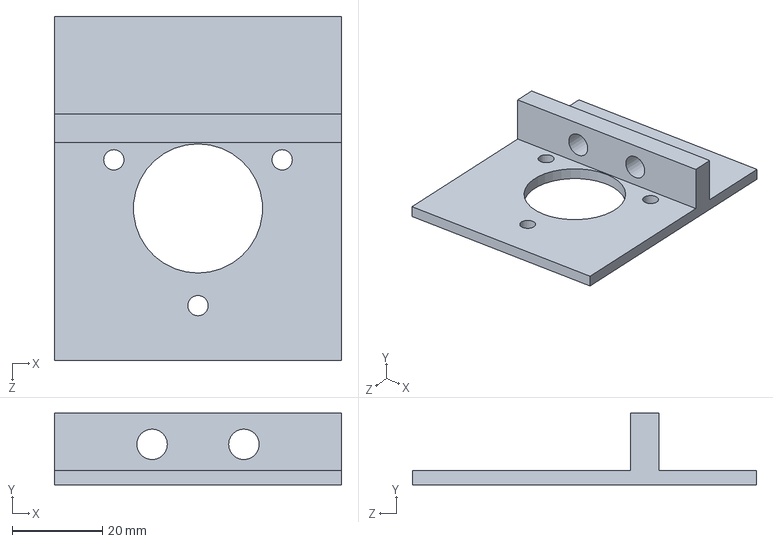
[picture p114: CAD file, 2021-07-24]
Manips/Monkey Manip Stepper Mod/X mount.SLDPRT
63.5 x 15.9 x 76.2 mm
