jamestorrissonwong/NML-CAD/Manips/Monkey Manip/Angle A/45 Stop Mid.SLDPRT

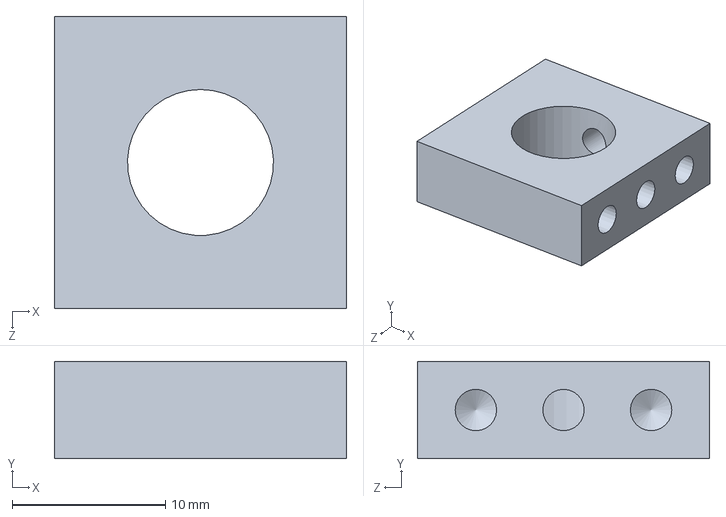
[picture p115: CAD file, 2021-07-24]
Manips/Monkey Manip/Angle A/45 Stop Mid.SLDPRT
19.1 x 6.35 x 19.1 mm
