jamestorrissonwong/NML-CAD/Manips/Monkey Manip/Angle D/45 Stop Arm v2.SLDPRT

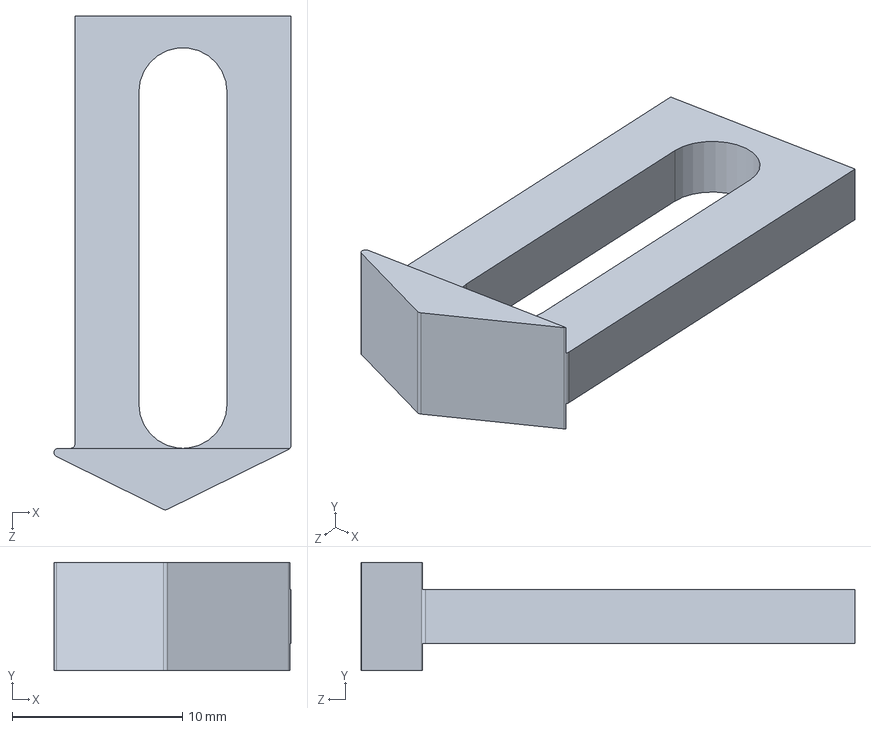
[picture p116: CAD file, 2021-07-24]
Manips/Monkey Manip/Angle D/45 Stop Arm v2.SLDPRT
13.9 x 6.35 x 29.0 mm
