jamestorrissonwong/NML-CAD/Manips/Monkey Manip/Angle E/45 Stop Mid v3.SLDPRT

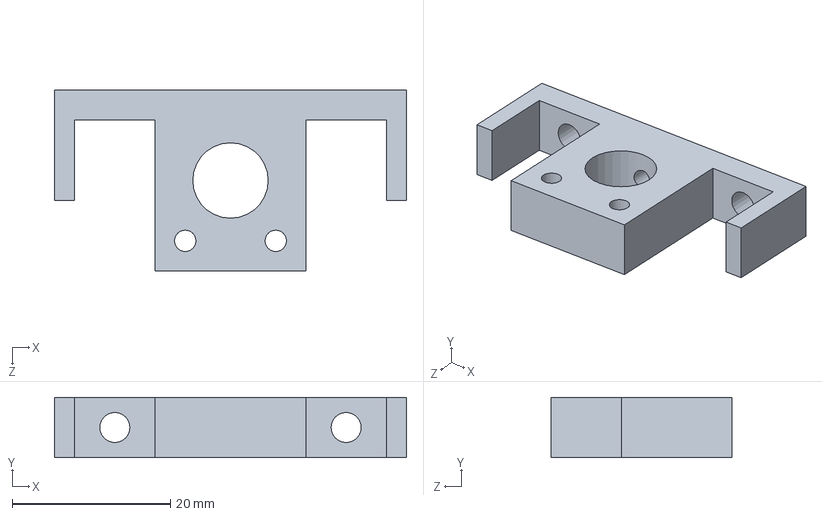
[picture p117: CAD file, 2021-07-24]
Manips/Monkey Manip/Angle E/45 Stop Mid v3.SLDPRT
44.5 x 7.62 x 22.9 mm
