jamestorrissonwong/NML-CAD/Manips/Monkey Manip/Y Limiter U22.SLDPRT

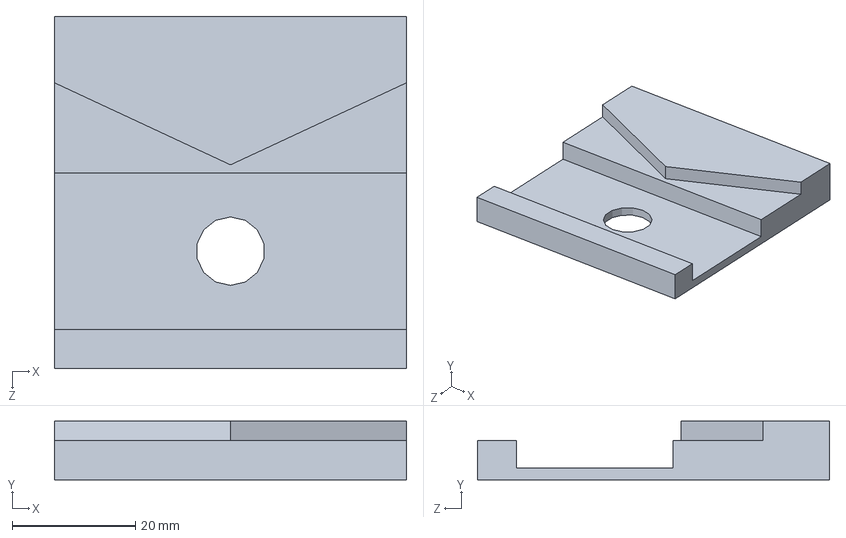
[picture p118: CAD file, 2022-08-11]
Manips/Monkey Manip/Y Limiter U22.SLDPRT
57.1 x 9.53 x 57.1 mm
