jamestorrissonwong/NML-CAD/Manips/Torque Manip/Concentric Plate.SLDPRT

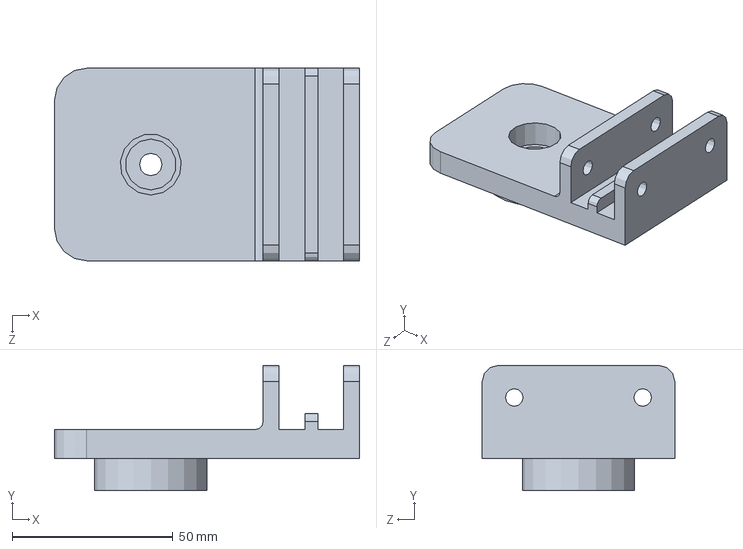
[picture p119: CAD file, 2022-08-11]
Manips/Torque Manip/Concentric Plate.SLDPRT
95.0 x 39.0 x 60.0 mm
