jamestorrissonwong/NML-CAD/Monkey Cage Training/Acrylic ICTS/Thicker/Acrylic-Side-v4.SLDPRT

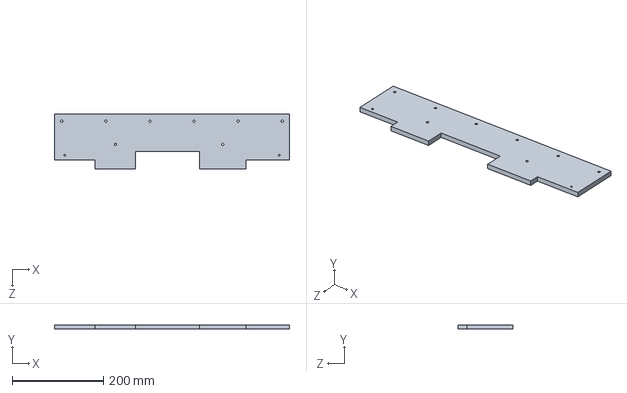
[picture p120: CAD file, 2022-06-04]
Monkey Cage Training/Acrylic ICTS/Thicker/Acrylic-Side-v4.SLDPRT
514.3 x 9.53 x 120.6 mm
