jamestorrissonwong/NML-CAD/Monkey Cage Training/Monkey Cage Extension/cage/rail.SLDPRT

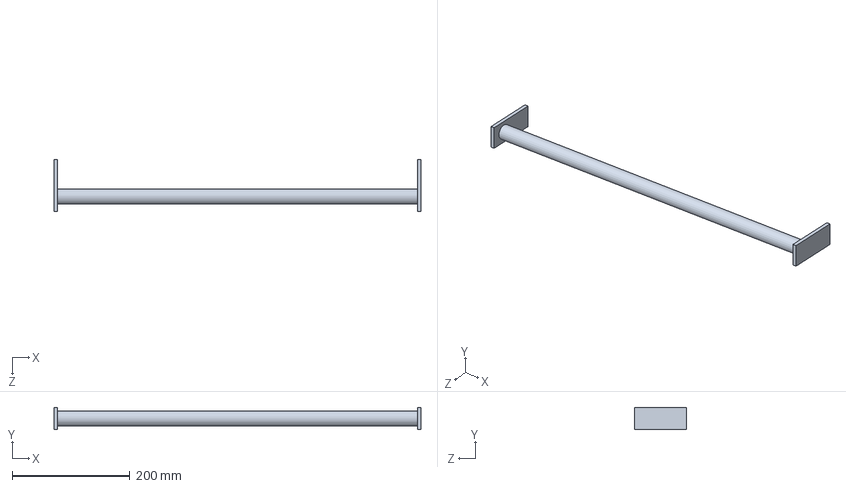
[picture p121: CAD file, 2021-08-06]
Monkey Cage Training/Monkey Cage Extension/cage/rail.SLDPRT
622.3 x 38.1 x 88.9 mm
