jamestorrissonwong/NML-CAD/Monkey Cage Training/Monkey Cage Extension/raspberry-pi-4-model-b-1.snapshot.3/Female Micro HDMI Connector, RPi4ModelB.SLDPRT

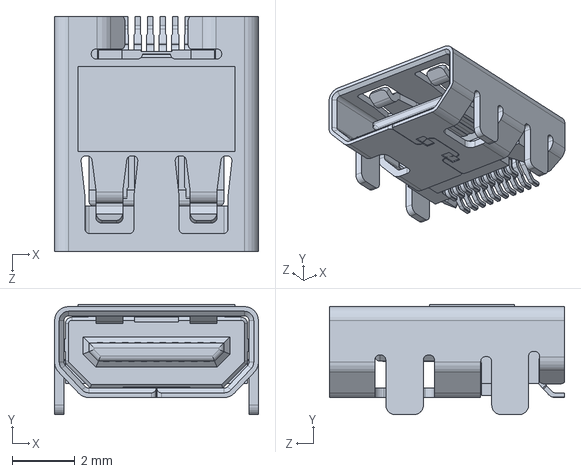
[picture p122: CAD file, 2021-07-24]
Monkey Cage Training/Monkey Cage Extension/raspberry-pi-4-model-b-1.snapshot.3/Female Micro HDMI Connector, RPi4ModelB.SLDPRT
6.50 x 3.52 x 7.50 mm
