jamestorrissonwong/NML-CAD/Monkey Chair/Attachment/Top Plate.SLDPRT

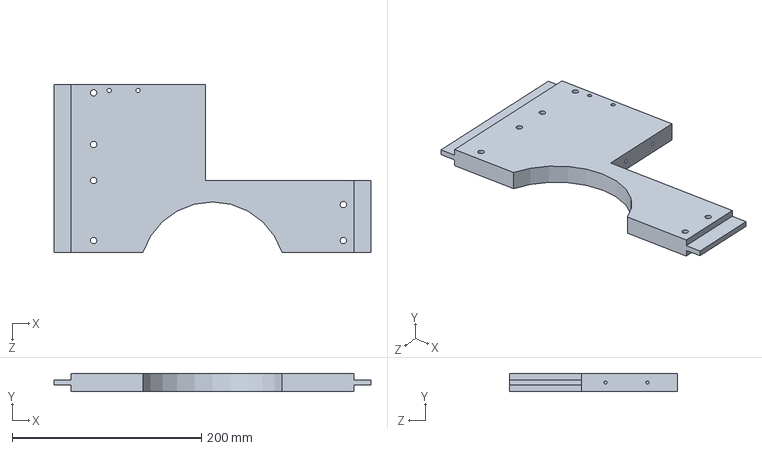
[picture p123: CAD file, 2022-06-11]
Monkey Chair/Attachment/Top Plate.SLDPRT
335.3 x 19.1 x 177.8 mm
