jamestorrissonwong/NML-CAD/Monkey Chair/Drawings and CAM/Complete/Arm Pipe Cap.DXF

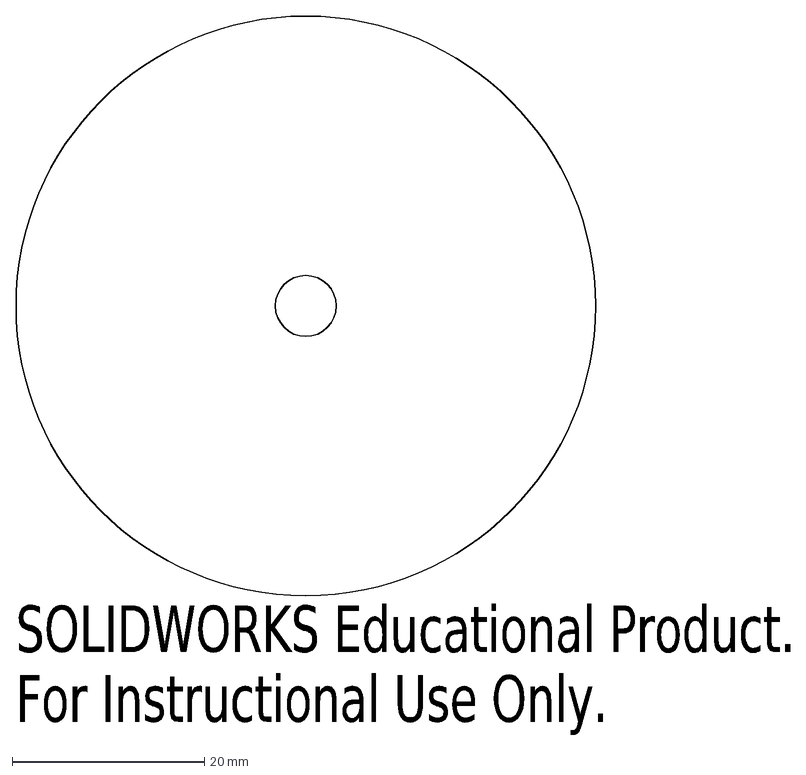
[picture p124: CAD file, 2022-08-11]
Monkey Chair/Drawings and CAM/Complete/Arm Pipe Cap.DXF
SOLIDWORKS Educational Product.
For Instructional Use Only.
