jamestorrissonwong/NML-CAD/Monkey Chair/Hole Plate.SLDPRT

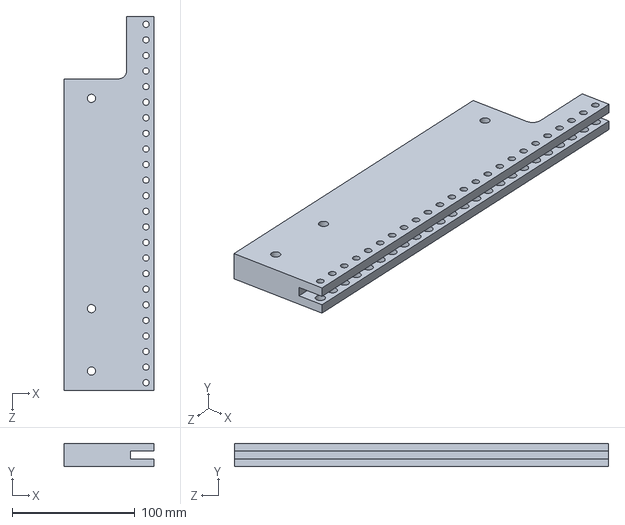
[picture p125: CAD file, 2022-08-11]
Monkey Chair/Hole Plate.SLDPRT
73.0 x 19.1 x 304.8 mm
