jamestorrissonwong/NML-CAD/Monkey Collars/Collar Small.3mf

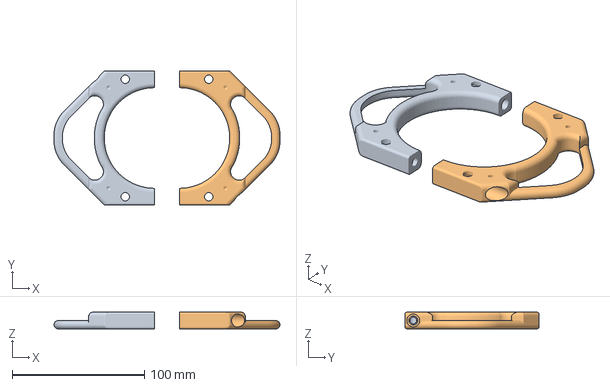
[picture p126: CAD file, 2022-08-11]
Monkey Collars/Collar Small.3mf
171.1 x 101.6 x 12.7 mm
Collar Small Left.STL
Collar Small Right.STL
