jamestorrissonwong/NML-CAD/Monkey Sippers/Monkey Sipper/Hex Rails/Hex End.SLDPRT

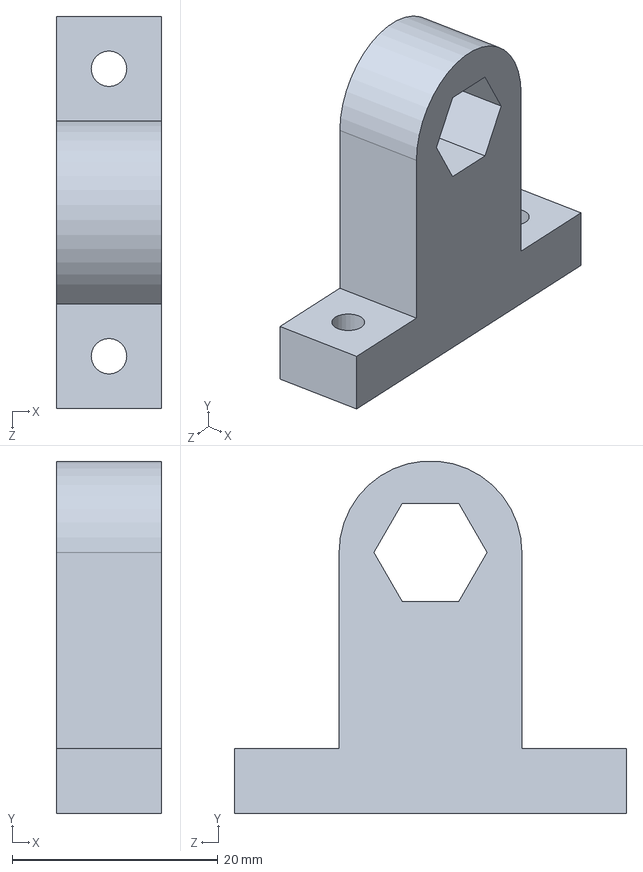
[picture p127: CAD file, 2021-07-24]
Monkey Sippers/Monkey Sipper/Hex Rails/Hex End.SLDPRT
10.2 x 34.3 x 38.1 mm
