jamestorrissonwong/NML-CAD/Monkey Sippers/New Sipper (Jonathan)/NHP-Chair_straw-mount.SLDPRT

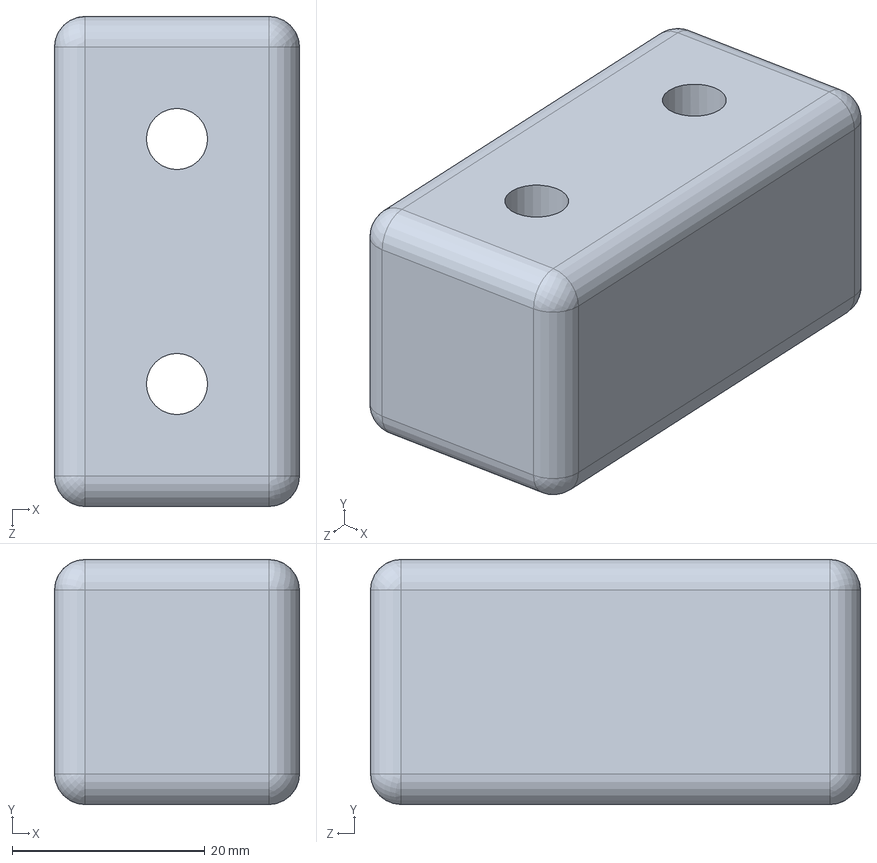
[picture p128: CAD file, 2021-08-28]
Monkey Sippers/New Sipper (Jonathan)/NHP-Chair_straw-mount.SLDPRT
25.4 x 25.4 x 50.8 mm
