jamestorrissonwong/NML-CAD/Monkey Sippers/Sipper Fixturing Track/Block 1.SLDPRT

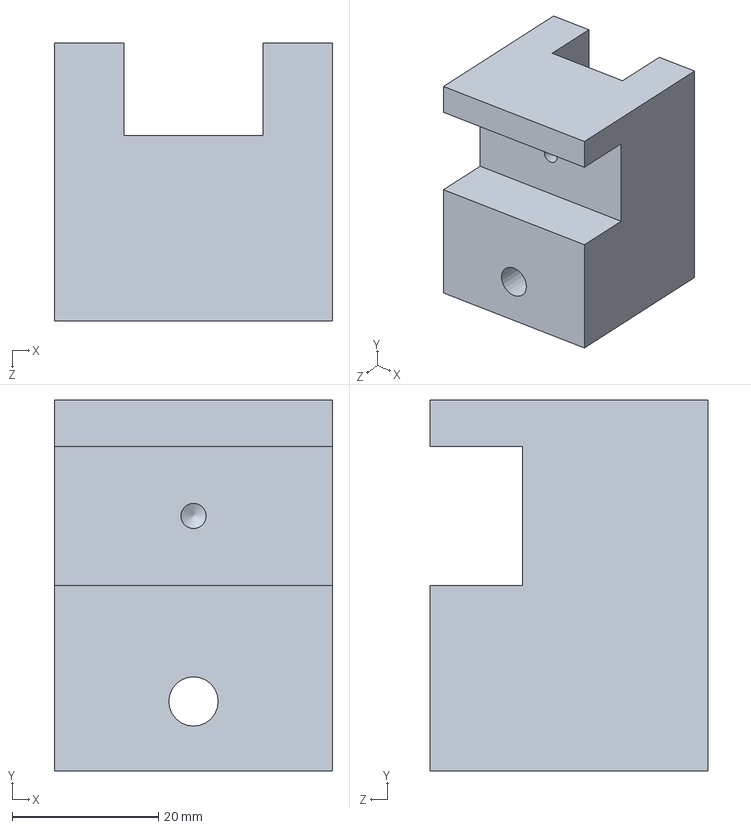
[picture p129: CAD file, 2021-12-15]
Monkey Sippers/Sipper Fixturing Track/Block 1.SLDPRT
38.1 x 50.8 x 38.1 mm
