jamestorrissonwong/NML-CAD/PCBs/flex-1C-V7.step

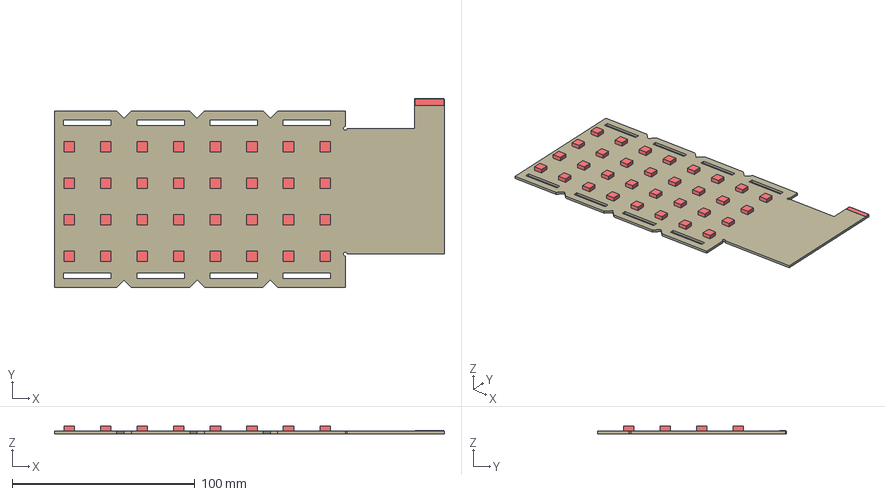
[picture p130: CAD file, 2022-02-23]
PCBs/flex-1C-V7.step
213.2 x 103.2 x 4.16 mm
Board
FLEX32PIN
MOUNT-PAD-ROUND3.2 x 32
