jamestorrissonwong/NML-CAD/PCBs/Intan Headstage/0402c_2320560.sldprt

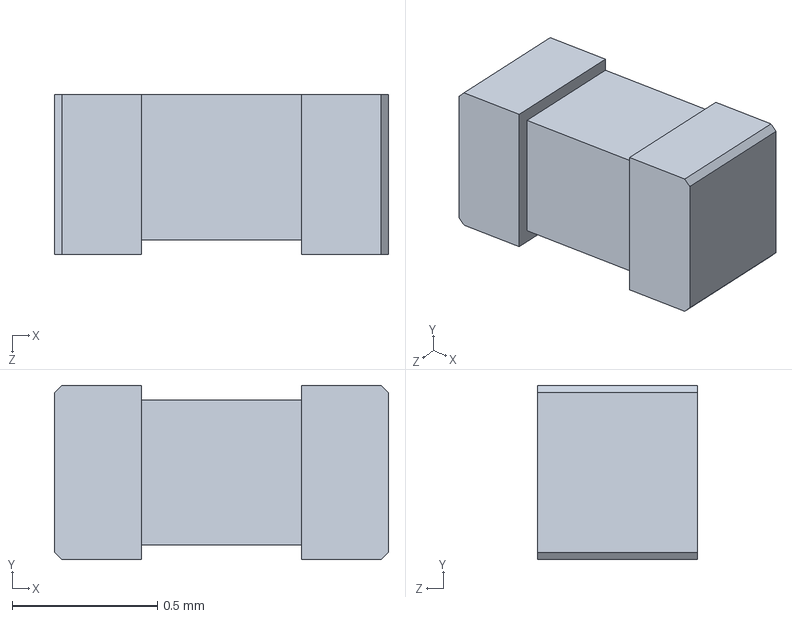
[picture p131: CAD file, 2021-07-24]
PCBs/Intan Headstage/0402c_2320560.sldprt
1.15 x 0.6 x 0.55 mm
