jamestorrissonwong/NML-CAD/Rupert Bite Guard v4.dxf

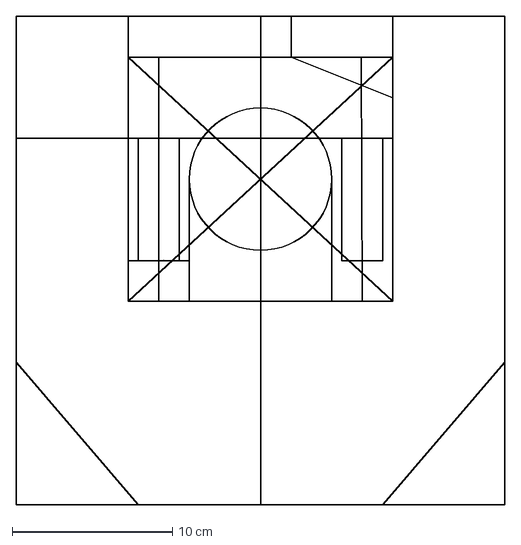
[picture p132: CAD file, 2022-02-23]
Rupert Bite Guard v4.dxf
30.5 x 30.5 cm
