jamestorrissonwong/NML-CAD/Ernesto/Forearm Platform/1258A1_INCREMENTAL-ANGLE HINGE.SLDPRT

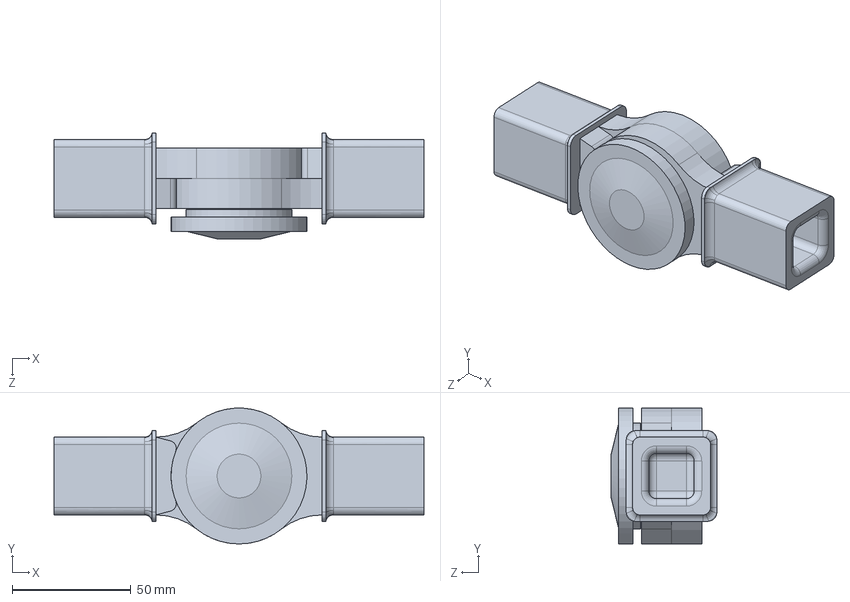
[picture p133: CAD file, 2021-07-24]
Ernesto/Forearm Platform/1258A1_INCREMENTAL-ANGLE HINGE.SLDPRT
155.6 x 57.1 x 44.5 mm
