jamestorrissonwong/NML-CAD/Manips/Monkey Manip Duplicate/Handle.SLDPRT

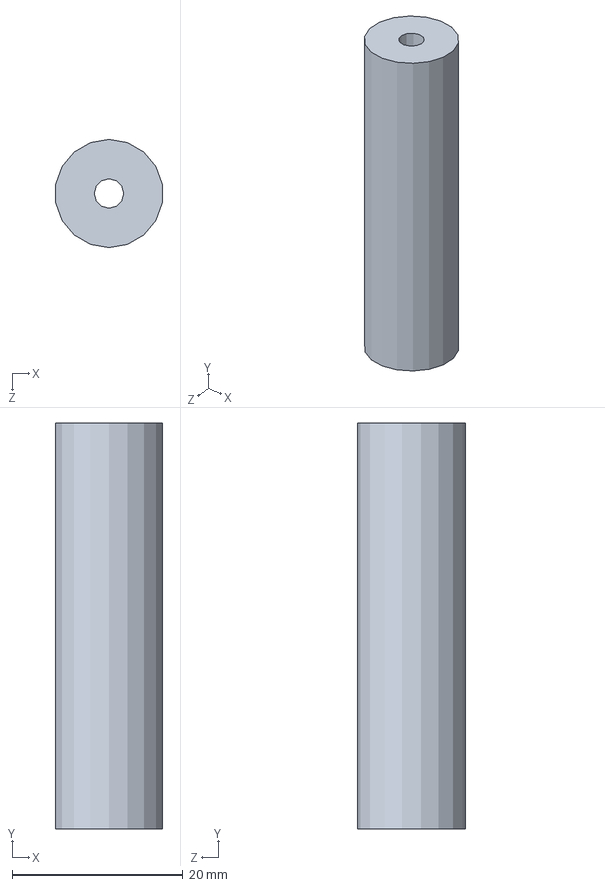
[picture p134: CAD file, 2022-08-11]
Manips/Monkey Manip Duplicate/Handle.SLDPRT
12.5 x 47.6 x 12.7 mm
