jamestorrissonwong/NML-CAD/Manips/Monkey Manip/Angle A/45 Stop Arm.SLDPRT

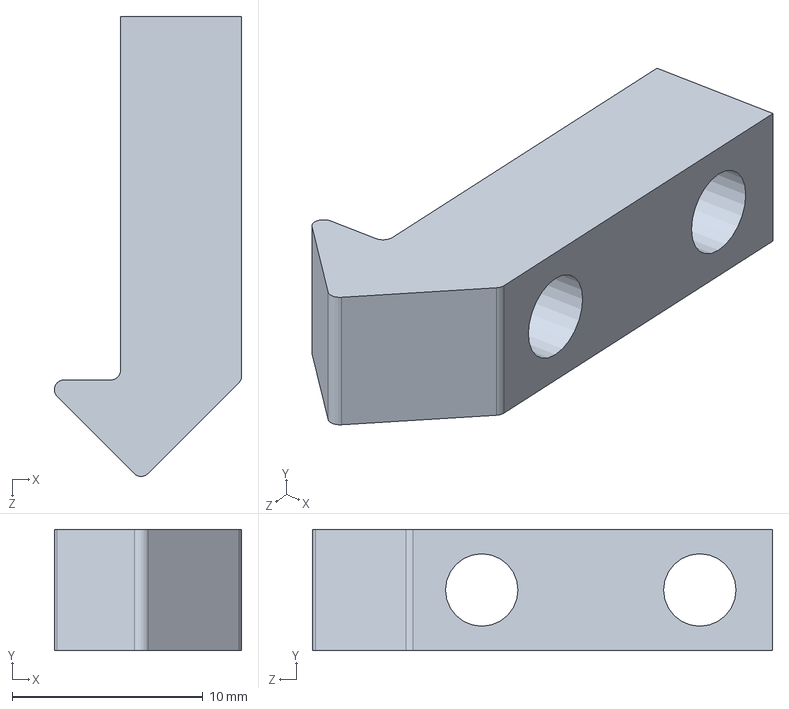
[picture p136: CAD file, 2021-07-24]
Manips/Monkey Manip/Angle A/45 Stop Arm.SLDPRT
9.82 x 6.35 x 24.1 mm
