jamestorrissonwong/NML-CAD/Manips/Monkey Manip/Angle D/45 Stop Mid v2.SLDPRT

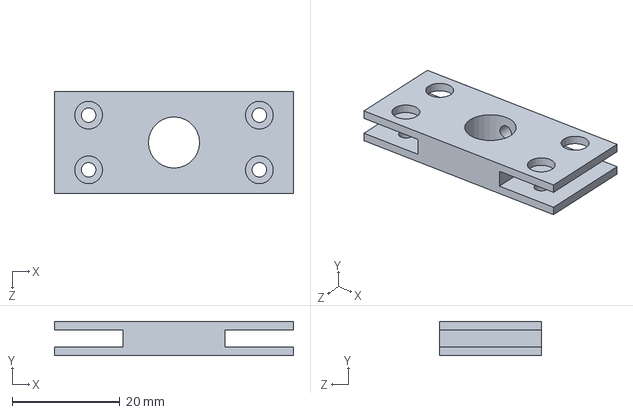
[picture p137: CAD file, 2021-07-24]
Manips/Monkey Manip/Angle D/45 Stop Mid v2.SLDPRT
44.5 x 6.35 x 19.1 mm
