jamestorrissonwong/NML-CAD/Manips/Monkey Manip/Cover/Cover Top vA.SLDPRT

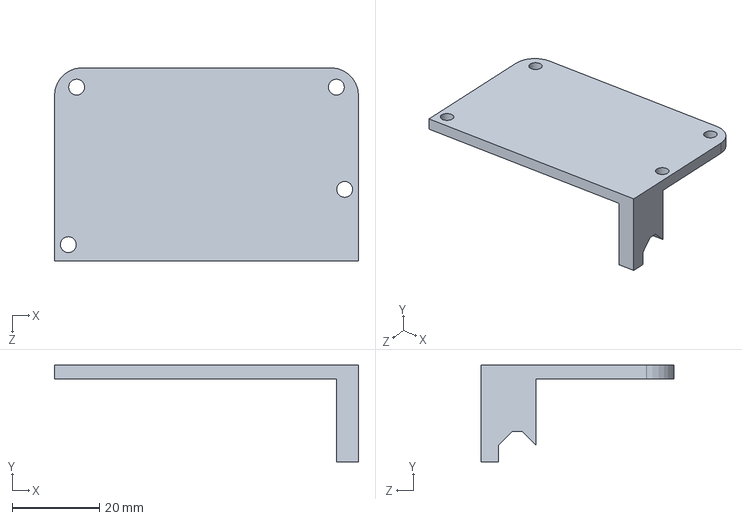
[picture p138: CAD file, 2022-06-04]
Manips/Monkey Manip/Cover/Cover Top vA.SLDPRT
69.8 x 22.2 x 44.5 mm
