jamestorrissonwong/NML-CAD/Manips/Monkey Manip/Shaft Adapter.SLDPRT

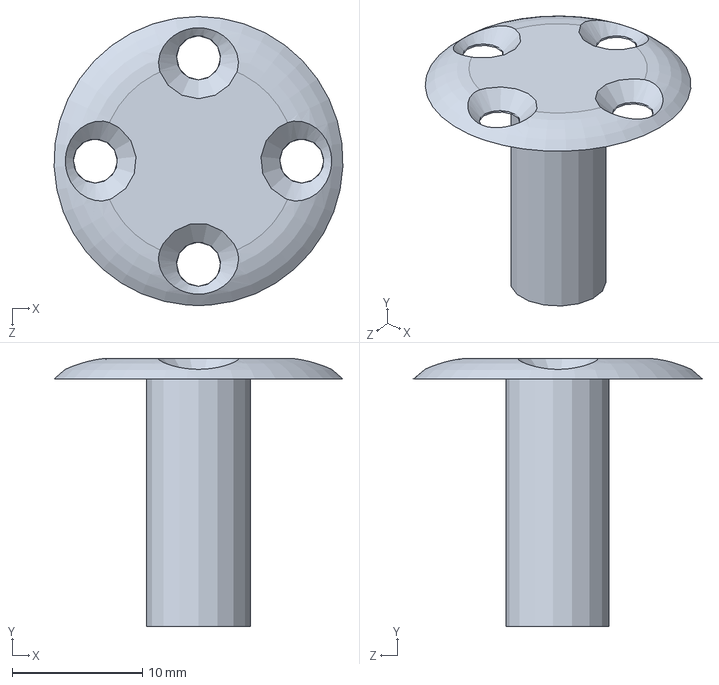
[picture p139: CAD file, 2022-08-11]
Manips/Monkey Manip/Shaft Adapter.SLDPRT
22.2 x 20.6 x 22.2 mm
