jamestorrissonwong/NML-CAD/Manips/Torque Manip/Tslot Corner.SLDPRT

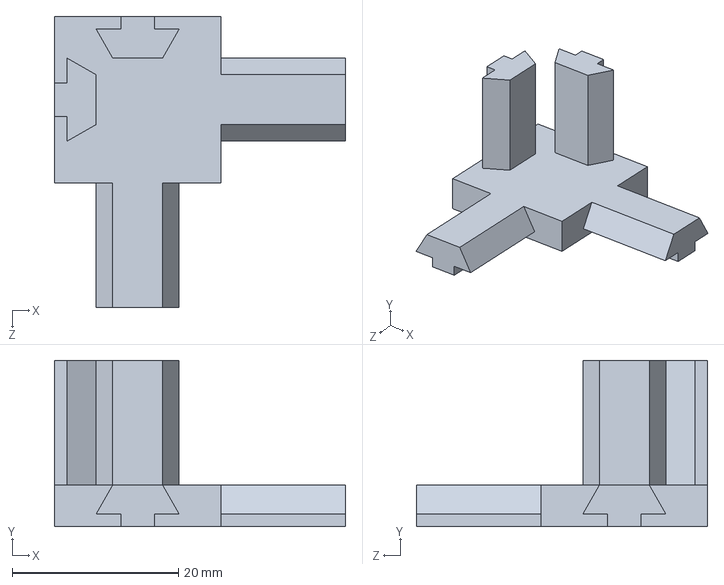
[picture p140: CAD file, 2022-08-11]
Manips/Torque Manip/Tslot Corner.SLDPRT
35.0 x 20.0 x 35.0 mm
