jamestorrissonwong/NML-CAD/Monkey Cage Training/Acrylic ICTS/Delrin.SLDPRT

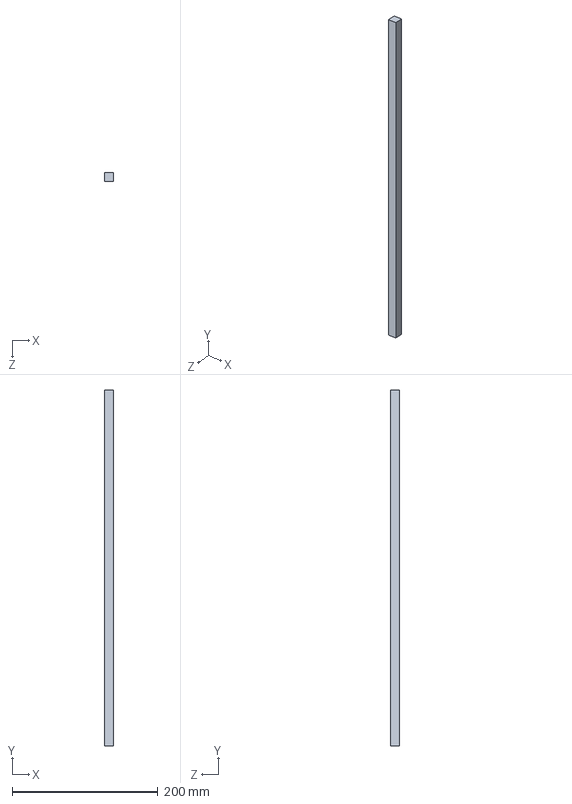
[picture p141: CAD file, 2021-12-19]
Monkey Cage Training/Acrylic ICTS/Delrin.SLDPRT
12.7 x 489.0 x 12.7 mm
