jamestorrissonwong/NML-CAD/Monkey Cage Training/Acrylic ICTS/DXFs for Cutting/Acrylic Additional Side.DXF

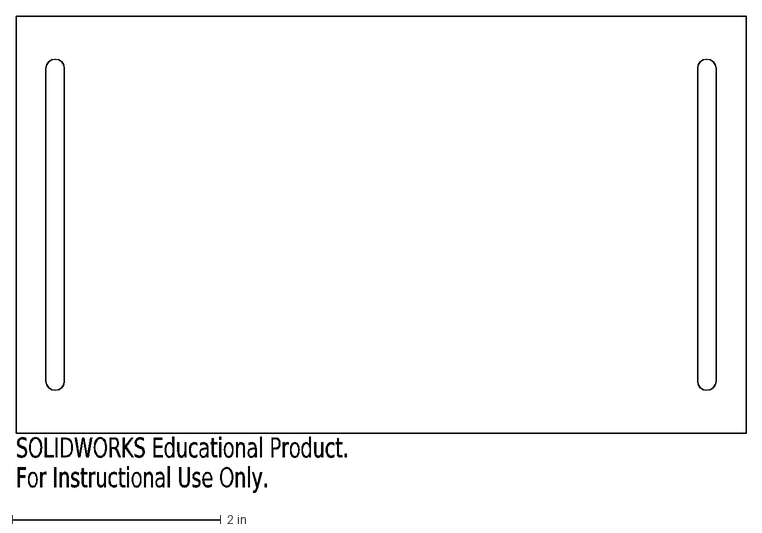
[picture p142: CAD file, 2022-02-23]
Monkey Cage Training/Acrylic ICTS/DXFs for Cutting/Acrylic Additional Side.DXF
SOLIDWORKS Educational Product.
For Instructional Use Only.
