jamestorrissonwong/NML-CAD/Monkey Cage Training/Acrylic ICTS/Thicker/Tablet Cover.SLDPRT

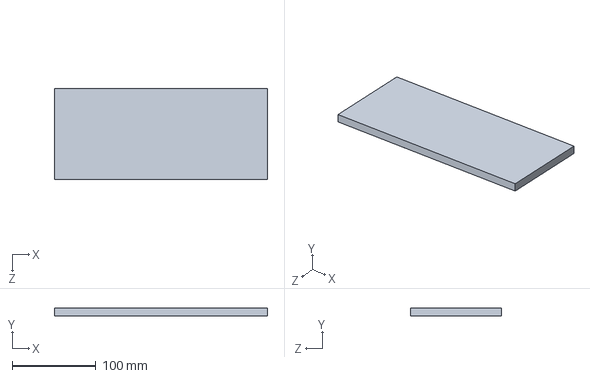
[picture p143: CAD file, 2022-06-04]
Monkey Cage Training/Acrylic ICTS/Thicker/Tablet Cover.SLDPRT
254.0 x 9.53 x 108.0 mm
