jamestorrissonwong/NML-CAD/Monkey Cage Training/Acrylic ICTS/TREC Mod/TM-Acrylic.SLDPRT

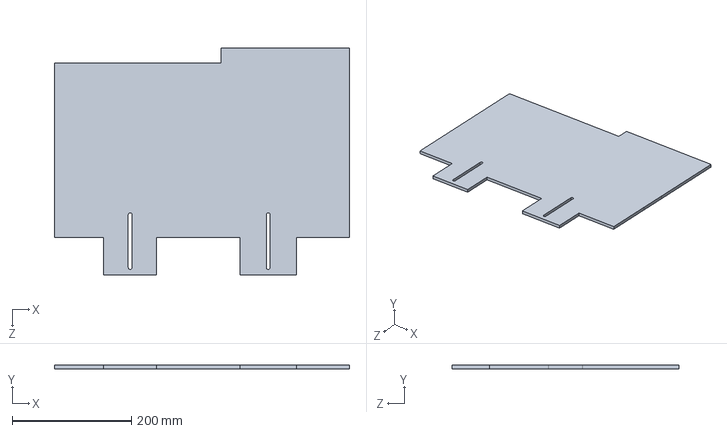
[picture p144: CAD file, 2021-12-15]
Monkey Cage Training/Acrylic ICTS/TREC Mod/TM-Acrylic.SLDPRT
495.3 x 6.35 x 381.6 mm
