jamestorrissonwong/NML-CAD/Monkey Cage Training/Monkey Cage Extension/raspberry-pi-4-model-b-1.snapshot.3/Cypress CYW43455 Wireless Module Cover, RPi4ModelB.SLDPRT

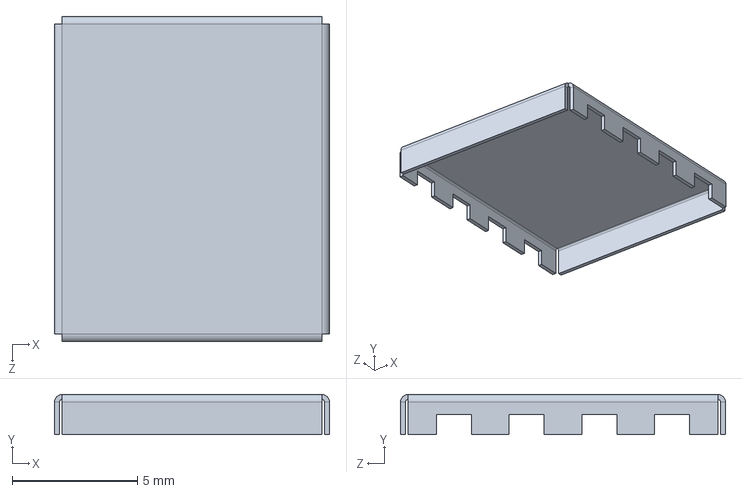
[picture p145: CAD file, 2021-07-24]
Monkey Cage Training/Monkey Cage Extension/raspberry-pi-4-model-b-1.snapshot.3/Cypress CYW43455 Wireless Module Cover, RPi4ModelB.SLDPRT
11.0 x 1.60 x 13.0 mm
