jamestorrissonwong/NML-CAD/Monkey Cage Training/Monkey Cage Extension/Springs/Hook.SLDPRT

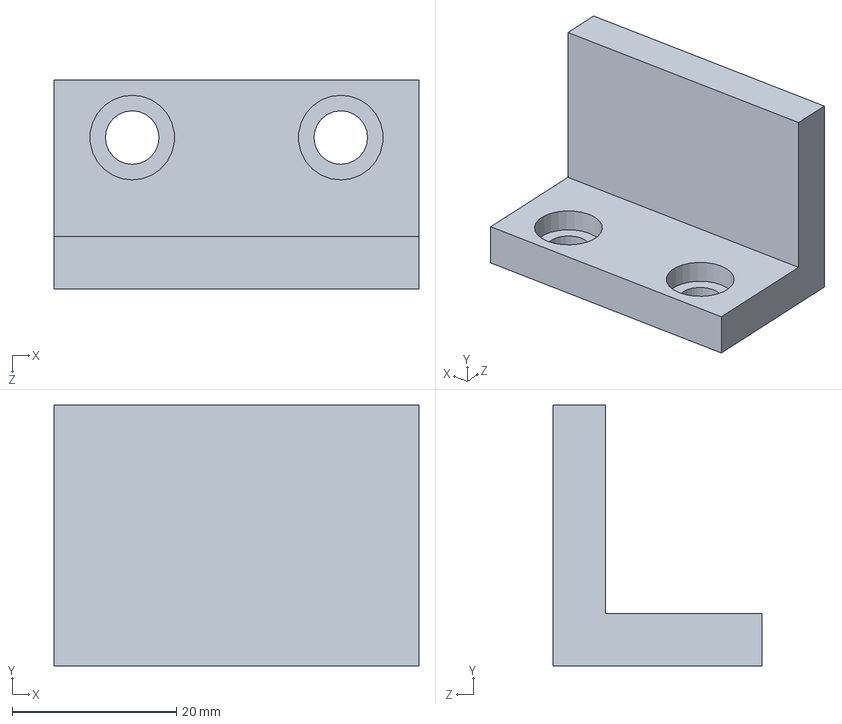
[picture p146: CAD file, 2021-07-24]
Monkey Cage Training/Monkey Cage Extension/Springs/Hook.SLDPRT
44.5 x 31.8 x 25.4 mm
