jamestorrissonwong/NML-CAD/Monkey Chair/Arm Restraints/Extra Rail.SLDPRT

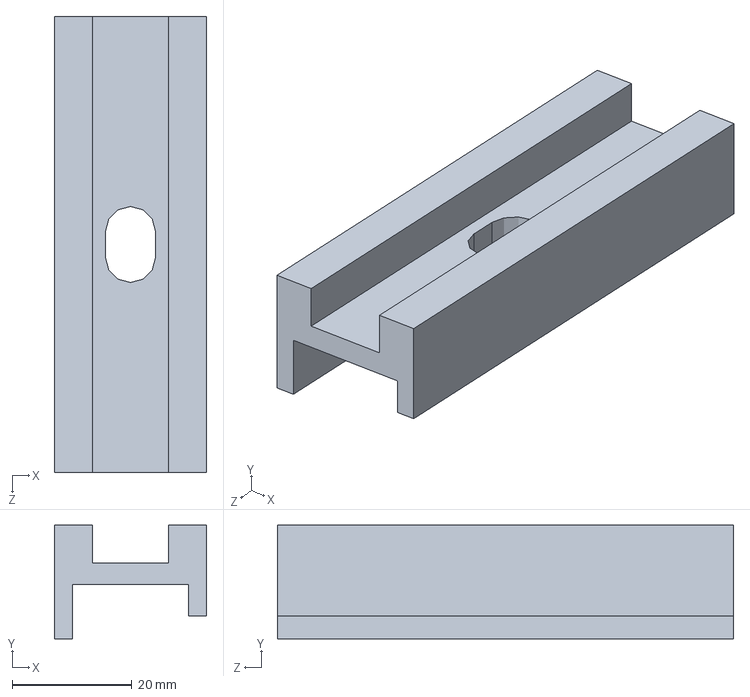
[picture p147: CAD file, 2022-08-11]
Monkey Chair/Arm Restraints/Extra Rail.SLDPRT
25.4 x 19.0 x 76.2 mm
