jamestorrissonwong/NML-CAD/Monkey Chair/Attachment/Side Panel.SLDPRT

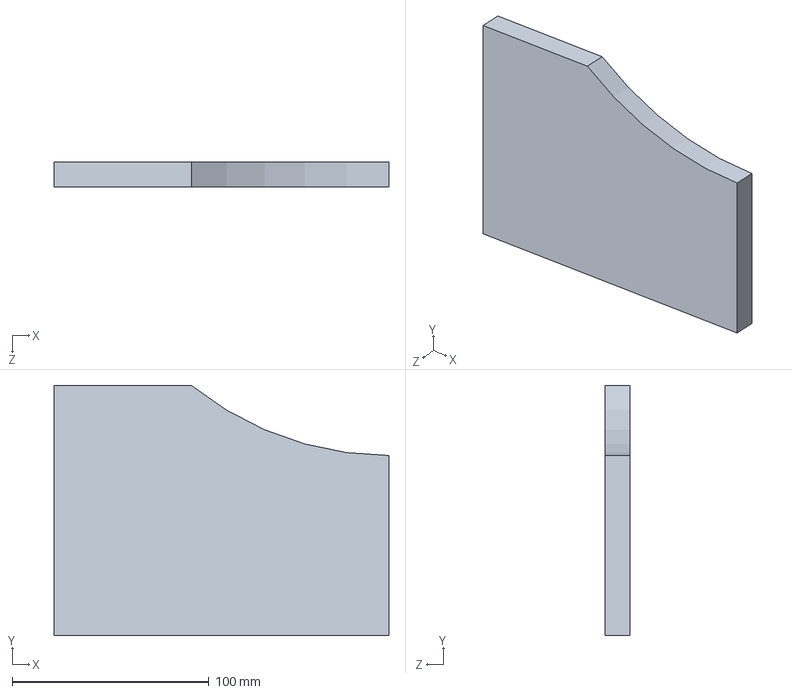
[picture p148: CAD file, 2022-06-04]
Monkey Chair/Attachment/Side Panel.SLDPRT
170.2 x 127.0 x 12.7 mm
