jamestorrissonwong/NML-CAD/Monkey Chair/Neck Plate Adapter.SLDPRT

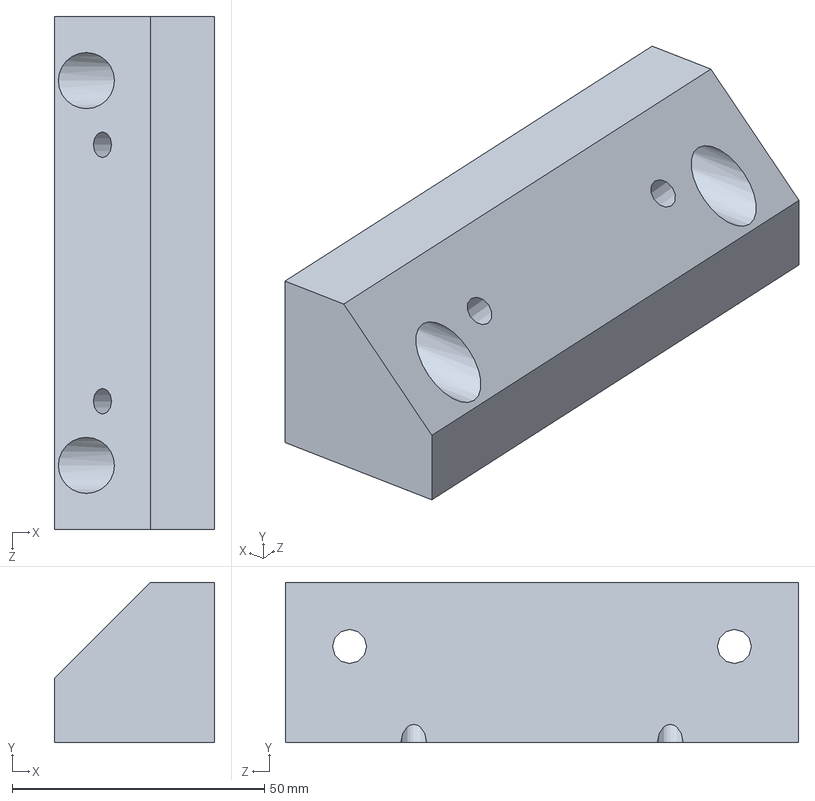
[picture p149: CAD file, 2022-08-11]
Monkey Chair/Neck Plate Adapter.SLDPRT
31.8 x 31.8 x 101.6 mm
