jamestorrissonwong/NML-CAD/Monkey Collars/Large Collar.3mf

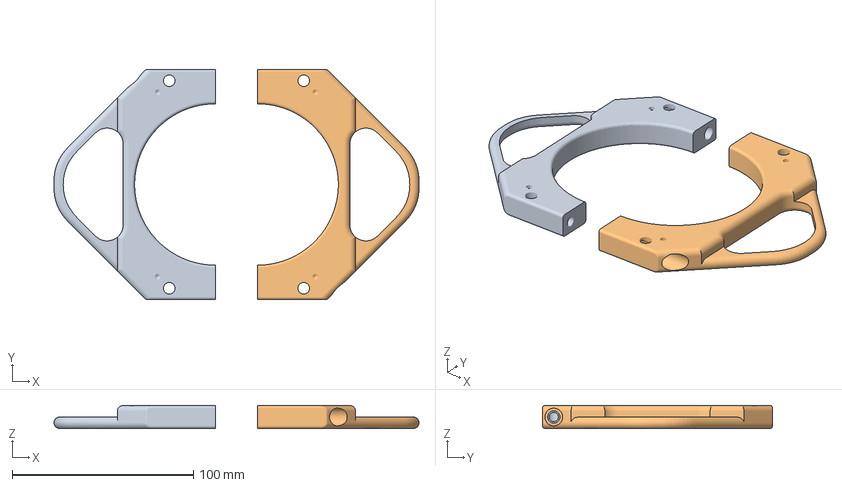
[picture p150: CAD file, 2022-08-11]
Monkey Collars/Large Collar.3mf
201.1 x 127.0 x 12.7 mm
Collar Large Left.STL
Collar Large Right.STL
