jamestorrissonwong/NML-CAD/Monkey Sippers/Monkey Sipper/Hex Rails/Hold.SLDPRT

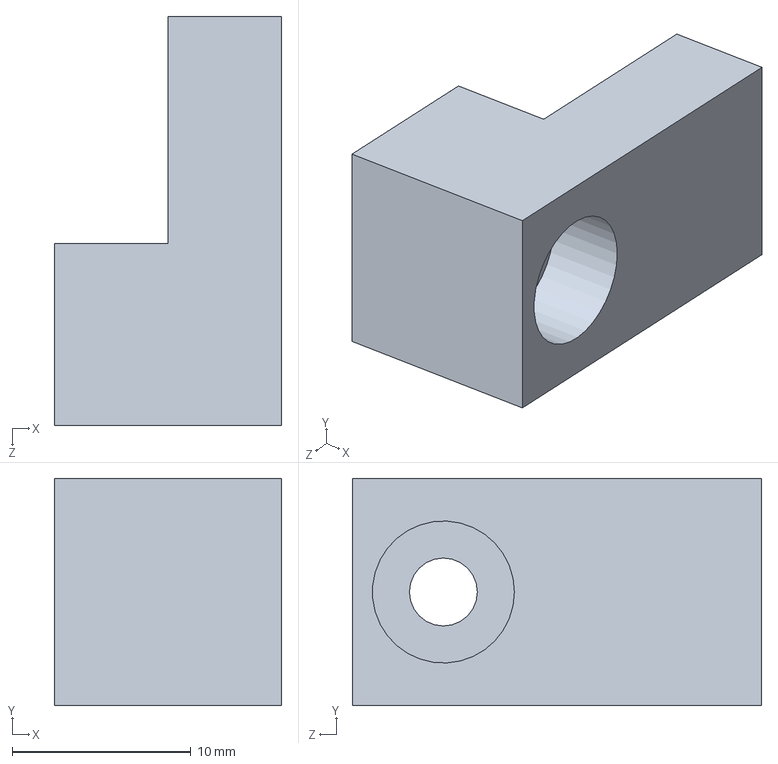
[picture p151: CAD file, 2021-07-24]
Monkey Sippers/Monkey Sipper/Hex Rails/Hold.SLDPRT
12.7 x 12.7 x 22.9 mm
