jamestorrissonwong/NML-CAD/PCBs/Intan Headstage/RHD2164_2x_epoxy_coated.SLDPRT

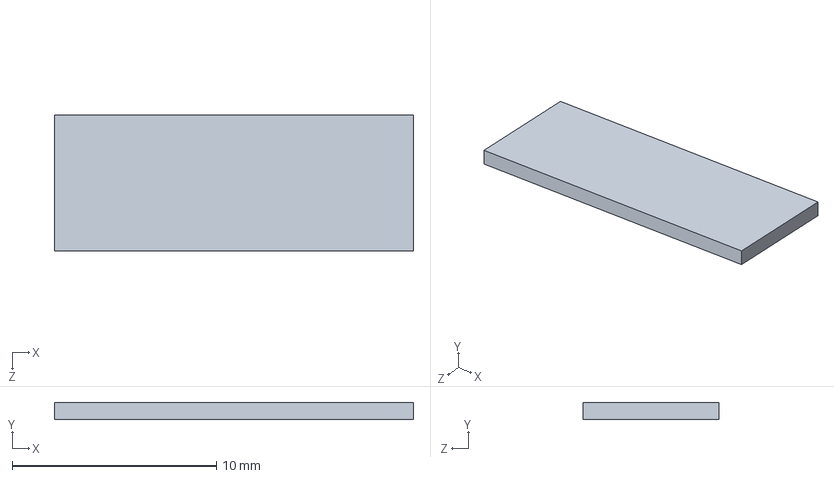
[picture p152: CAD file, 2021-07-24]
PCBs/Intan Headstage/RHD2164_2x_epoxy_coated.SLDPRT
17.6 x 0.851 x 6.68 mm
