jamestorrissonwong/NML-CAD/Manips/Human Manip/Bar Stock/Inner Horizontal.SLDPRT

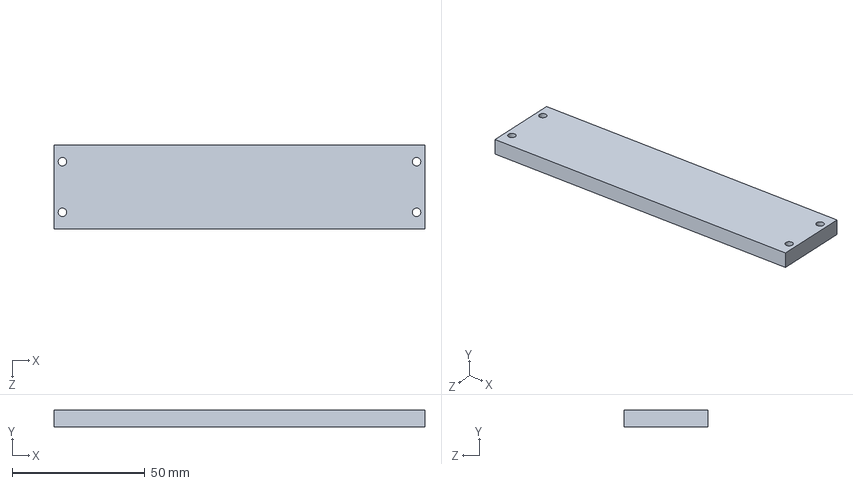
[picture p153: CAD file, 2021-12-19]
Manips/Human Manip/Bar Stock/Inner Horizontal.SLDPRT
139.7 x 6.35 x 31.8 mm
