jamestorrissonwong/NML-CAD/Manips/Human Manip/STLS/Prev STLs/Inner Vertical.STL

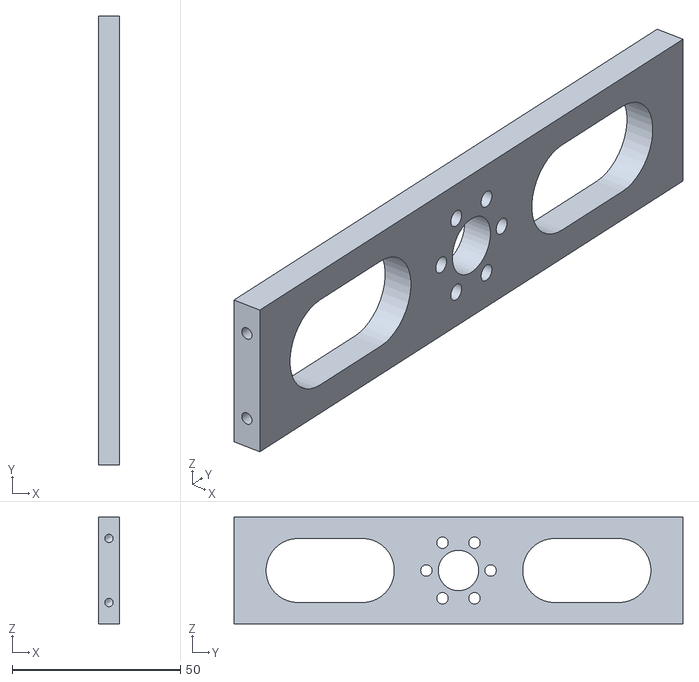
[picture p154: CAD file, 2021-12-19]
Manips/Human Manip/STLS/Prev STLs/Inner Vertical.STL
6.35 x 133.4 x 31.8
