jamestorrissonwong/NML-CAD/Manips/Monkey Manip Duplicate/Outer Ring Horizontal.SLDPRT

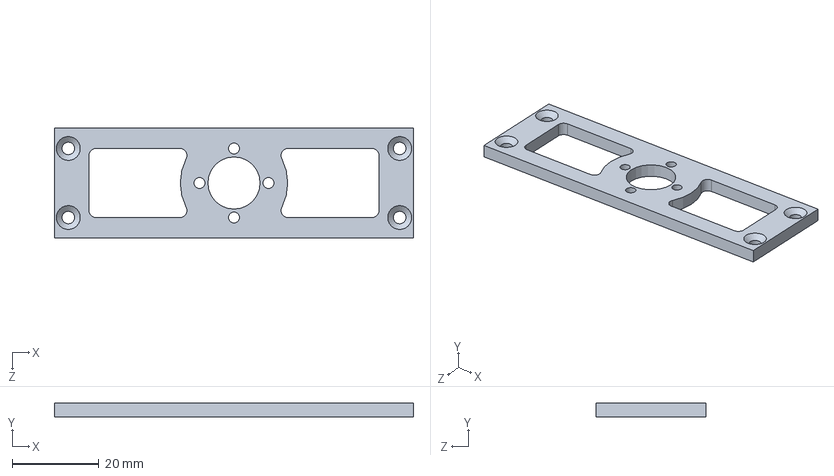
[picture p155: CAD file, 2022-08-11]
Manips/Monkey Manip Duplicate/Outer Ring Horizontal.SLDPRT
82.5 x 3.17 x 25.4 mm
