jamestorrissonwong/NML-CAD/Manips/Monkey Manip Stepper Mod/37d-gearmotor-3d-models/37d-gearmotor-6-10.step

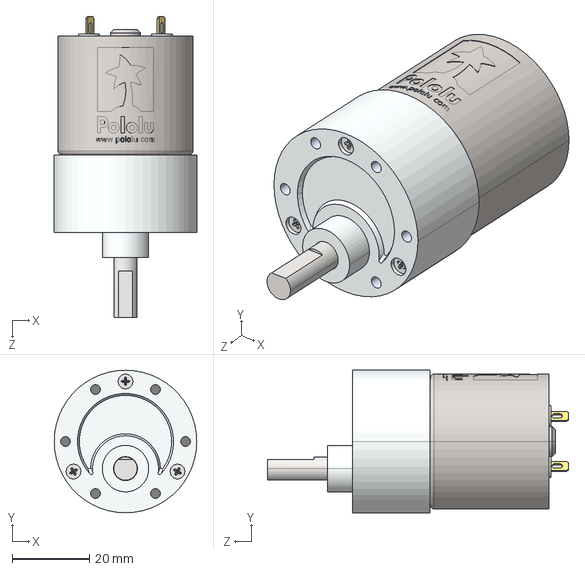
[picture p156: CAD file, 2021-07-24]
Manips/Monkey Manip Stepper Mod/37d-gearmotor-3d-models/37d-gearmotor-6-10.step
36.8 x 36.8 x 77.7 mm
