jamestorrissonwong/NML-CAD/Manips/Monkey Manip/Limiter U22.SLDPRT

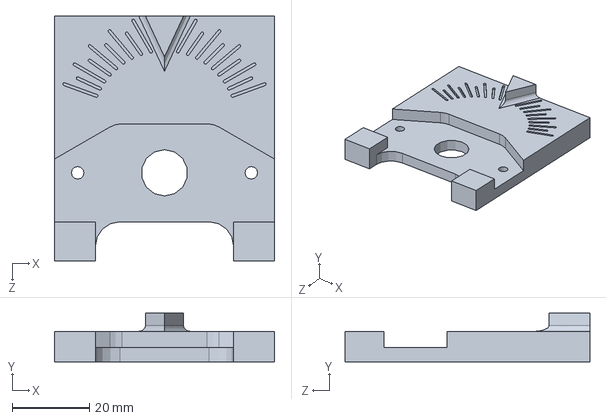
[picture p158: CAD file, 2022-08-11]
Manips/Monkey Manip/Limiter U22.SLDPRT
57.1 x 12.7 x 63.5 mm
