jamestorrissonwong/NML-CAD/Monkey Cage Training/Acrylic ICTS/DXFs for Cutting/Acrylic Back.DXF

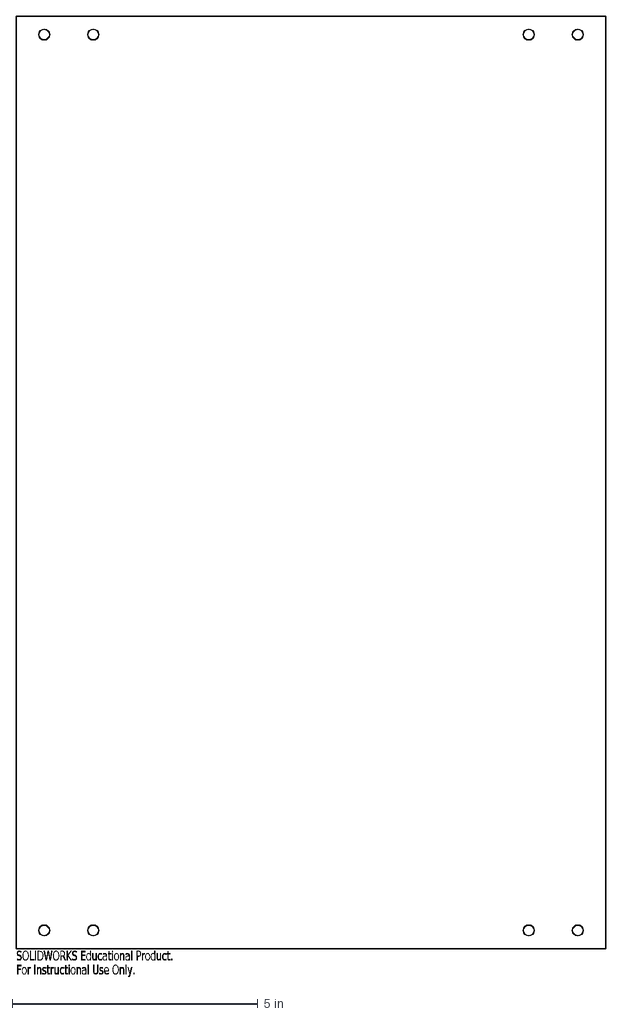
[picture p159: CAD file, 2022-02-23]
Monkey Cage Training/Acrylic ICTS/DXFs for Cutting/Acrylic Back.DXF
SOLIDWORKS Educational Product.
For Instructional Use Only.
