jamestorrissonwong/NML-CAD/Monkey Cage Training/Acrylic ICTS/Thicker/Acrylic.SLDPRT

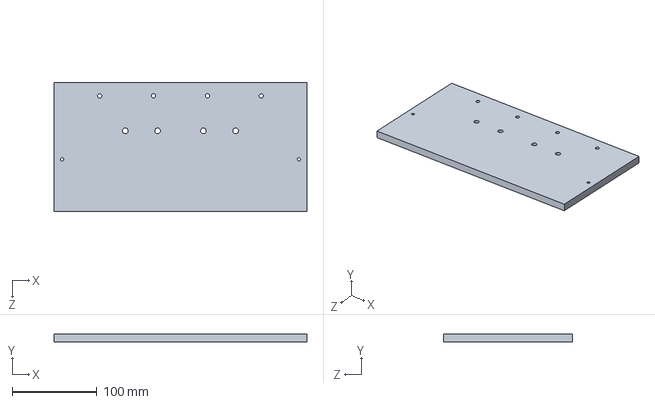
[picture p160: CAD file, 2022-06-04]
Monkey Cage Training/Acrylic ICTS/Thicker/Acrylic.SLDPRT
298.4 x 9.53 x 152.4 mm
