jamestorrissonwong/NML-CAD/Monkey Cage Training/Monkey Cage Extension/cage/front wall.SLDPRT

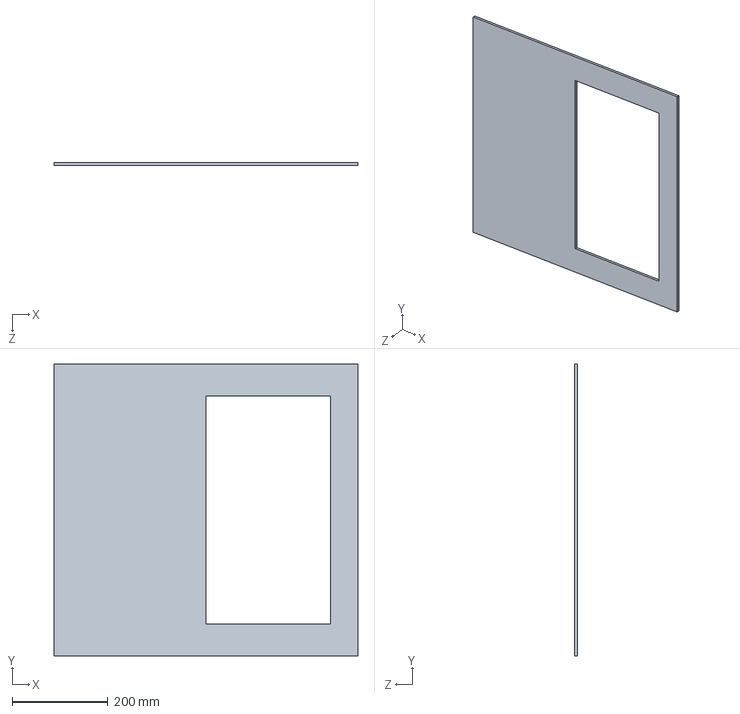
[picture p161: CAD file, 2021-08-06]
Monkey Cage Training/Monkey Cage Extension/cage/front wall.SLDPRT
635.0 x 609.6 x 6.35 mm
