jamestorrissonwong/NML-CAD/Monkey Cage Training/Monkey Cage Extension/HE2-23-x-A.SLDPRT

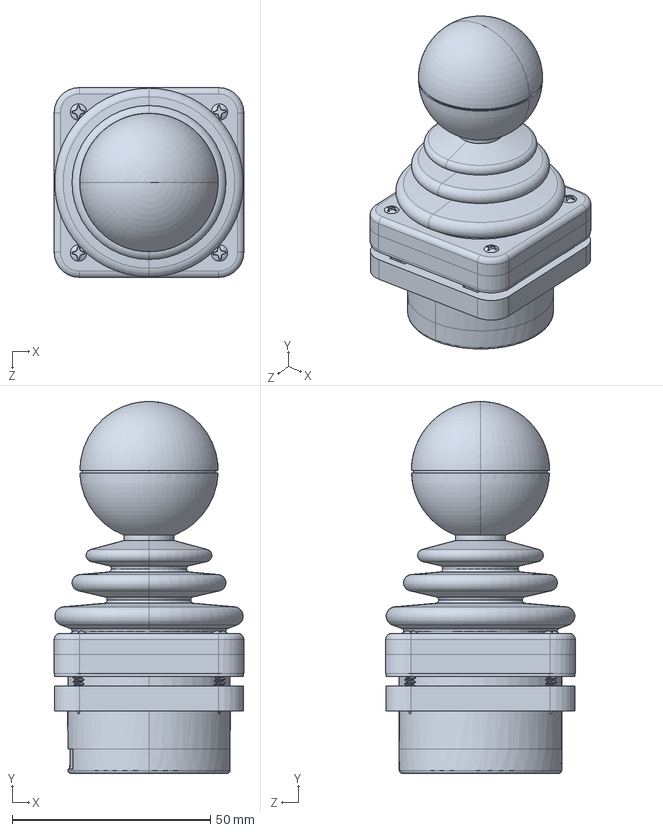
[picture p162: CAD file, 2021-08-06]
Monkey Cage Training/Monkey Cage Extension/HE2-23-x-A.SLDPRT
47.9 x 93.9 x 47.9 mm
