jamestorrissonwong/NML-CAD/Monkey Cage Training/Monkey Cage Extension/raspberry-pi-4-model-b-1.snapshot.3/MxL7704 Universal PMIC, RPi4ModelB.SLDPRT

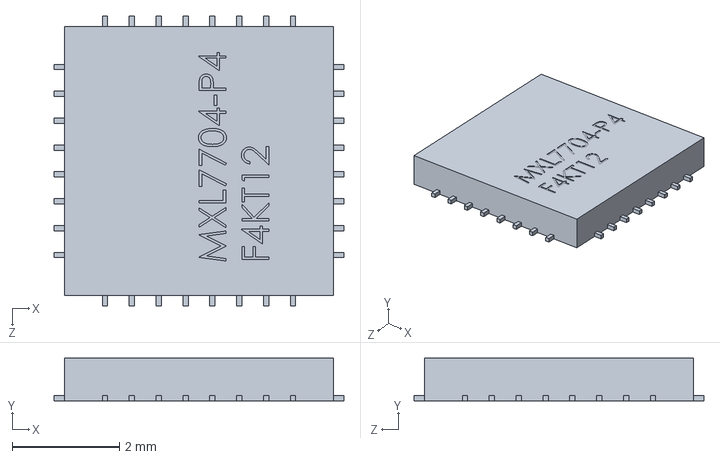
[picture p163: CAD file, 2021-07-24]
Monkey Cage Training/Monkey Cage Extension/raspberry-pi-4-model-b-1.snapshot.3/MxL7704 Universal PMIC, RPi4ModelB.SLDPRT
5.40 x 0.8 x 5.40 mm
