jamestorrissonwong/NML-CAD/Monkey Chair/Attachment/Front Panel.SLDPRT

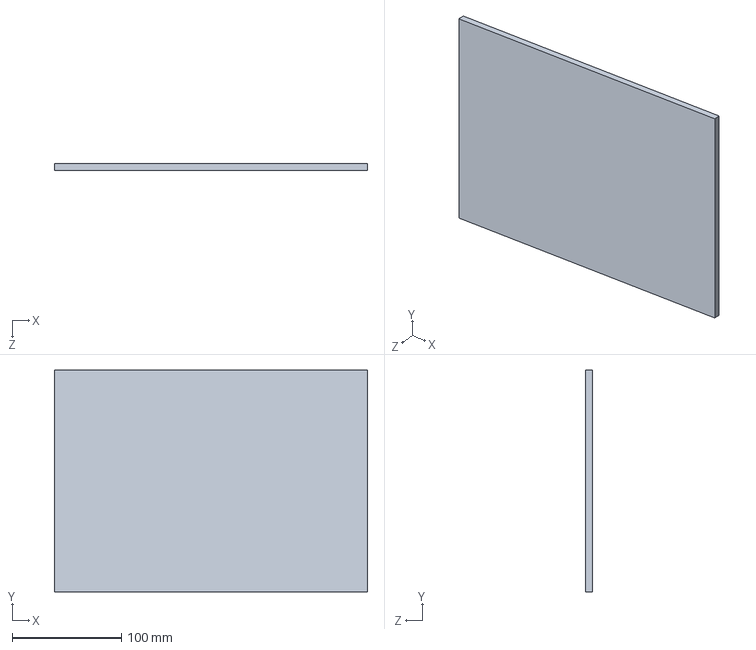
[picture p164: CAD file, 2022-06-04]
Monkey Chair/Attachment/Front Panel.SLDPRT
287.0 x 203.2 x 6.35 mm
