jamestorrissonwong/NML-CAD/Monkey Chair/Slot Plate Adapter.STEP

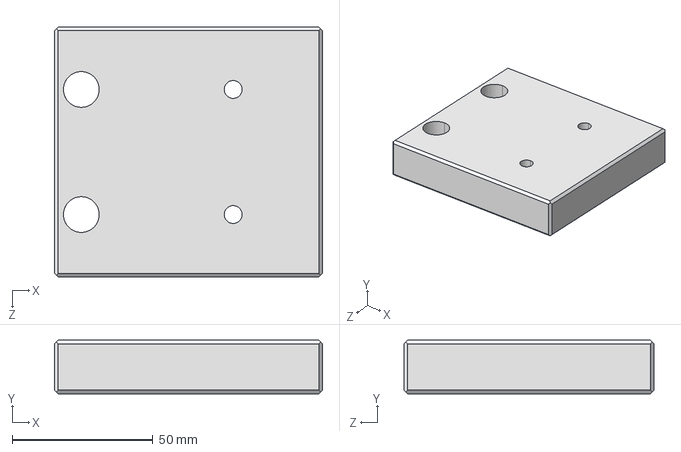
[picture p165: CAD file, 2022-08-11]
Monkey Chair/Slot Plate Adapter.STEP
95.2 x 19.1 x 88.9 mm
