jamestorrissonwong/NML-CAD/Monkey Collars/Collar.SLDPRT

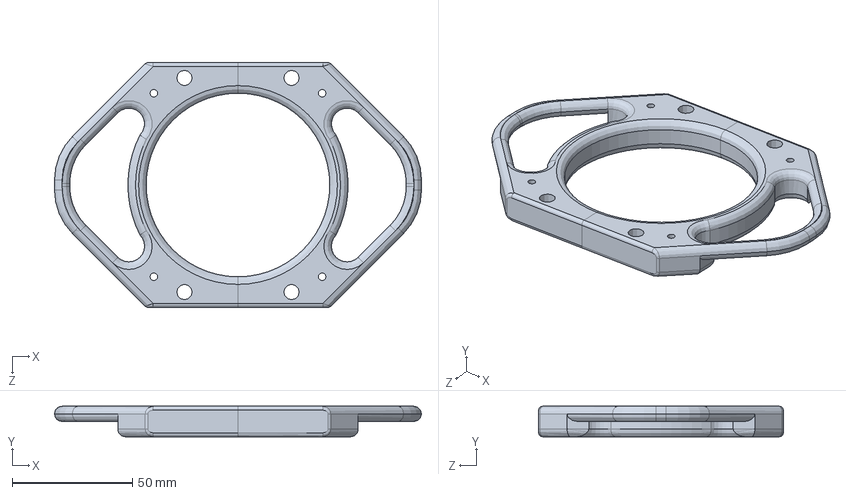
[picture p166: CAD file, 2022-08-11]
Monkey Collars/Collar.SLDPRT
152.4 x 12.7 x 101.6 mm
