jamestorrissonwong/NML-CAD/(list of files, cad)

Other CAD files:
Monkey Cage Training/Monkey Cage Extension/big modular.SLDASM
Monkey Cage Training/Monkey Cage Extension/Test Hook/8020 Assem.SLDASM
Monkey Sippers/NHP-Chair_t-track-linear-positioner.stp
PCBs/Intan Headstage/rhd2000_128_headstage.sldprt
Jordyn/prototype v4.SLDPRT
Manips/Human Manip/STLS/mm motor mount.STL
Monkey Cage Training/Monkey Cage Extension/Test Hook/straw.SLDPRT
Monkey Sippers/NHP-Chair_straw-mount.stp
Bite Guard.dxf
Ernesto/Wrist Force Transducer/SMA-15-200lbf.step.SLDPRT
Jordyn/larger hole v4.STL
Manips/Human Manip/Bar Stock/Outer Vertical.SLDPRT
Manips/Human Manip/STLS/mm encoder mount.STL
Manips/Human Manip/STLS/Prev STLs/Outer Horizontal.STL
Manips/Monkey Manip Stepper Mod/37d-gearmotor-3d-models/37d-gearmotor-100-131-150-encoder.step
Bite Guard-1.SLDPRT
Manips/Human Manip/STLS/Outer Vertical.STL
!archived/realsense/pntcld.ply
Ernesto/Forearm Platform/1604A580_ANY-ANGLE SURFACE-MOUNT POSITIONING HINGE.SLDPRT
Ernesto/Forearm Platform/3136N211_T-SLOTTED FRAMING.SLDPRT
Ernesto/Forearm Platform/3136N213_T-SLOTTED FRAMING.SLDPRT
Ernesto/Forearm Platform/47065T139_ALUMINUM T-SLOTTED FRAMING EXTRUSION.SLDPRT
Ernesto/Forearm Platform/47065T191_ALUMINUM T-SLOTTED FRAMING EXTRUSION.SLDPRT
Ernesto/Forearm Platform/47065T209_ALUMINUM T-SLOTTED FRAMING EXTRUSION.SLDPRT
Ernesto/Forearm Platform/47065T221_ALUMINUM T-SLOTTED FRAMING EXTRUSION.SLDPRT
Ernesto/Forearm Platform/47065T236_ALUMINUM T-SLOTTED FRAMING EXTRUSION.SLDPRT
Ernesto/Forearm Platform/47065T411_ALUMINUM T-SLOTTED FRAMING EXTRUSION.SLDPRT
Ernesto/Forearm Platform/Aluminum Slot.SLDPRT
Ernesto/Forearm Platform/Mounting Plate.SLDPRT
Ernesto/Forearm Platform/Protractor.SLDPRT
Ernesto/Wrist Force Transducer/2313N48_CORNER MACHINE BRACKET.SLDPRT
Ernesto/Wrist Force Transducer/47065T209_ALUMINUM T-SLOTTED FRAMING EXTRUSION.SLDPRT
Ernesto/Wrist Force Transducer/47065T601_T-SLOTTED FRAMING.SLDPRT
Ernesto/Wrist Force Transducer/47065T962_T-SLOTTED FRAMING.SLDPRT
Ernesto/Wrist Force Transducer/60585K320_LINEAR BEARING FOR T-SLOTTED FRAMING.SLDPRT
Ernesto/Wrist Force Transducer/FT Holder v2.SLDPRT
Ernesto/Wrist Force Transducer/Plate.SLDPRT
Ernesto/Wrist Suspension/47065T144_T-Slotted Framing.SLDPRT
Ernesto/Wrist Suspension/47065T149_T-Slotted Framing.SLDPRT
Ernesto/Wrist Suspension/47065T209_ALUMINUM T-SLOTTED FRAMING EXTRUSION.SLDPRT
Ernesto/Wrist Suspension/47065T236_ALUMINUM T-SLOTTED FRAMING EXTRUSION.SLDPRT
Ernesto/Wrist Suspension/47065T652_T-SLOTTED FRAMING.SLDPRT
Ernesto/Wrist Suspension/47065T845_ALUMINUM T-SLOTTED FRAMING EXTRUSION.SLDPRT
Ernesto/Wrist Suspension/47065T962_T-Slotted Framing.SLDPRT
Ernesto/Wrist Suspension/60585K320_LINEAR BEARING FOR T-SLOTTED FRAMING.SLDPRT
Ernesto/Wrist Suspension/92141A029_TYPE 18-8 STAINLESS STEEL FLAT WASHER.SLDPRT
Ernesto/Wrist Suspension/Polycarb.SLDPRT
Ernesto/Wrist Suspension/Square Plate Holes.SLDDRW
Ernesto/Wrist Suspension/Strap Plate.SLDPRT
Ernesto/Wrist Suspension/WSA v2.SLDASM
Fridge Lock and Mount/11125A110_CAM LOCK.SLDPRT
Fridge Lock and Mount/1183A110_PADLOCKABLE EYE.SLDPRT
Fridge Lock and Mount/1612A210_CONCEALED MORTISE-MOUNT CABINET HINGE.SLDPRT
Fridge Lock and Mount/3076T340_TIE-DOWN RING.SLDPRT
Fridge Lock and Mount/3136N157_T-Slotted Framing.SLDPRT
Fridge Lock and Mount/47065T153_ALUMINUM T-SLOTTED FRAMING EXTRUSION.SLDPRT
Fridge Lock and Mount/47065T155_ALUMINUM T-SLOTTED FRAMING EXTRUSION.SLDPRT
Fridge Lock and Mount/47065T161_T-Slotted Framing.SLDPRT
Fridge Lock and Mount/47065T209_ALUMINUM T-SLOTTED FRAMING EXTRUSION.SLDPRT
Fridge Lock and Mount/47065T287_T-Slotted Framing.SLDPRT
Fridge Lock and Mount/47065T321_T-SLOTTED FRAMING.SLDPRT
Fridge Lock and Mount/47065T343_T-Slotted Framing.SLDPRT
Fridge Lock and Mount/47065T901_ALUMINUM T-SLOTTED FRAMING EXTRUSION.SLDPRT
Fridge Lock and Mount/8310T130_ADHESIVE-MOUNT TIE-DOWN RING.SLDPRT
Fridge Lock and Mount/8982K248_Multipurpose 6061 Aluminum 90 Degree Angle.SLDPRT
Fridge Lock and Mount/8982K601_Multipurpose 6061 Aluminum 90 Degree Angle.SLDPRT
Fridge Lock and Mount/8982K602_Multipurpose 6061 Aluminum 90 Degree Angle.SLDPRT
Fridge Lock and Mount/91355A081_FLANGED BUTTON-HEAD SOCKET CAP SCREW.SLDPRT
Fridge Lock and Mount/Fridge.SLDPRT
Fridge Lock and Mount/Lock Bar.SLDPRT
Fridge Lock and Mount/flat surface.SLDPRT
Jordyn/3dprint-v2.SLDPRT
Jordyn/3dprint-v3.SLDPRT
Jordyn/3dprint-v3.STL
Jordyn/3dprint-v4.STL
Jordyn/3dprint.SLDPRT
Jordyn/3dprint.STL
Jordyn/8419K62_TURNBUCKLE-STYLE CONNECTING ROD.SLDPRT
Jordyn/9056K635_MULTIPURPOSE 6061 ALUMINUM ROUND TUBE.SLDPRT
Jordyn/91390A601_ALLOY STEEL CUP-POINT SET SCREW.SLDPRT
Jordyn/92015A091_18-8 STAINLESS STEEL CUP-POINT SET SCREW.SLDPRT
Jordyn/92095A452_Button Head Hex Drive Screw.SLDPRT
Jordyn/92949A599_18-8 SS BUTTON HEAD HEX DRIVE SCREW.SLDPRT
Jordyn/93285A009_CONFORMABLE SOFT NYLON-TIP SET SCREW.SLDPRT
Jordyn/94180A307_HEAT-SET INSERTS FOR PLASTICS.SLDPRT
Jordyn/prototype assem v2.SLDASM
Jordyn/prototype top.SLDPRT
Jordyn/prototype v2.SLDPRT
Jordyn/prototype v2.STL
Jordyn/prototype v3-5.STL
Jordyn/prototype v3.SLDPRT
Jordyn/prototype v3.STL
Jordyn/prototype v4.STL
Jordyn/prototype.SLDPRT
Jordyn/prototype.STL
Jordyn/this better be it v3.STL
Manips/Human Manip/1277N714_CORROSION-RESISTANT TIMING BELT PULLEY.SLDPRT
Manips/Human Manip/1293N6_SELF-ALIGNING FLANGED BALL BEARING.SLDPRT
Manips/Human Manip/3693N160_ HIGH-STRENGTH HTD TIMING BELT IDLER PULLEY.SLDPRT
Manips/Human Manip/4634T361_Multipurpose 6061 Aluminum.SLDPRT
Manips/Human Manip/5033N129_Linear Motion Shaft.SLDPRT
Manips/Human Manip/5395T211_SET SCREW RIGID SHAFT COUPLING.SLDPRT
Manips/Human Manip/57155K621_STAINLESS STEEL BALL BEARING.SLDPRT
Manips/Human Manip/57155K626_STAINLESS STEEL BALL BEARING.SLDPRT
Manips/Human Manip/8975K663_MULTIPURPOSE 6061 ALUMINUM.SLDPRT
Manips/Human Manip/8975K832_MULTIPURPOSE 6061 ALUMINUM.SLDPRT
Manips/Human Manip/8975K863_MULTIPURPOSE 6061 ALUMINUM.SLDPRT
Manips/Human Manip/9008K761_MULTIPURPOSE 6061 ALUMINUM.SLDPRT
Manips/Human Manip/90576A103_Medium-Strength Steel Nylon-Insert Locknut.SLDPRT
Manips/Human Manip/92125A135_18-8 Stainless Steel Hex Drive Flat Head Screw.SLDPRT
Manips/Human Manip/92125A192_18-8 Stainless Steel Hex Drive Flat Head Screw.SLDPRT
Manips/Human Manip/9246K13_MULTIPURPOSE 6061 ALUMINUM.SLDPRT
Manips/Human Manip/92981A042_Alloy Steel Shoulder Screws.SLDPRT
Manips/Human Manip/92981A778_Alloy Steel Shoulder Screws.SLDPRT
Manips/Human Manip/94669A063_Aluminum Unthreaded Spacer.SLDPRT
Manips/Human Manip/Bar Stock/Inner Vertical.SLDPRT
Manips/Human Manip/Bar Stock/Outer Horizontal Bar.SLDPRT
Manips/Human Manip/Bar Stock/Outer Horizontal.SLDPRT
Manips/Human Manip/Fake Screw.SLDPRT
Manips/Human Manip/Large Manip.SLDDRW
Manips/Human Manip/STLS/fixed bar.STL
Manips/Human Manip/STLS/motor adapter.STL
Manips/Human Manip/STLS/pololu-universal-aluminum-mounting-hub-for-8mm-shaft-m3-holes.STL
Manips/Human Manip/Tube Stock/6546K815_MULTIPURPOSE 6061 ALUMINUM RECTANGULAR TUBE.SLDPRT
Manips/Human Manip/Tube Stock/6546K845_MULTIPURPOSE 6061 ALUMINUM RECTANGULAR TUBE.SLDPRT
Manips/Human Manip/Y mount.SLDPRT
Manips/Human Manip/maxon.SLDPRT
Manips/Human Manip/pololu-universal-aluminum-mounting-hub-for-8mm-shaft-m3-holes.step
Manips/Human Manip/pololu-universal-aluminum-mounting-hub-for-8mm-shaft-m3-holes.step.SLDPRT
Manips/Monkey Manip Duplicate/5537T501_T-Slotted Framing.SLDPRT
Manips/Monkey Manip Duplicate/57155K622_Stainless Steel Ball Bearing.SLDPRT
Manips/Monkey Manip Duplicate/91294A014_Black-Oxide Alloy Steel Hex Drive Flat Head Screw.SLDPRT
Manips/Monkey Manip Duplicate/91294A211_Black-Oxide Alloy Steel Hex Drive Flat Head Screw.SLDPRT
Manips/Monkey Manip Duplicate/91294A213_Black-Oxide Alloy Steel Hex Drive Flat Head Screw.SLDPRT
Manips/Monkey Manip Duplicate/92125A127_18-8 Stainless Steel Hex Drive Flat Head Screw.SLDPRT
Manips/Monkey Manip Duplicate/Drawings and CAM/Inner Ring Horizontal.SLDDRW
Manips/Monkey Manip Duplicate/Drawings and CAM/Outer Ring Vertical.SLDDRW
Manips/Monkey Manip Duplicate/Flange Shaft Coupling.SLDPRT
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
