jamestorrissonwong/NML-CAD/Manips/Monkey Manip/Machined Parts Drawings/Angle Stop v1.PDF

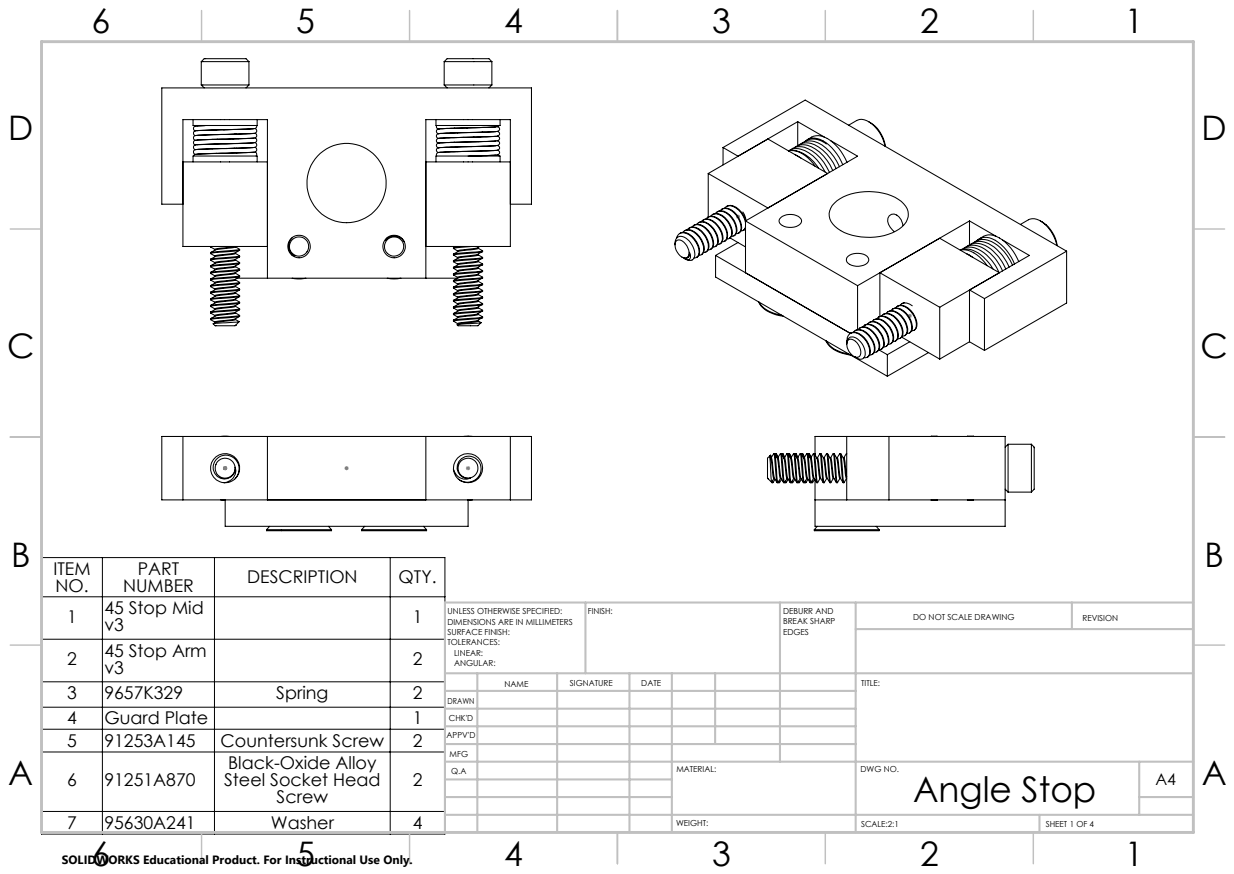
[picture p167: page 1]
FINISH:; DEBURR AND; BREAK SHARP; DO NOT SCALE DRAWING; REVISION

ITEM NO. | PART NUMBER | DESCRIPTION | QTY.
1 | 45 Stop Mid v3 | | 1
2 | 45 Stop Arm v3 | | 2
3 | 9657K329 | Spring | 2
4 | Guard Plate | | 1 | CHK'D
5 | 91253A145 | Countersunk Screw | 2 | APPV'D
6 | 91251A870 | Black-Oxide Alloy Steel Socket Head Screw | 2

UNLESS OTHERWISE SPECIFIED:
DIMENSIONS ARE IN MILLIMETERS
SURFACE FINISH:
TOLERANCES:
LINEAR:
ANGULAR:

NAME | SIGNATURE | DATE | | | | TITLE:

DRAWN

MFG
Q.A | | | | MATERIAL: | DWG NO. Angle Stop | A4

7 | 95630A241 | Washer | 4 | WEIGHT: | SCALE:2:1 | SHEET 1 OF 4

SOLIDWORKS Educational Product. For Instructional Use Only.

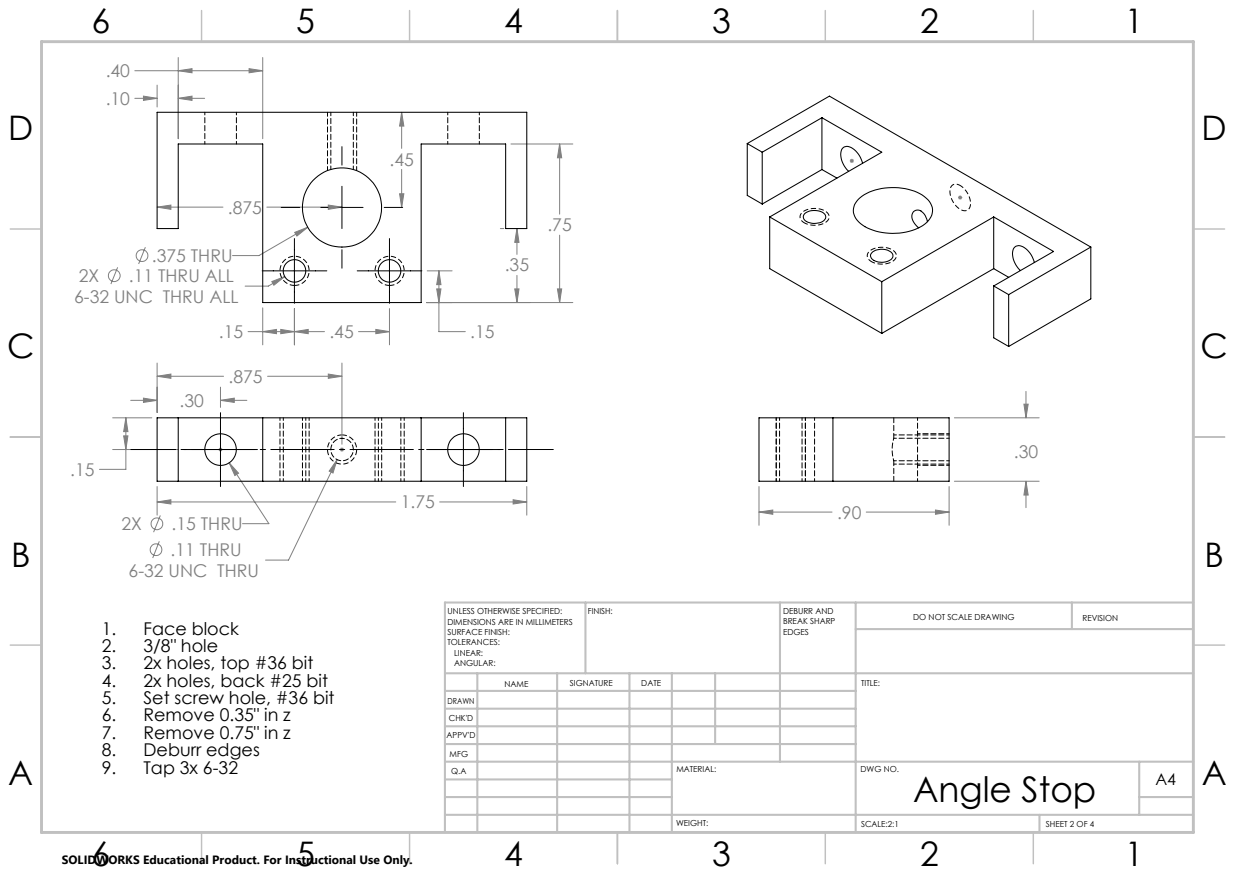
[picture p168: page 2]
.15 THRU; .11 THRU 6-32 UNC THRU; .375 THRU; .11 THRU ALL; 9. Tap 3x 6-32; FINISH:; DEBURR AND; BREAK SHARP; DO NOT SCALE DRAWING; REVISION

6-32 UNC THRU ALL

1. Face block
2. 3/8" hole
3. 2x holes, top #36 bit
4. 2x holes, back #25 bit
5. Set screw hole, #36 bit
6. Remove 0.35" in z
7. Remove 0.75" in z
8. Deburr edges

UNLESS OTHERWISE SPECIFIED:
DIMENSIONS ARE IN MILLIMETERS
SURFACE FINISH:
TOLERANCES:
LINEAR:
ANGULAR:

NAME | SIGNATURE | DATE | | | | TITLE:

DRAWN
CHK'D
APPV'D
MFG
Q.A | | | | MATERIAL: | DWG NO. Angle Stop | A4

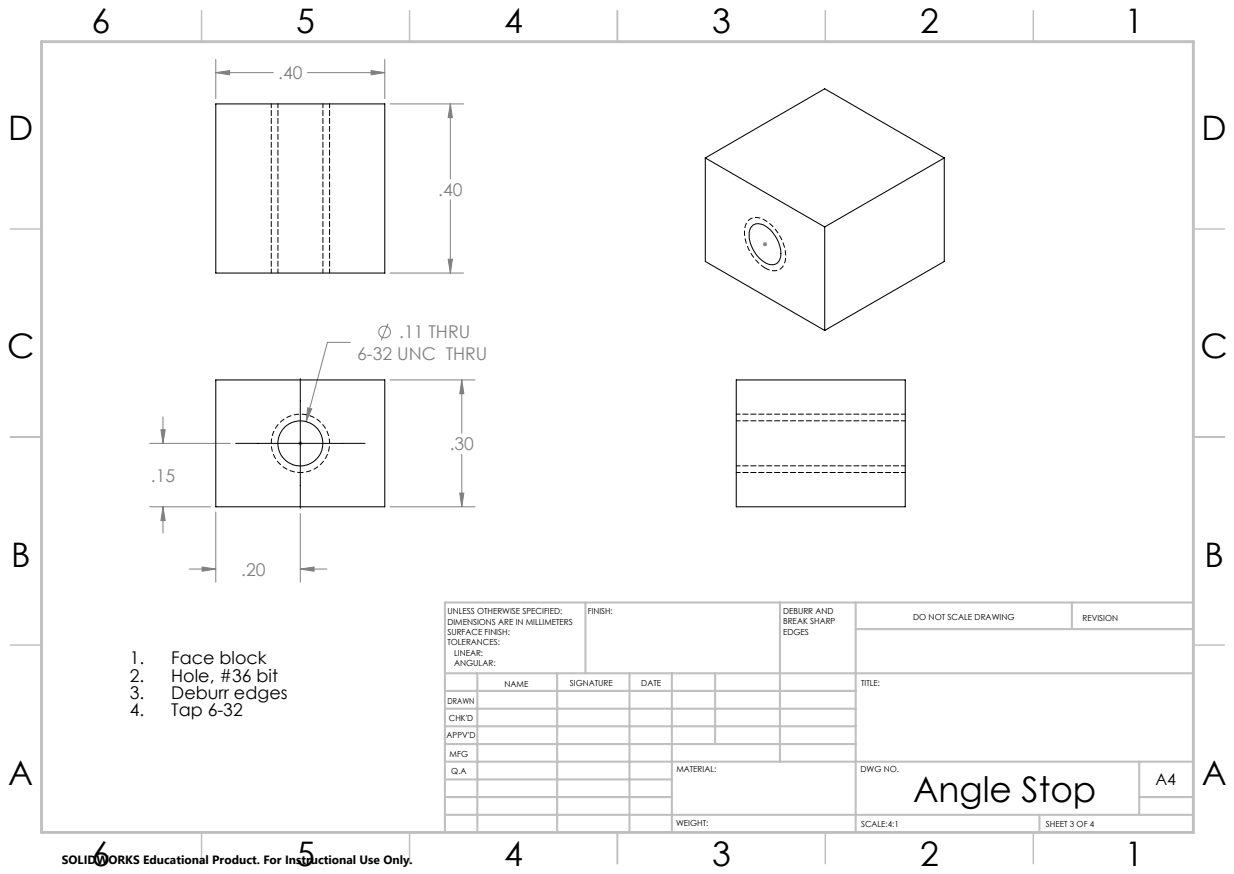
[picture p169: page 3]
.11 THRU 6-32 UNC THRU; 1. Face block 2. Hole, #36 bit 3. Deburr edges 4. Tap 6-32; FINISH:; DEBURR AND; BREAK SHARP; DO NOT SCALE DRAWING; REVISION; SCALE:4:1; SHEET 3 OF 4

UNLESS OTHERWISE SPECIFIED:
DIMENSIONS ARE IN MILLIMETERS
SURFACE FINISH:
TOLERANCES:
LINEAR:
ANGULAR:

NAME | SIGNATURE | DATE | | | | TITLE:

DRAWN
CHK'D
APPV'D
MFG
Q.A | | | | MATERIAL: | DWG NO. Angle Stop | A4

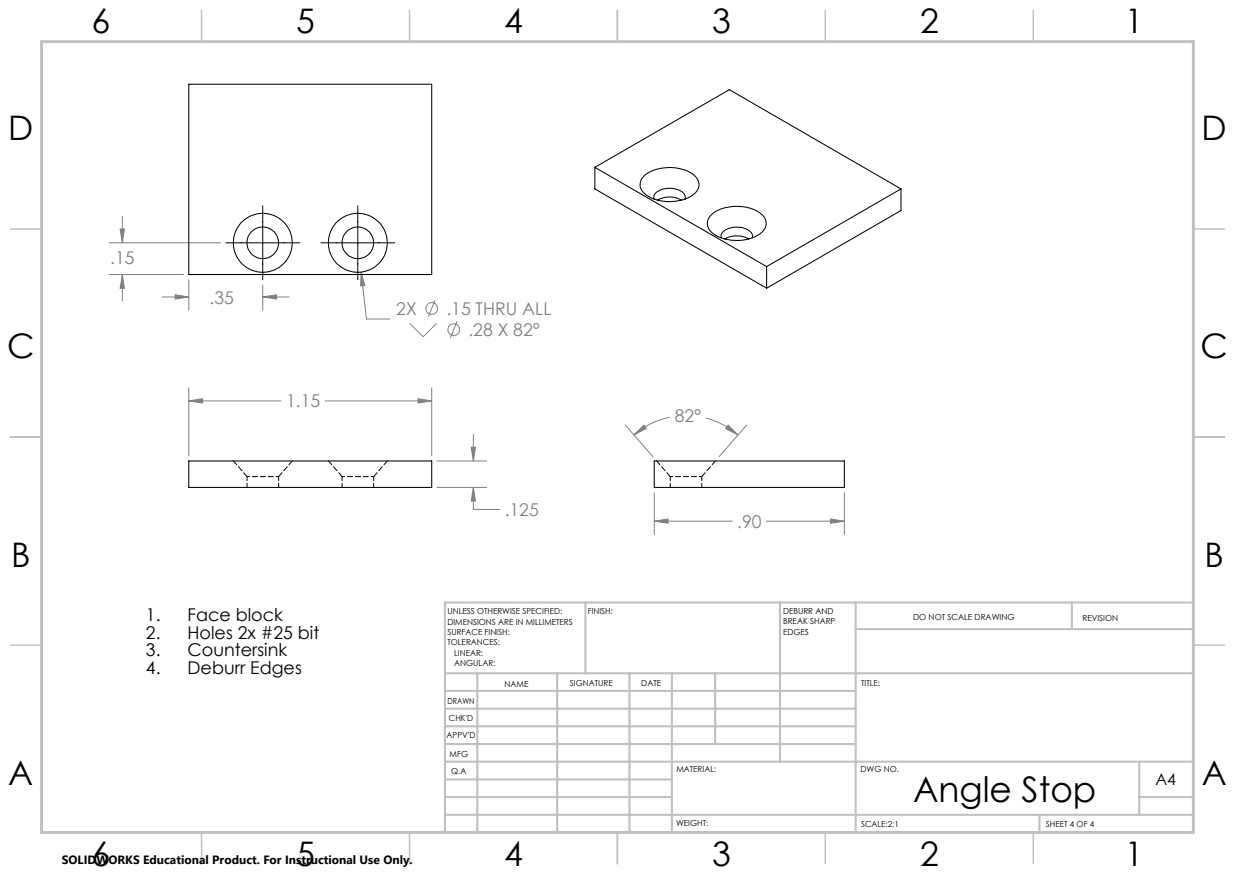
[picture p170: page 4]
.15 THRU ALL; 1. Face block 2. Holes 2x #25 bit 3. Countersink 4. Deburr Edges; FINISH:; DEBURR AND; BREAK SHARP; DO NOT SCALE DRAWING; REVISION

UNLESS OTHERWISE SPECIFIED:
DIMENSIONS ARE IN MILLIMETERS
SURFACE FINISH:
TOLERANCES:
LINEAR:
ANGULAR:

NAME | SIGNATURE | DATE | | | | TITLE:

DRAWN
CHK'D
APPV'D
MFG
Q.A | | | | MATERIAL: | DWG NO. Angle Stop | A4
