jamestorrissonwong/NML-CAD/Monkey Chair/Drawings and CAM/Slot Plate Adapter.pdf

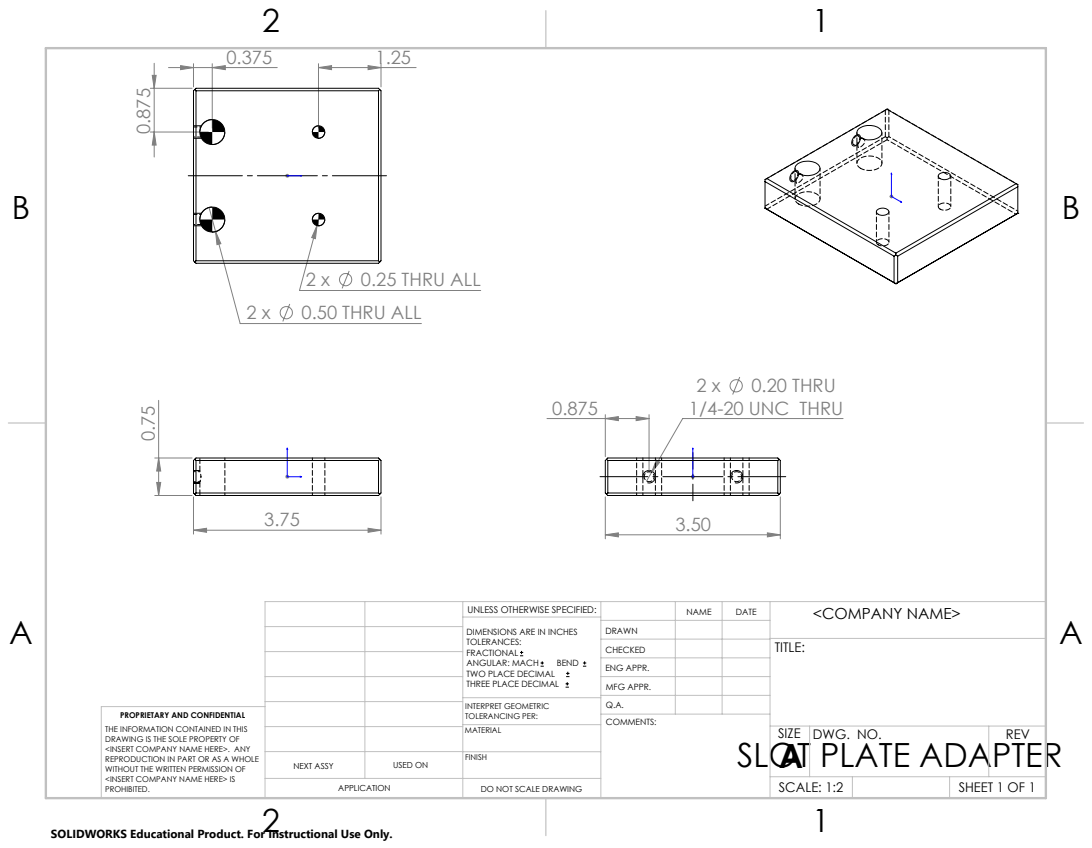
[picture p171: page 1]
0.50 THRU ALL; 0.25 THRU ALL; 0.20 THRU; 1/4-20 UNC THRU

UNLESS OTHERWISE SPECIFIED: | | NAME | DATE | <COMPANY NAME>
DIMENSIONS ARE IN INCHES TOLERANCES: FRACTIONAL ANGULAR: MACH BEND TWO PLACE DECIMAL THREE PLACE DECIMAL | DRAWN

CHECKED | | | TITLE:

ENG APPR.
MFG APPR.

INTERPRET GEOMETRIC TOLERANCING PER: | Q.A.

PROPRIETARY AND CONFIDENTIAL
THE INFORMATION CONTAINED IN THIS
DRAWING IS THE SOLE PROPERTY OF
<INSERT COMPANY NAME HERE>. ANY
REPRODUCTION IN PART OR AS A WHOLE
WITHOUT THE WRITTEN PERMISSION OF
<INSERT COMPANY NAME HERE> IS
PROHIBITED.

USED ON | MATERIAL | | SIZE A | DWG. NO. | REV

COMMENTS:
SLOT PLATE ADAPTER

NEXT ASSY | | FINISH

APPLICATION | DO NOT SCALE DRAWING | | SCALE: 1:2 | | SHEET 1 OF 1

SOLIDWORKS Educational Product. For Instructional Use Only.
