jamestorrissonwong/NML-CAD/Monkey Collars/Drawings and CAM/Collar.pdf

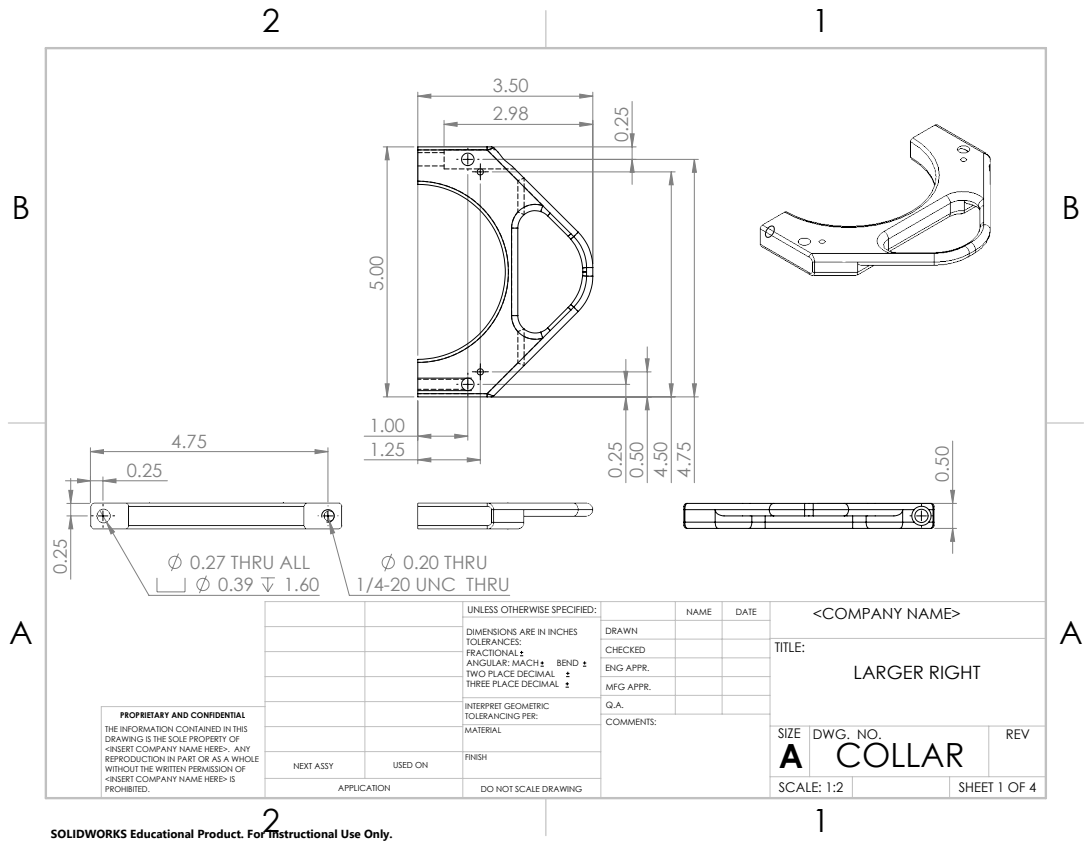
[picture p172: page 1]
0.20 THRU 1/4-20 UNC THRU; 0.27 THRU ALL 0.39 1.60

UNLESS OTHERWISE SPECIFIED: | | NAME | DATE | <COMPANY NAME>
DIMENSIONS ARE IN INCHES TOLERANCES: FRACTIONAL ANGULAR: MACH BEND TWO PLACE DECIMAL THREE PLACE DECIMAL | DRAWN

CHECKED | | | TITLE: LARGER RIGHT

ENG APPR.
MFG APPR.

INTERPRET GEOMETRIC TOLERANCING PER: | Q.A.

PROPRIETARY AND CONFIDENTIAL
THE INFORMATION CONTAINED IN THIS
DRAWING IS THE SOLE PROPERTY OF
<INSERT COMPANY NAME HERE>. ANY
REPRODUCTION IN PART OR AS A WHOLE
WITHOUT THE WRITTEN PERMISSION OF
<INSERT COMPANY NAME HERE> IS
PROHIBITED.

USED ON | MATERIAL | | SIZE A | DWG. NO. COLLAR | REV

NEXT ASSY | | FINISH

APPLICATION | DO NOT SCALE DRAWING | | SCALE: 1:2 | | SHEET 1 OF 4

SOLIDWORKS Educational Product. For Instructional Use Only.

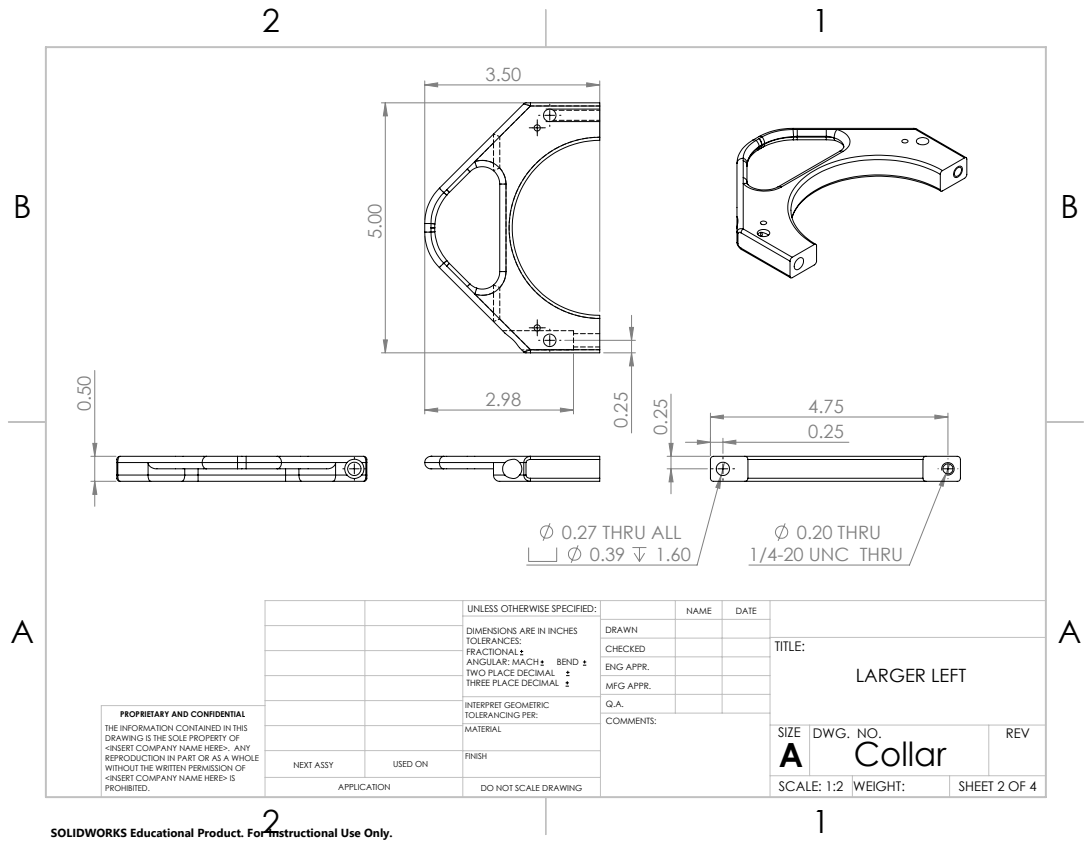
[picture p173: page 2]
0.27 THRU ALL 0.39 1.60; 0.20 THRU 1/4-20 UNC THRU

UNLESS OTHERWISE SPECIFIED: | | NAME | DATE
DIMENSIONS ARE IN INCHES TOLERANCES: FRACTIONAL ANGULAR: MACH BEND TWO PLACE DECIMAL THREE PLACE DECIMAL | DRAWN

CHECKED | | | TITLE: LARGER LEFT

ENG APPR.
MFG APPR.

INTERPRET GEOMETRIC TOLERANCING PER: | Q.A.
MATERIAL | | SIZE A | DWG. NO. Collar | REV

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

NEXT ASSY | USED ON | FINISH

DO NOT SCALE DRAWING | | SCALE: 1:2 | WEIGHT:

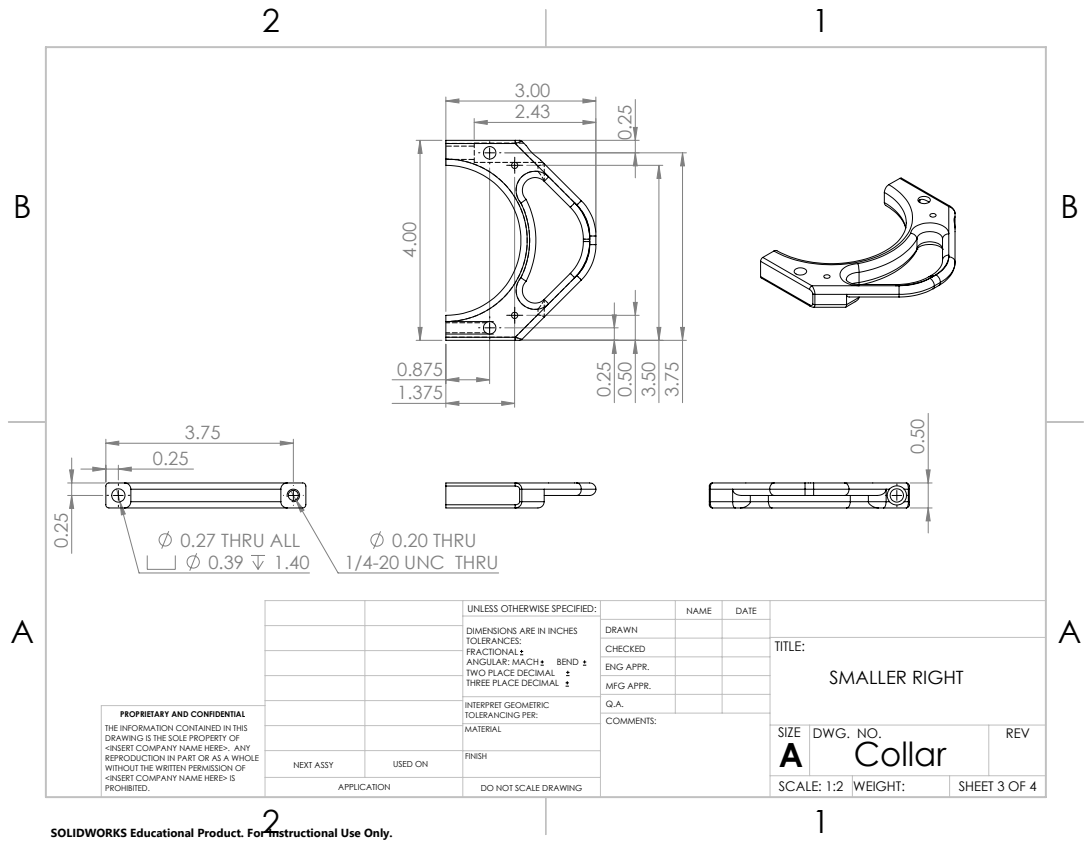
[picture p174: page 3]
0.27 THRU ALL 0.39 1.40; 0.20 THRU 1/4-20 UNC THRU

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

CHECKED | | | TITLE: SMALLER RIGHT

ENG APPR.
MFG APPR.

INTERPRET GEOMETRIC TOLERANCING PER: | Q.A.
MATERIAL | | SIZE A | DWG. NO. Collar | REV

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

NEXT ASSY | USED ON | FINISH

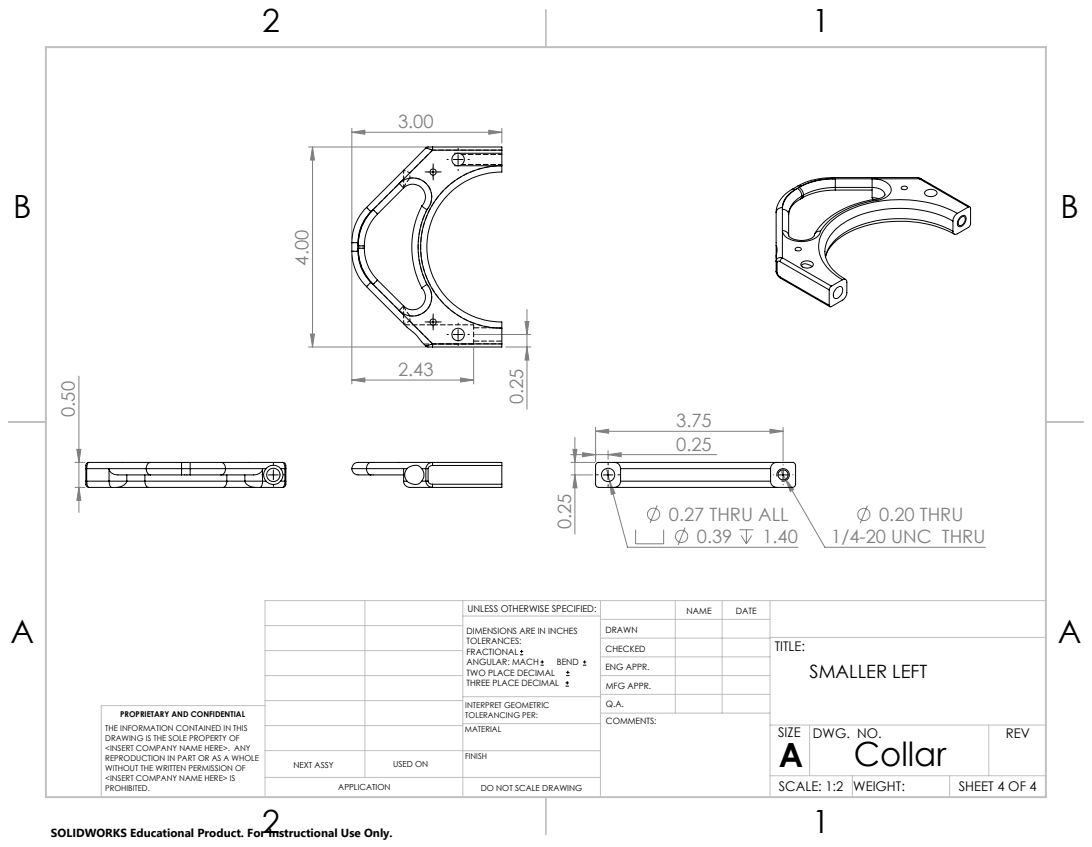
[picture p175: page 4]
0.27 THRU ALL 0.39 1.40; 0.20 THRU 1/4-20 UNC THRU

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

CHECKED | | | TITLE: SMALLER LEFT

ENG APPR.
MFG APPR.

INTERPRET GEOMETRIC TOLERANCING PER: | Q.A.
MATERIAL | | SIZE A | DWG. NO. Collar | REV

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

NEXT ASSY | USED ON | FINISH
