jamestorrissonwong/NML-CAD/Monkey Sippers/Sipper Fixturing Track/Sipper.pdf

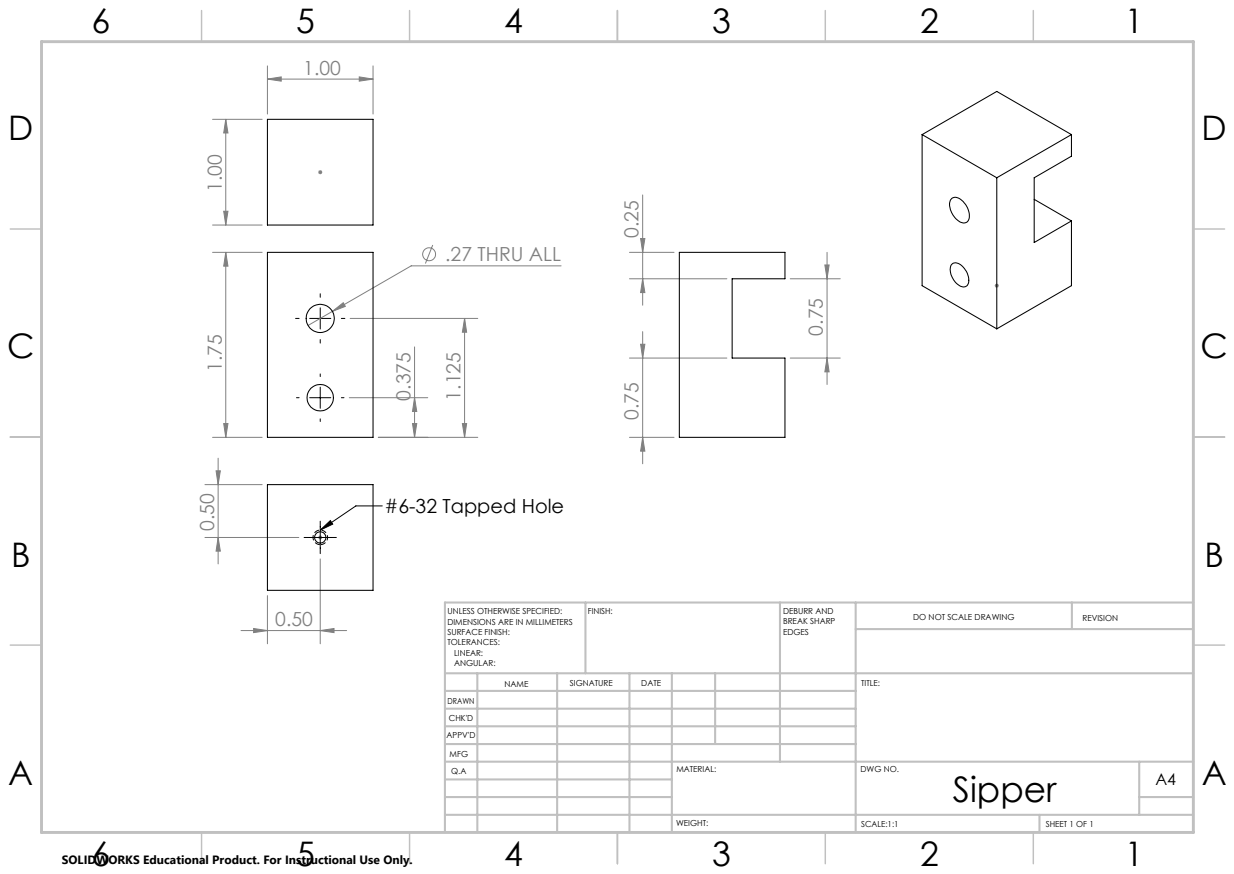
[picture p176: page 1]
.27 THRU ALL; #6-32 Tapped Hole; FINISH:; DEBURR AND; BREAK SHARP; DO NOT SCALE DRAWING; REVISION; SCALE:1:1; SHEET 1 OF 1

UNLESS OTHERWISE SPECIFIED:
DIMENSIONS ARE IN MILLIMETERS
SURFACE FINISH:
TOLERANCES:
LINEAR:
ANGULAR:

NAME | SIGNATURE | DATE | | | | TITLE:

DRAWN
CHK'D
APPV'D
MFG
Q.A | | | | MATERIAL: | DWG NO. Sipper | A4

SOLIDWORKS Educational Product. For Instructional Use Only.
