jamestorrissonwong/NML-CAD/Monkey Cage Training/Monkey Cage Extension/HE2-Series-Mounting-Options.pdf

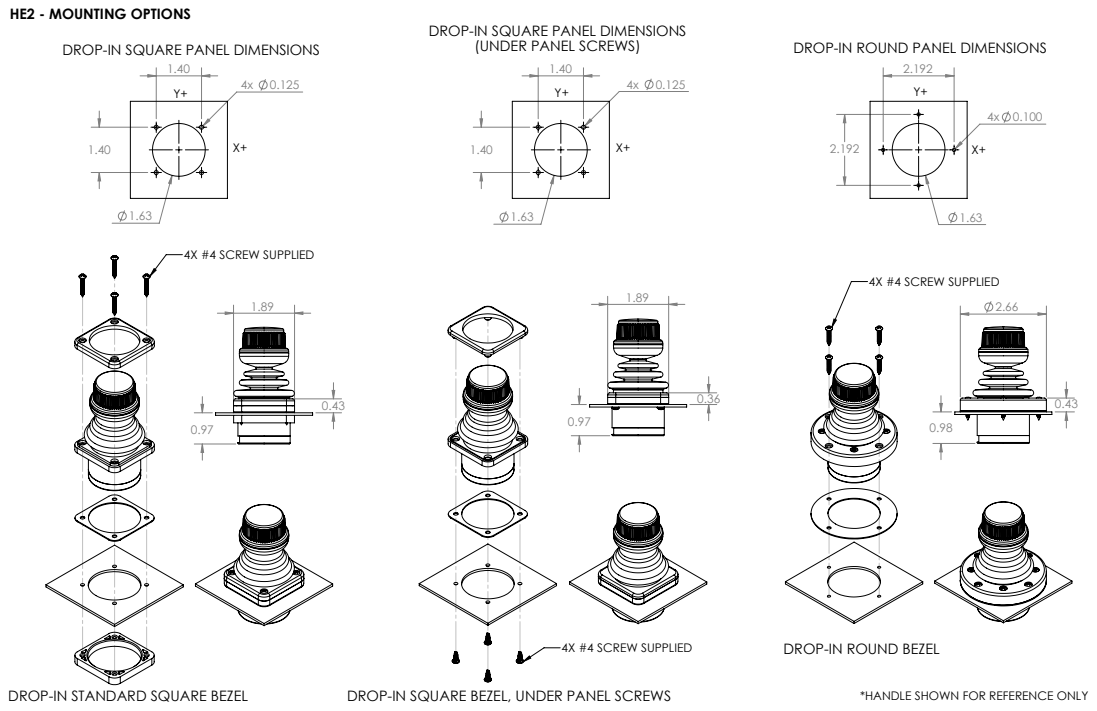
[picture p177: page 1]
4X #4 SCREW SUPPLIED; DROP-IN ROUND BEZEL

HE2 - MOUNTING OPTIONS
DROP-IN SQUARE PANEL DIMENSIONS

(UNDER PANEL SCREWS)

DROP-IN ROUND PANEL DIMENSIONS

DROP-IN STANDARD SQUARE BEZEL

DROP-IN SQUARE BEZEL, UNDER PANEL SCREWS

*HANDLE SHOWN FOR REFERENCE ONLY

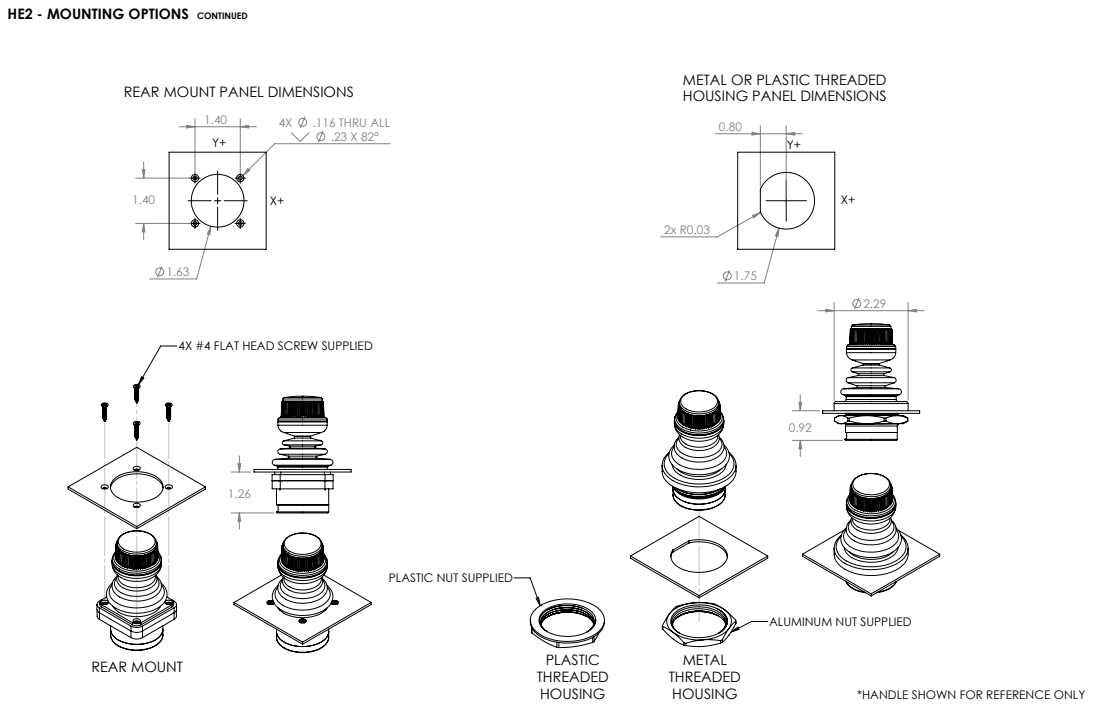
[picture p178: page 2]
REAR MOUNT; .116 THRU ALL

HE2 - MOUNTING OPTIONS CONTINUED

METAL OR PLASTIC THREADED
HOUSING PANEL DIMENSIONS

REAR MOUNT PANEL DIMENSIONS

4X #4 FLAT HEAD SCREW SUPPLIED

PLASTIC NUT SUPPLIED

ALUMINUM NUT SUPPLIED

*HANDLE SHOWN FOR REFERENCE ONLY
