jamestorrissonwong/NML-CAD/Monkey Cage Training/Acrylic ICTS/Thicker/Acrylic-Back-v3.pdf

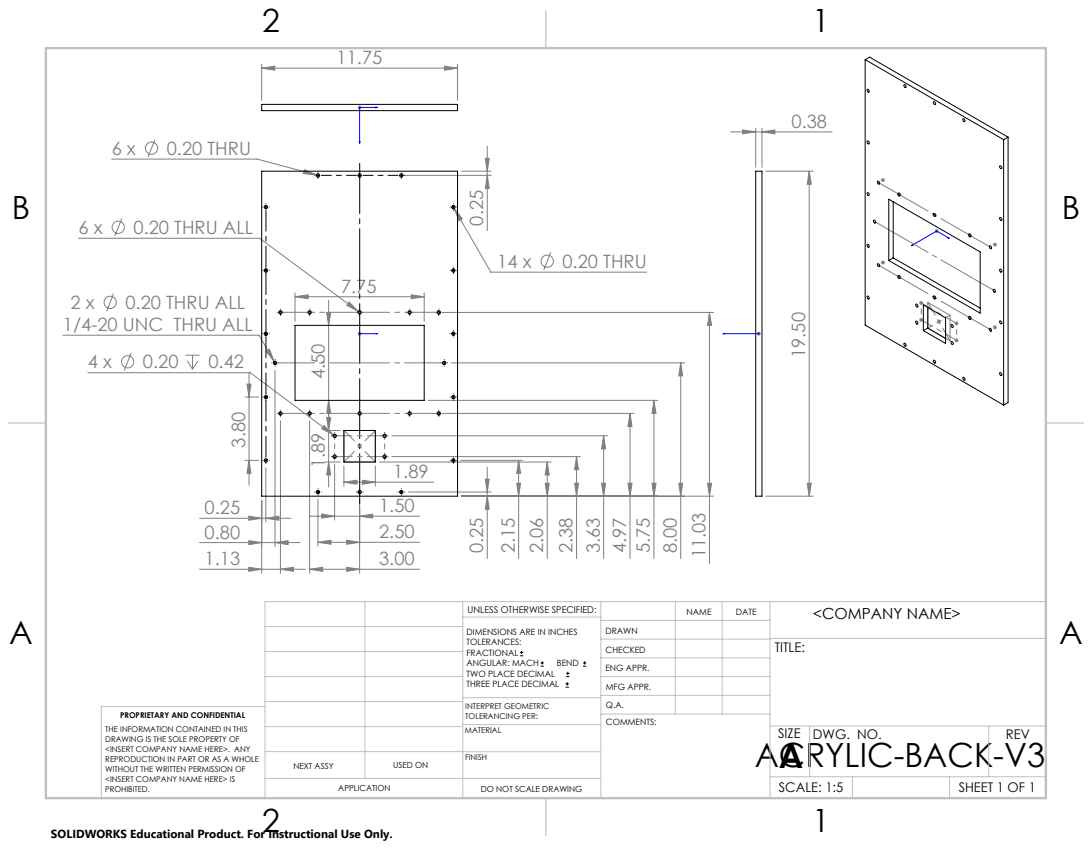
[picture p179: page 1]
0.20 THRU; 0.20 THRU ALL

1/4-20 UNC THRU ALL

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

CHECKED | | | TITLE:

ENG APPR.
MFG APPR.

INTERPRET GEOMETRIC TOLERANCING PER: | Q.A.

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

USED ON | MATERIAL | ACRYLIC-BACK-V3 | SIZE A | DWG. NO. | REV

NEXT ASSY | | FINISH

APPLICATION | DO NOT SCALE DRAWING | | SCALE: 1:5 | | SHEET 1 OF 1

SOLIDWORKS Educational Product. For Instructional Use Only.
