jamestorrissonwong/NML-CAD/Monkey Cage Training/Acrylic ICTS/Drawings/anchor block.pdf

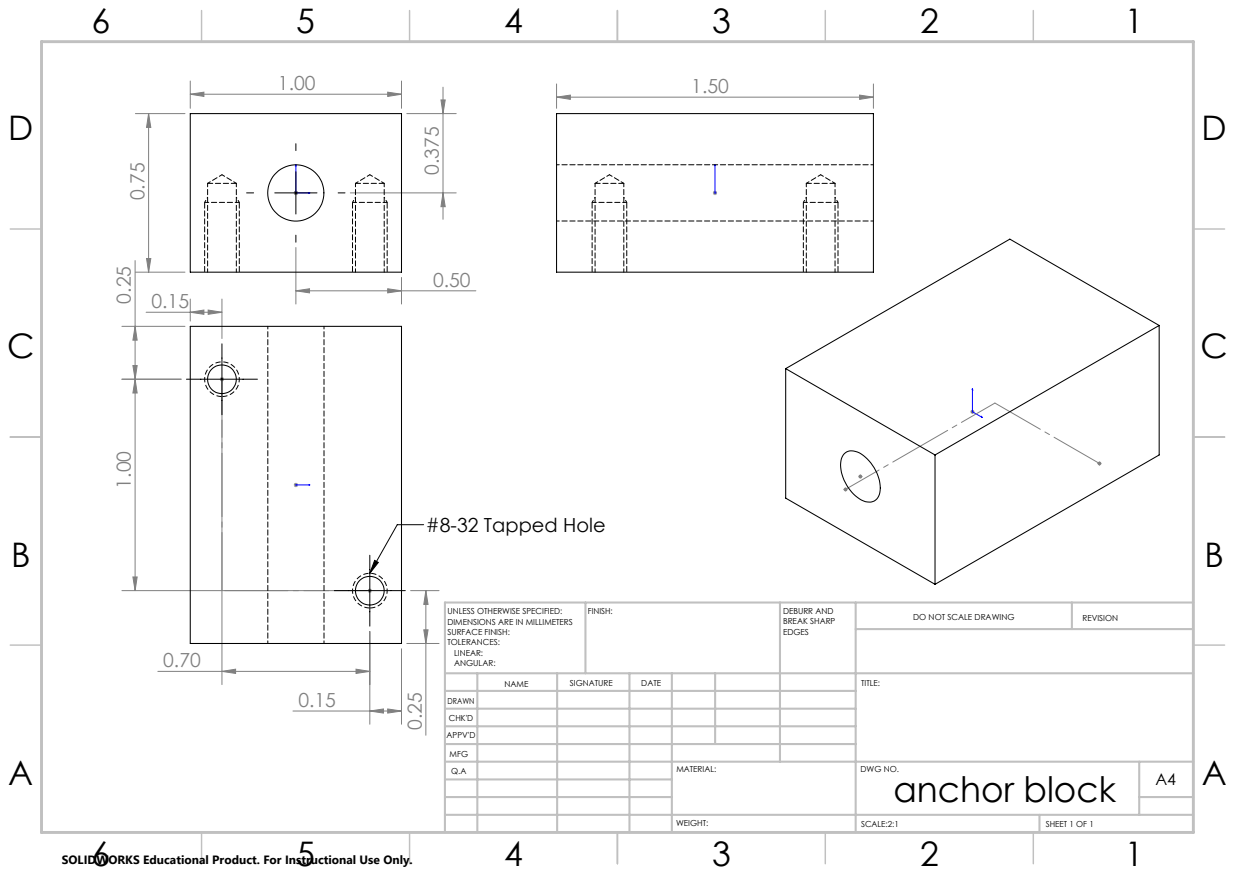
[picture p180: page 1]
#8-32 Tapped Hole; FINISH:; DEBURR AND; BREAK SHARP; DO NOT SCALE DRAWING; REVISION; SCALE:2:1; SHEET 1 OF 1

UNLESS OTHERWISE SPECIFIED:
DIMENSIONS ARE IN MILLIMETERS
SURFACE FINISH:
TOLERANCES:
LINEAR:
ANGULAR:

NAME | SIGNATURE | DATE | | | | TITLE:

DRAWN
CHK'D
APPV'D
MFG
Q.A | | | | MATERIAL: | DWG NO. anchor block | A4

SOLIDWORKS Educational Product. For Instructional Use Only.
