jamestorrissonwong/NML-CAD/Monkey Cage Training/Acrylic ICTS/Drawings/Bottom Slider Plate.pdf

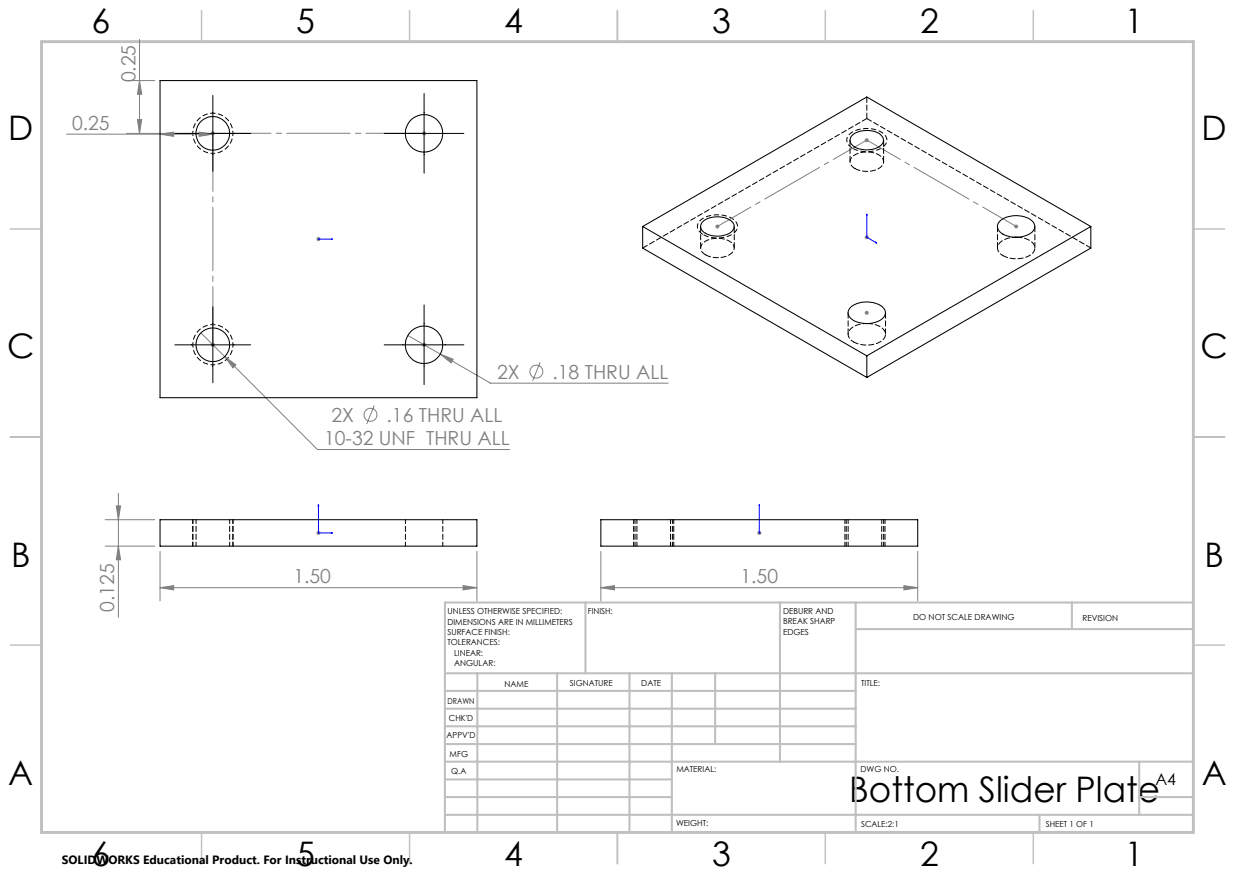
[picture p181: page 1]
.18 THRU ALL; .16 THRU ALL; FINISH:; DEBURR AND; BREAK SHARP; DO NOT SCALE DRAWING; REVISION; SCALE:2:1; SHEET 1 OF 1

10-32 UNF THRU ALL

UNLESS OTHERWISE SPECIFIED:
DIMENSIONS ARE IN MILLIMETERS
SURFACE FINISH:
TOLERANCES:
LINEAR:
ANGULAR:

NAME | SIGNATURE | DATE | | | | TITLE:

DRAWN
CHK'D
APPV'D
MFG
Q.A | | | | MATERIAL: Bottom Slider Plate | DWG NO. | A4

SOLIDWORKS Educational Product. For Instructional Use Only.
