jamestorrissonwong/NML-CAD/Monkey Cage Training/Acrylic ICTS/Thicker/overall-dimensions.PDF

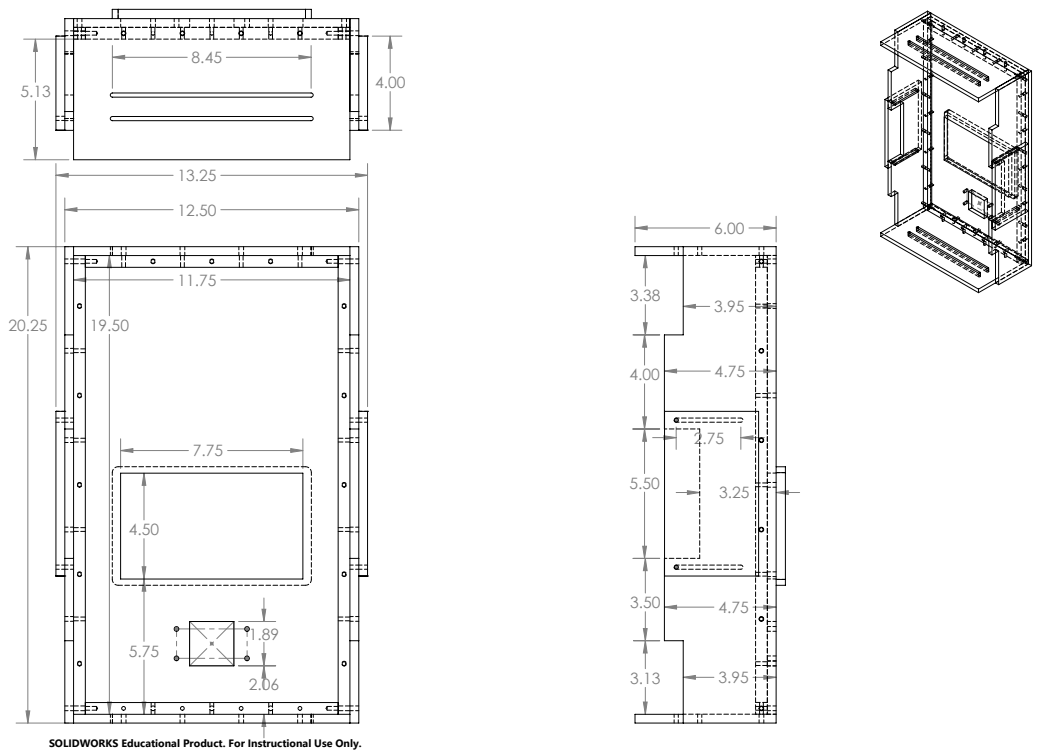
[picture p182: page 1]

SOLIDWORKS Educational Product. For Instructional Use Only.
