jamestorrissonwong/NML-CAD/Monkey Sippers/Monkey Sipper/Machined Parts Drawings/Sipper.pdf

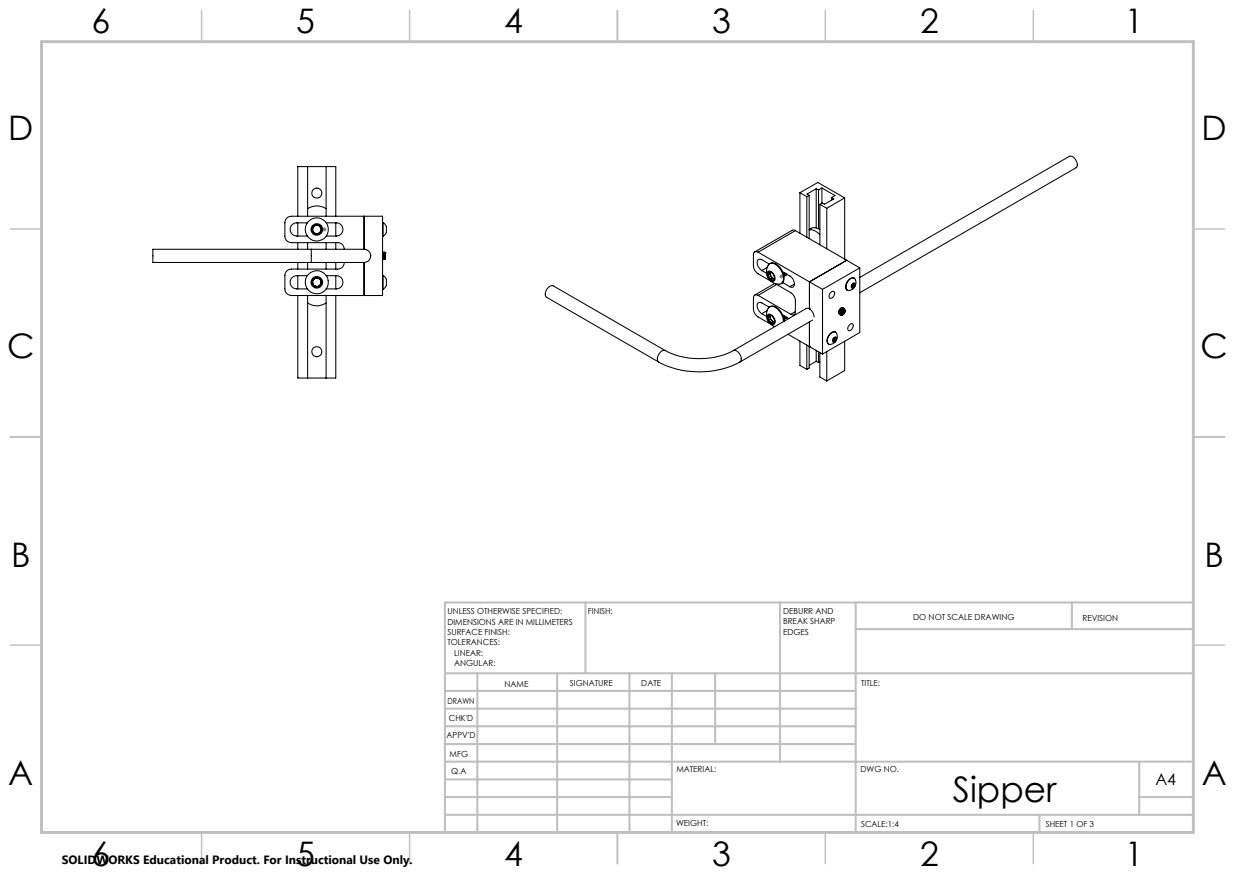
[picture p183: page 1]
FINISH:; DEBURR AND; BREAK SHARP; DO NOT SCALE DRAWING; REVISION; SCALE:1:4; SHEET 1 OF 3

UNLESS OTHERWISE SPECIFIED:
DIMENSIONS ARE IN MILLIMETERS
SURFACE FINISH:
TOLERANCES:
LINEAR:
ANGULAR:

NAME | SIGNATURE | DATE | | | | TITLE:

DRAWN
CHK'D
APPV'D
MFG
Q.A | | | | MATERIAL: | DWG NO. Sipper | A4

SOLIDWORKS Educational Product. For Instructional Use Only.

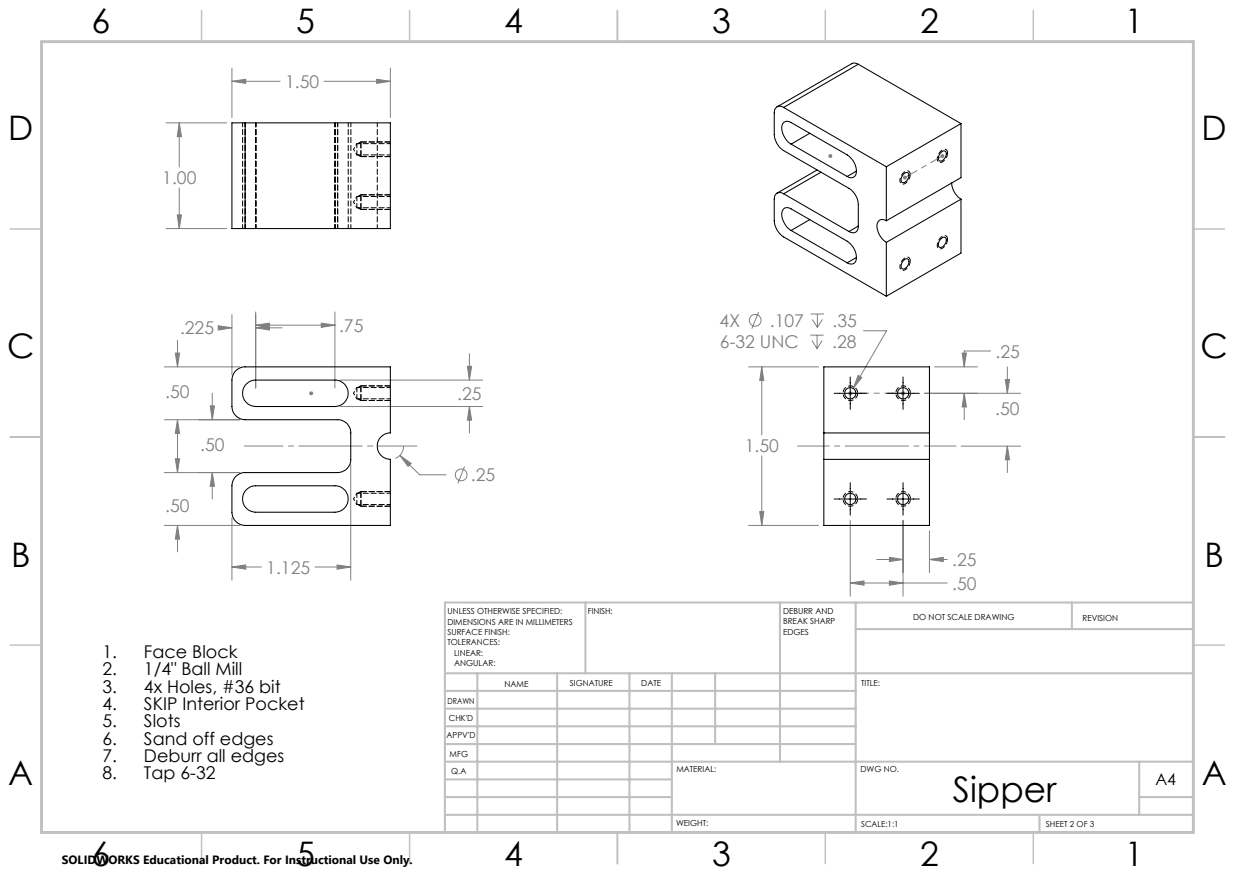
[picture p184: page 2]
6-32 UNC; 7. Deburr all edges A; 8. Tap 6-32; FINISH:; DEBURR AND; BREAK SHARP; DO NOT SCALE DRAWING; REVISION; SCALE:1:1; SHEET 2 OF 3

UNLESS OTHERWISE SPECIFIED:
DIMENSIONS ARE IN MILLIMETERS
SURFACE FINISH:
TOLERANCES:
LINEAR:
ANGULAR:

1. Face Block
2. 1/4" Ball Mill
3. 4x Holes, #36 bit
4. SKIP Interior Pocket
5. Slots
6. Sand off edges

NAME | SIGNATURE | DATE | | | | TITLE:

DRAWN
CHK'D
APPV'D
MFG
Q.A | | | | MATERIAL: | DWG NO. Sipper | A4

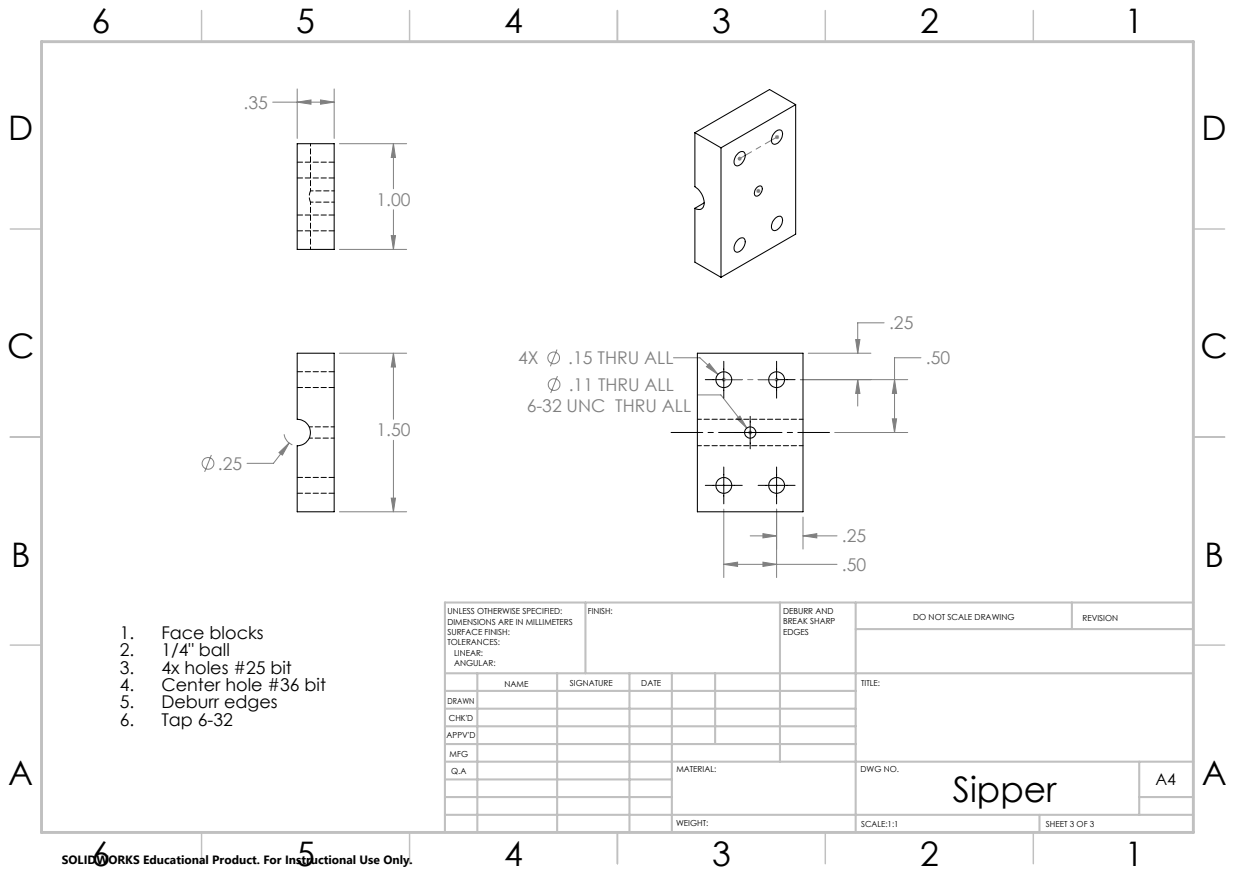
[picture p185: page 3]
.15 THRU ALL; FINISH:; DEBURR AND; BREAK SHARP; DO NOT SCALE DRAWING; REVISION; SCALE:1:1; SHEET 3 OF 3

.11 THRU ALL
6-32 UNC THRU ALL

UNLESS OTHERWISE SPECIFIED:
DIMENSIONS ARE IN MILLIMETERS
SURFACE FINISH:
TOLERANCES:
LINEAR:
ANGULAR:

1. Face blocks
2. 1/4" ball
3. 4x holes #25 bit
4. Center hole #36 bit
5. Deburr edges
6. Tap 6-32

NAME | SIGNATURE | DATE | | | | TITLE:

DRAWN
CHK'D
APPV'D
MFG
Q.A | | | | MATERIAL: | DWG NO. Sipper | A4
