jamestorrissonwong/NML-CAD/PCBs/7ac76369a0fd96fdd889728fa7417171.kicad_pcb

## KiCad design PCBs/7ac76369a0fd96fdd889728fa7417171.kicad_pcb (2022-02-23)

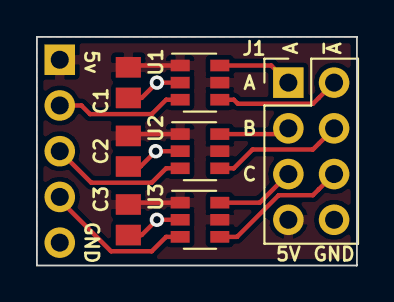
[picture p186: board 7ac76369a0fd96fdd889728fa7417171.kicad_pcb from above]

Board: 2 copper layers, 17.8 x 12.7 mm, 8 parts (1 on the bottom side), 11 nets.

Parts:
C1, C2, C3: 100nF; C_0805_2012Metric
J1: Conn_02x04_Odd_Even; PinHeader_2x04_P2.54mm_Vertical
J2: ODrive Connector; PinHeader_1x05_P2.54mm_Vertical
U1, U2, U3: MAX3284E; SOT-23-6

Connections:
+5V: C1.1, C2.1, C3.1, J1.7, J2.1, U1.1, U1.5, U2.1, U2.5, U3.1, U3.5
/A: J1.1, U1.6
/A_Out: J2.2, U1.3
/B: J1.3, U2.6
/B_Out: J2.3, U2.3
/Z: J1.5, U3.6
/Z_Out: J2.4, U3.3
/~A: J1.2, U1.4
/~B: J1.4, U2.4
/~Z: J1.6, U3.4
GND: C1.2, C2.2, C3.2, J1.8, J2.5, U1.2, U2.2, U3.2
