jamestorrissonwong/NML-CAD/!archived/New folder/Intan Headstage.brd

## EAGLE design !archived/New folder/Intan Headstage.brd (2021-08-28, an earlier design)

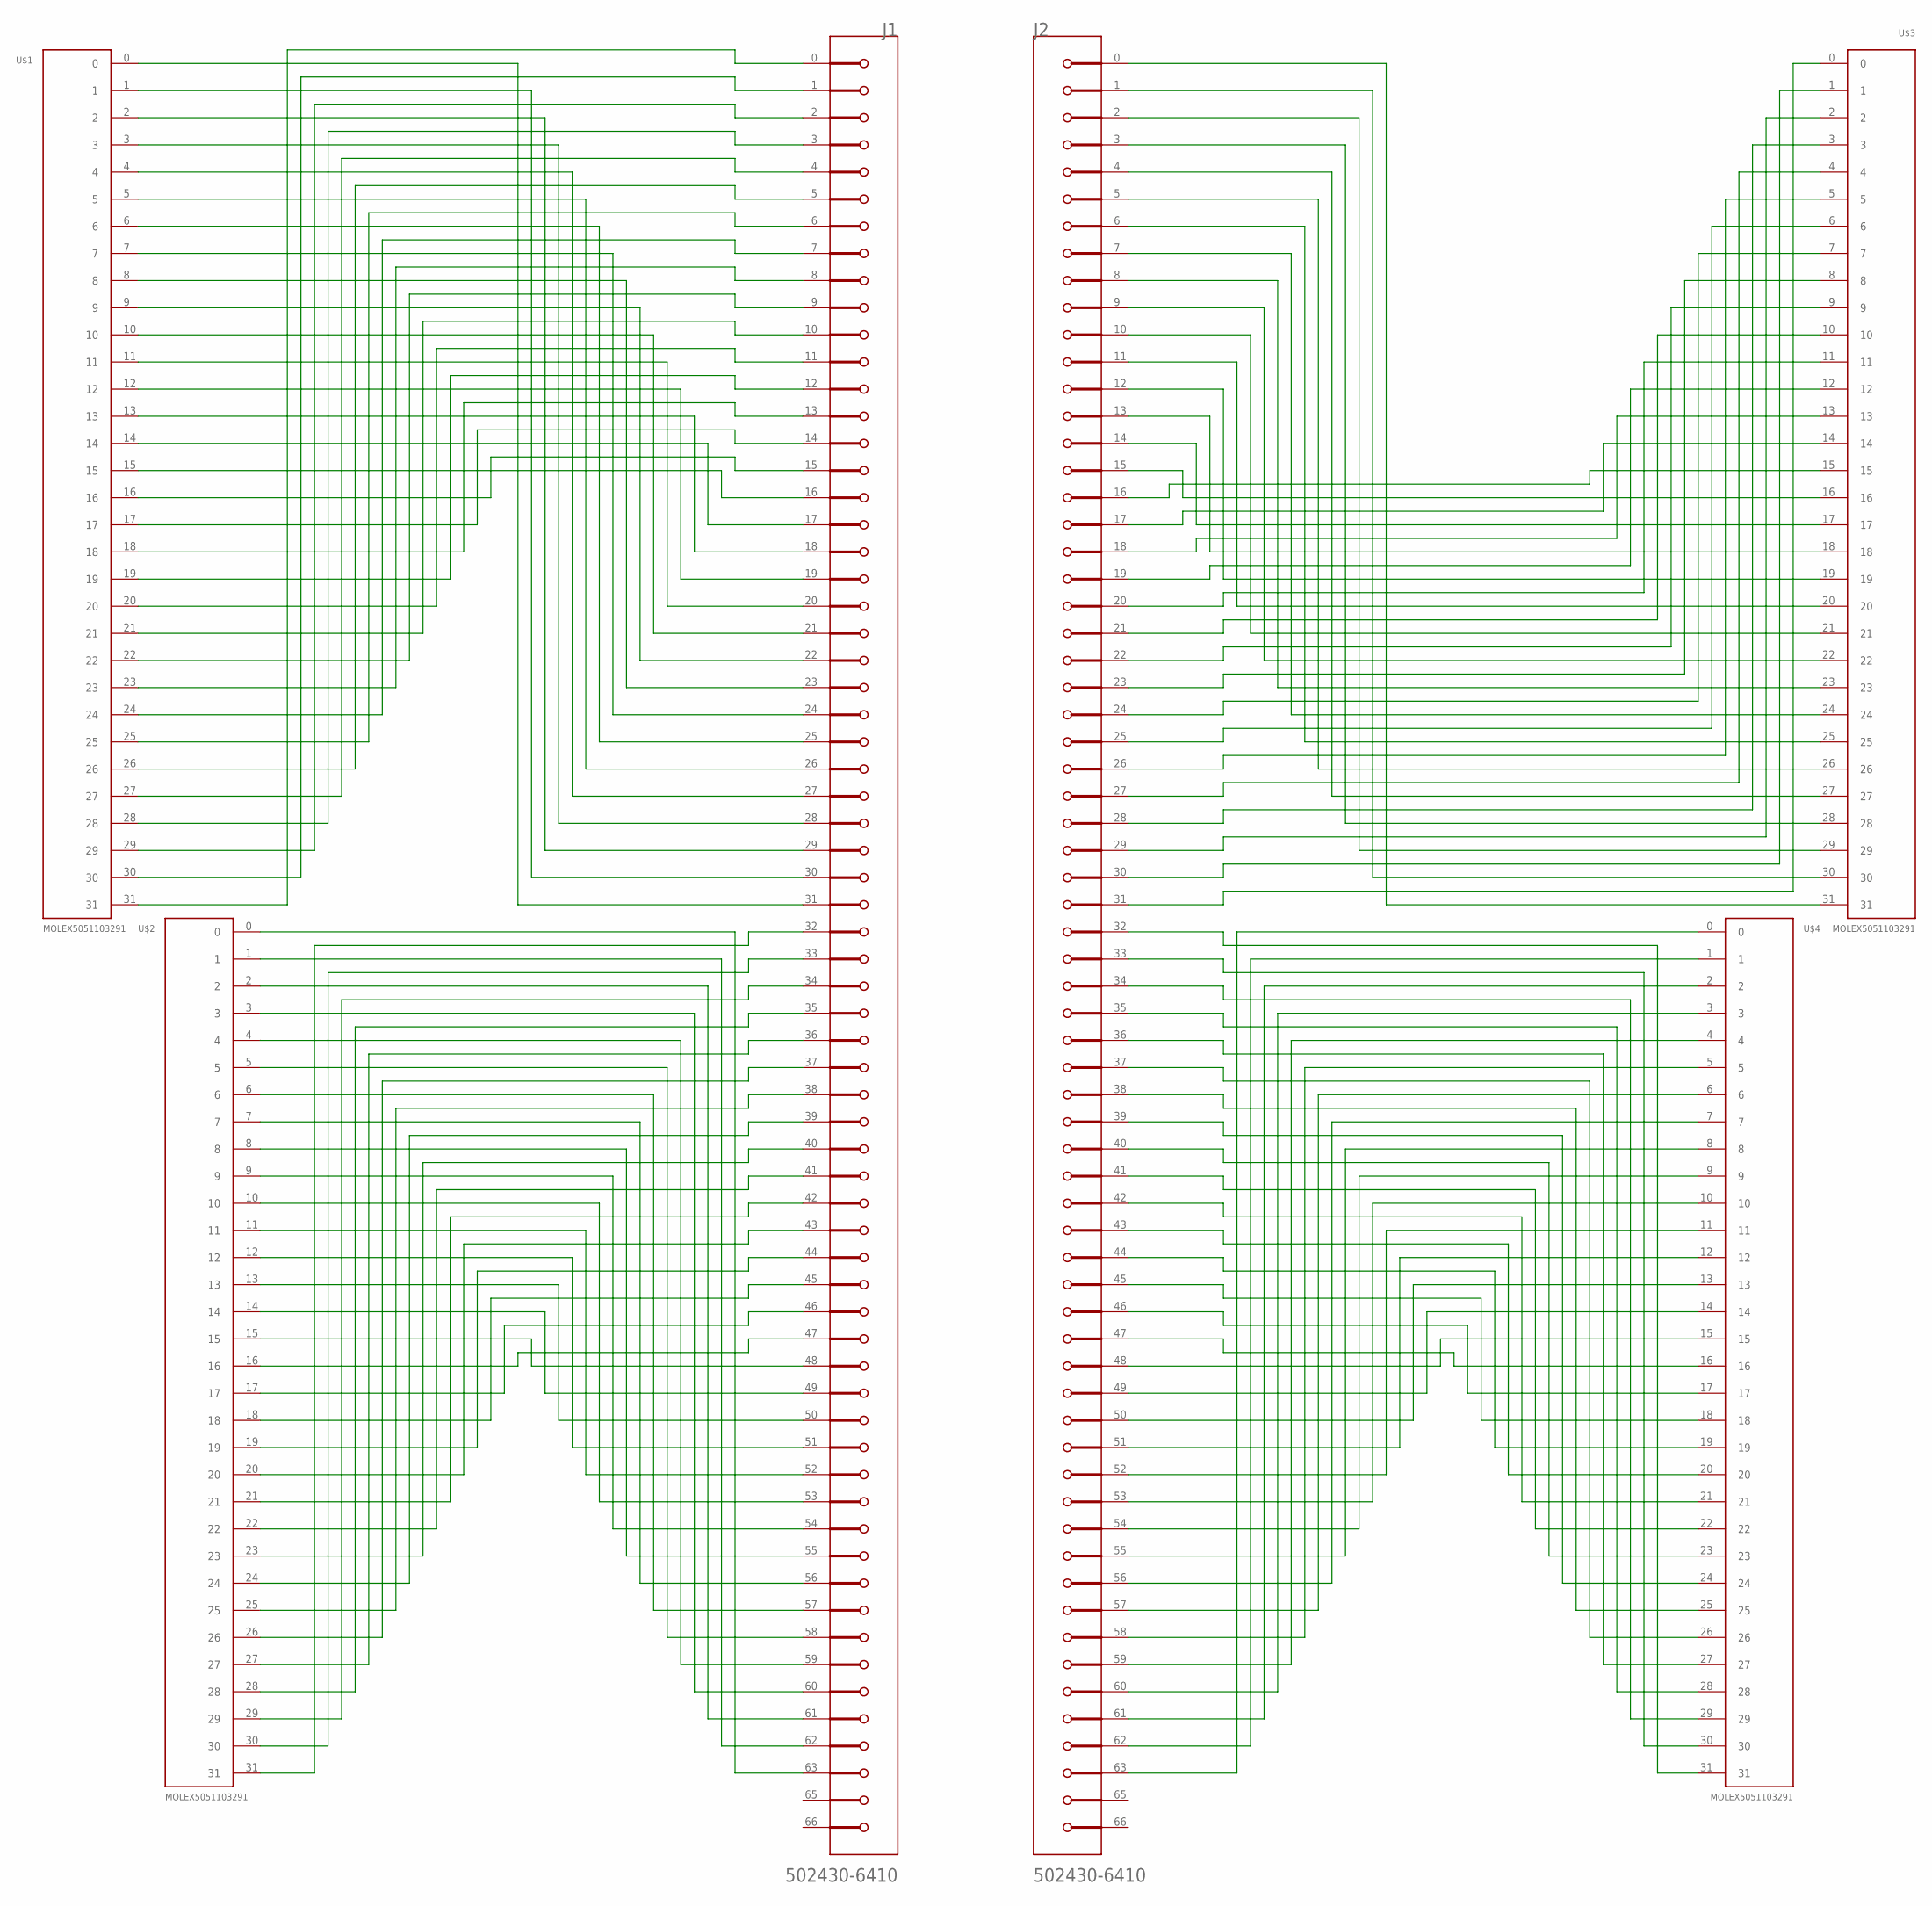
[picture p187: schematic Intan Headstage.sch]

Parts:
J1, J2: MOLEX_502430-6410MOLEX_502430-6410_0_0; MOLEX_502430-6410_0
U$1, U$2, U$3, U$4: MOLEX5051103291

Connections:
unnamed: J1.31 (32), U$1.0
unnamed: J1.30 (31), U$1.1
unnamed: J1.29 (30), U$1.2
unnamed: J1.28 (29), U$1.3
unnamed: J1.27 (28), U$1.4
unnamed: J1.26 (27), U$1.5
unnamed: J1.25 (26), U$1.6
unnamed: J1.24 (25), U$1.7
unnamed: J1.23 (24), U$1.8
unnamed: J1.22 (23), U$1.9
unnamed: J1.21 (22), U$1.10
unnamed: J1.20 (21), U$1.11
unnamed: J1.19 (20), U$1.12
unnamed: J1.18 (19), U$1.13
unnamed: J1.17 (18), U$1.14
unnamed: J1.16 (17), U$1.15
unnamed: J1.15 (16), U$1.16
unnamed: J1.14 (15), U$1.17
unnamed: J1.13 (14), U$1.18
unnamed: J1.12 (13), U$1.19
unnamed: J1.11 (12), U$1.20
unnamed: J1.10 (11), U$1.21
unnamed: J1.9 (10), U$1.22
unnamed: J1.8 (9), U$1.23
unnamed: J1.7 (8), U$1.24
unnamed: J1.6 (7), U$1.25
unnamed: J1.5 (6), U$1.26
unnamed: J1.4 (5), U$1.27
unnamed: J1.3 (4), U$1.28
unnamed: J1.2 (3), U$1.29
unnamed: J1.1 (2), U$1.30
unnamed: J1.0 (1), U$1.31
unnamed: J2.0 (1), U$3.31
unnamed: J2.1 (2), U$3.30
unnamed: J2.2 (3), U$3.29
unnamed: J2.3 (4), U$3.28
unnamed: J2.4 (5), U$3.27
unnamed: J2.5 (6), U$3.26
unnamed: J2.6 (7), U$3.25
unnamed: J2.7 (8), U$3.24
unnamed: J2.8 (9), U$3.23
unnamed: J2.9 (10), U$3.22
unnamed: J2.10 (11), U$3.21
unnamed: J2.11 (12), U$3.20
unnamed: J2.12 (13), U$3.19
unnamed: J2.13 (14), U$3.18
unnamed: J2.14 (15), U$3.17
unnamed: J2.15 (16), U$3.16
unnamed: J2.31 (32), U$3.0
unnamed: J2.30 (31), U$3.1
unnamed: J2.29 (30), U$3.2
unnamed: J2.28 (29), U$3.3
unnamed: J2.27 (28), U$3.4
unnamed: J2.26 (27), U$3.5
unnamed: J2.25 (26), U$3.6
unnamed: J2.24 (25), U$3.7
unnamed: J2.23 (24), U$3.8
unnamed: J2.22 (23), U$3.9
unnamed: J2.21 (22), U$3.10
unnamed: J2.20 (21), U$3.11
unnamed: J2.19 (20), U$3.12
unnamed: J2.18 (19), U$3.13
unnamed: J2.17 (18), U$3.14
unnamed: J2.16 (17), U$3.15
unnamed: J1.63 (64), U$2.0
unnamed: J1.62 (63), U$2.1
unnamed: J1.61 (62), U$2.2
unnamed: J1.60 (61), U$2.3
unnamed: J1.59 (60), U$2.4
unnamed: J1.58 (59), U$2.5
unnamed: J1.57 (58), U$2.6
unnamed: J1.56 (57), U$2.7
unnamed: J1.55 (56), U$2.8
unnamed: J1.54 (55), U$2.9
unnamed: J1.53 (54), U$2.10
unnamed: J1.52 (53), U$2.11
unnamed: J1.51 (52), U$2.12
unnamed: J1.50 (51), U$2.13
unnamed: J1.49 (50), U$2.14
unnamed: J1.48 (49), U$2.15
unnamed: J1.47 (48), U$2.16
unnamed: J1.46 (47), U$2.17
unnamed: J1.45 (46), U$2.18
unnamed: J1.44 (45), U$2.19
unnamed: J1.43 (44), U$2.20
unnamed: J1.42 (43), U$2.21
unnamed: J1.41 (42), U$2.22
unnamed: J1.40 (41), U$2.23
unnamed: J1.39 (40), U$2.24
unnamed: J1.38 (39), U$2.25
unnamed: J1.37 (38), U$2.26
unnamed: J1.36 (37), U$2.27
unnamed: J1.35 (36), U$2.28
unnamed: J1.34 (35), U$2.29
unnamed: J1.33 (34), U$2.30
unnamed: J1.32 (33), U$2.31
unnamed: J2.32 (33), U$4.31
unnamed: J2.33 (34), U$4.30
unnamed: J2.34 (35), U$4.29
unnamed: J2.35 (36), U$4.28
unnamed: J2.36 (37), U$4.27
unnamed: J2.37 (38), U$4.26
unnamed: J2.38 (39), U$4.25
unnamed: J2.39 (40), U$4.24
unnamed: J2.40 (41), U$4.23
unnamed: J2.41 (42), U$4.22
unnamed: J2.42 (43), U$4.21
unnamed: J2.43 (44), U$4.20
unnamed: J2.44 (45), U$4.19
unnamed: J2.45 (46), U$4.18
unnamed: J2.46 (47), U$4.17
unnamed: J2.47 (48), U$4.16
unnamed: J2.48 (49), U$4.15
unnamed: J2.49 (50), U$4.14
unnamed: J2.50 (51), U$4.13
unnamed: J2.51 (52), U$4.12
unnamed: J2.52 (53), U$4.11
unnamed: J2.53 (54), U$4.10
unnamed: J2.54 (55), U$4.9
unnamed: J2.55 (56), U$4.8
unnamed: J2.56 (57), U$4.7
unnamed: J2.57 (58), U$4.6
unnamed: J2.58 (59), U$4.5
unnamed: J2.59 (60), U$4.4
unnamed: J2.60 (61), U$4.3
unnamed: J2.61 (62), U$4.2
unnamed: J2.62 (63), U$4.1
unnamed: J2.63 (64), U$4.0

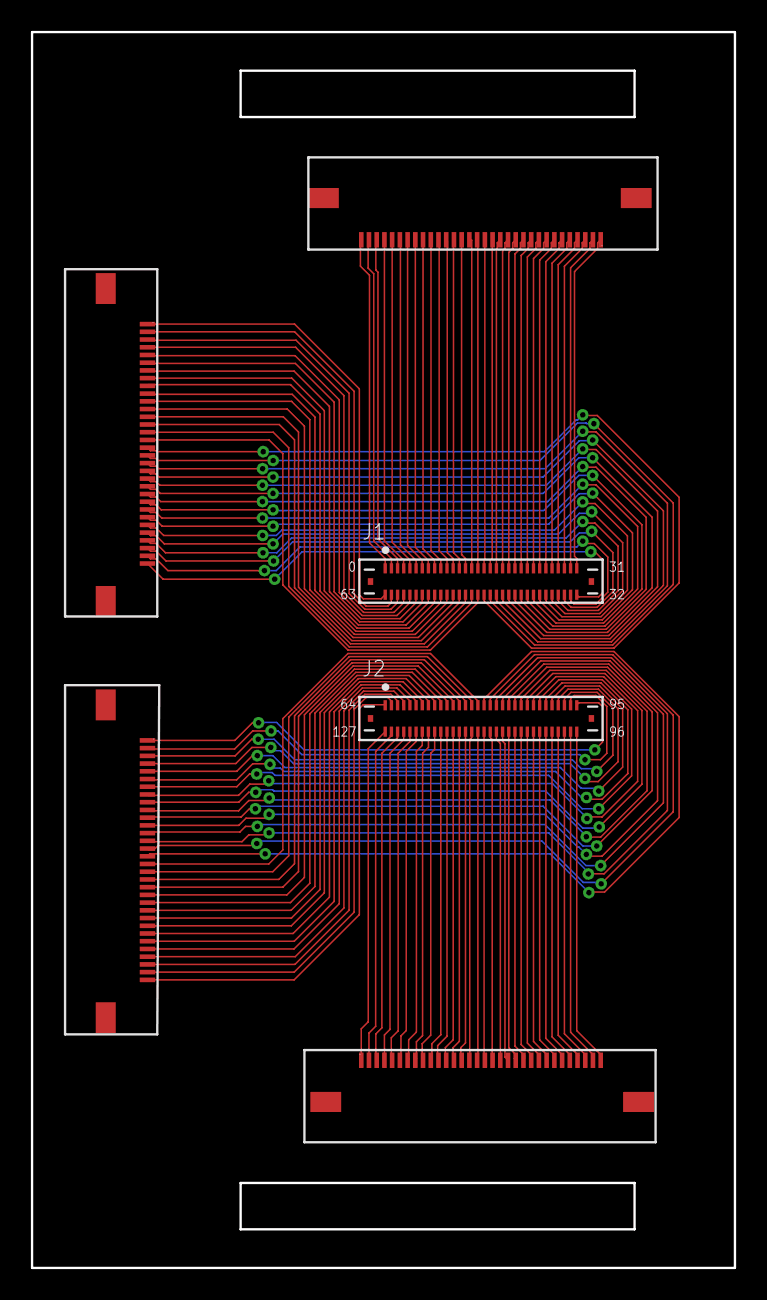
[picture p188: board Intan Headstage.brd from above]

Board: 2 copper layers, 45.5 x 80.0 mm, 6 parts (0 on the bottom side), 128 nets.
