jamestorrissonwong/NML-CAD/(commit log)

2021-08-03 8/3/21 v2
    [1151A62_SURFACE-MOUNT LIFT-OFF HINGES WITH HOLES.SLDPRT, 11605A190_WORK-LOAD RATED EXPOSED ADJUSTABLE DRAW LATCH.SLDPRT, 11605A220_ADJUSTABLE-GRIP DRAW LATCH.SLDPRT, 1730A91_VINYL-COATED HOOK.SLDPRT, 2313N48_CORNER MACHINE BRACKET.SLDPRT, 3136N111_T-SLOTTED FRAMING.SLDPRT, 4592T314_ANODIZED ARCHITECTURAL 6063 ALUMINUM U-CHANNEL.SLDPRT, 4630T275_Anodized Architectural 6063 Aluminum 90 Degree Angle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]
2021-12-15 XPS 12/15
    [1088A41_INSIDE-CORNER REINFORCING BRACKET.SLDPRT, 11605A220_ADJUSTABLE-GRIP DRAW LATCH.SLDPRT, 15275A51_Corner Bracket.SLDPRT, 1850A11_18 Long T-Track Fixturing Track.SLDPRT, 1950A65_Unthreaded-Hole Pull Handle.SLDPRT, 2480N24_Food Industry Threaded-Hole Pull Handle.SLDPRT, 2480N24_Food Industry Threaded-Hole Pull Handle.STEP, 33125T407_Strut Channel Bracket.SLDPRT]
2021-12-19 max manip mods
    [4634T361_Multipurpose 6061 Aluminum.SLDPRT, 8975K832_MULTIPURPOSE 6061 ALUMINUM.SLDPRT, 8975K863_MULTIPURPOSE 6061 ALUMINUM.SLDPRT, 94669A063_Aluminum Unthreaded Spacer.SLDPRT, AA3.SLDASM, Acrylic.SLDPRT, Delrin.SLDPRT, Inner Horizontal.SLDPRT]
2021-12-23 DT 12-23
    [1088A41_INSIDE-CORNER REINFORCING BRACKET.SLDPRT, 11605A220_ADJUSTABLE-GRIP DRAW LATCH.SLDPRT, 1950A65_Unthreaded-Hole Pull Handle.SLDPRT, 3-8 version.SLDASM, 4630T178_Anodized Architectural 6063 Aluminum 90 Degree Angle.SLDPRT, 8982K151_Multipurpose 6061 Aluminum 90 Degree Angle.SLDPRT, 91255A816_Button Head Hex Drive Screw.SLDPRT, 91592A185_STEEL ROUND HOOK HOLD-DOWN BOLT.SLDPRT]
2022-01-06 DT 1/5/22
    [3-8 version.SLDASM, 5071A714_Latch-Style Toggle Clamp.SLDPRT, 8982K151_Multipurpose 6061 Aluminum 90 Degree Angle.SLDPRT, Acrylic.SLDPRT, Delrin.SLDPRT, ICTS-Drawings.SLDDRW, cut profiles.SLDASM]
2022-02-23 2/6/22 -- before icts rail updates + 2/22/22 ICTS
    [2480N24_Food Industry Threaded-Hole Pull Handle.STEP, 3-8 version.SLDASM, 37d-gearmotor-100-131-150-encoder.step, 37d-gearmotor-100-131-150.step, 37d-gearmotor-19-30-encoder.step, 37d-gearmotor-19-30.step, 37d-gearmotor-50-70-encoder.step, 37d-gearmotor-50-70.step]
